faberc/ece-540_wi21_fnl-project/rvfpga/vivado/project_final/project_final.runs/impl_3/.init_design.begin.rst

<?xml version="1.0"?>
<ProcessHandle Version="1" Minor="0">
    <Process Command=".planAhead." Owner="Chuck" Host="DESKTOP-HHTTKMG" Pid="9632">
    </Process>
</ProcessHandle>
