faberc/ece-540_wi21_fnl-project/rvfpga/vivado/project_final/project_final.runs/clk_gen_75M_synth_1/.vivado.begin.rst

<?xml version="1.0"?>
<ProcessHandle Version="1" Minor="0">
    <Process Command="vivado.bat" Owner="Chuck" Host="DESKTOP-HHTTKMG" Pid="44392" HostCore="8" HostMemory="016745943040">
    </Process>
</ProcessHandle>
