faberc/ece-540_wi21_fnl-project/rvfpga/vivado/project_2/project_2.runs/impl_1/.vivado.begin.rst

<?xml version="1.0"?>
<ProcessHandle Version="1" Minor="0">
    <Process Command="vivado.bat" Owner="Chuck" Host="DESKTOP-HHTTKMG" Pid="11348" HostCore="8" HostMemory="016745943040">
    </Process>
</ProcessHandle>
