faberc/ece-540_wi21_fnl-project/rvfpga/vivado/project_2a/project_2a.runs/synth_1/.vivado.begin.rst

<?xml version="1.0"?>
<ProcessHandle Version="1" Minor="0">
    <Process Command="vivado.bat" Owner="Chuck" Host="DESKTOP-HHTTKMG" Pid="26424" HostCore="8" HostMemory="016745943040">
    </Process>
</ProcessHandle>
