faberc/ece-540_wi21_fnl-project/rvfpga/labs/Project1/Project_1_Report.pdf

# Project 1: SimpleBot

Theory of Operations

### Chuck Faber

Portland State University - ECE 540 - Winter 2020

## I. Design Summary

In this project we were tasked with creang a simulaon of a simple 2-wheel robot, with a seven segment display which would display a moon animaon and its compass heading based on the input of 4 buons to control the le and right motors. The compass heading would be determined with dead reckoning, and the project firmware would be implemented using the Nexys A7 Development board, and the soware was to be wrien in RISC-V assembly language.

Several modificaons needed to be made to the firmware to enable hardware, such as the push buons and extended capability of the seven segment display (more characters and addion of decimal points). Primary goals in the soware were responsiveness of the buons and cleanness of the displays with few to no bugs in the display of the headings and moon indicator.

## II. Firmware Modifications

Implementing new GPIO registers

Implementing Buttons in Constraints File
In order to get the push-buons connected, I first had to add their mapping in the firmware constraints file. See Box 1.

Box 1: rvfpga.xdc - Mapping buon pins to new signals in firmware code

Mux Code / New Address Declaration
A new GPIO module needed to be instanated in swervolf_core.v. A new base address for this GPIO module also needed to be included in wb_intercon.v with its own signals, as shown in box 2 below.

## Buttons

set_property -dict { PACKAGE_PIN M18 | IOSTANDARD LVCMOS33 } [get_ports { i_btn_u }];
set_property -dict { PACKAGE_PIN P18 | IOSTANDARD LVCMOS33 } [get_ports { i_btn_d }];
set_property -dict { PACKAGE_PIN P17 | IOSTANDARD LVCMOS33 } [get_ports { i_btn_l }];
set_property -dict { PACKAGE_PIN M17 | IOSTANDARD LVCMOS33 } [get_ports { i_btn_r }];
set_property -dict { PACKAGE_PIN N17 | IOSTANDARD LVCMOS33 } [get_ports { i_btn_c }];

Box 2: wb_intercon.v - Added new base address and column to Wishbone Mux

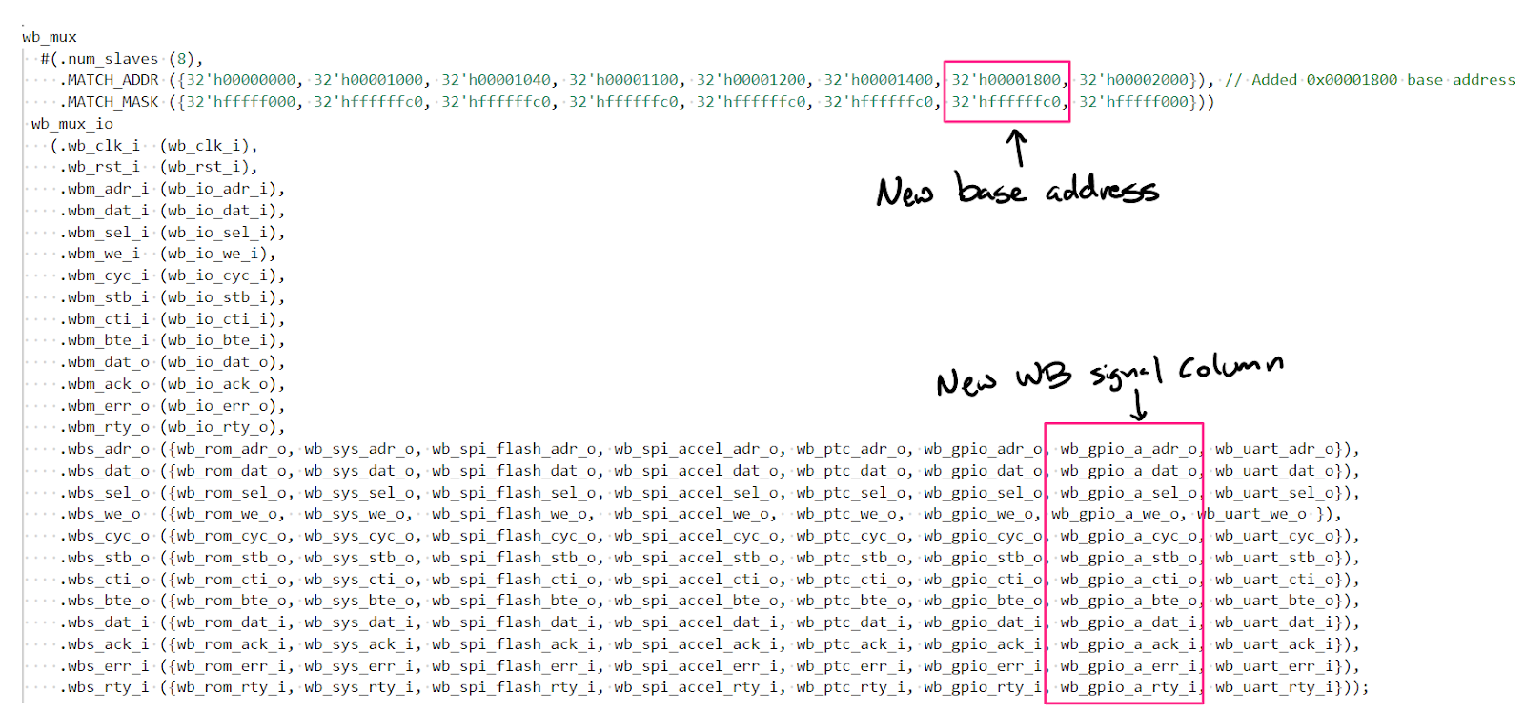
[picture p8: figure]

Passing in the Buttons as an Array
The buons declared in the constraints file needed to be connected to the swervolf_core module through a newly declared 32 bit io_data port which was done as follows. Note that the unused 27 most significant bits allows future addion of new peripherals to this GPIO module as shown in box 3. Also the order in which the buons inputs are passed to the io_data port are important to consider as well, as they will determine how to decode the values read from the new GPIO module’s register.

Box 3: rvfpga.sv - swervolf_core instanaon -- passing in buon press inputs to second gpio port

Seven Segment Display
The project requirements ask us to implement new characters to be used for the seven segment display. The current decoder only took 4 bits in, which allowed us to choose between 16 different characters, so to expand the number of possible characters, we had to expand this input to 8 bits.

The goal was to implement all the characters with their associated values from Table 2 of the project descripon which added 16 addional characters to be able to be displayed.

The current method in which the seven segment decoder was implemented was to use a single 32 bit Digits_Reg to store 8 groups of 4-bit segments, each which was responsible for a single digit in the seven-segment display.

Instead, I wanted each byte to represent a single digit on the SSD, and so I would need a second Digits_Reg register. For example, to write the number 76543210 to the SSD, I would store the following values in Digits_Reg1 and Digits_Reg2:

.io_data | ({i_sw[15:0],gpio_out[15:0]}),
.io_data_a | ({27'bz,i_btn_u,i_btn_d,i_btn_l,i_btn_r,i_btn_c}),

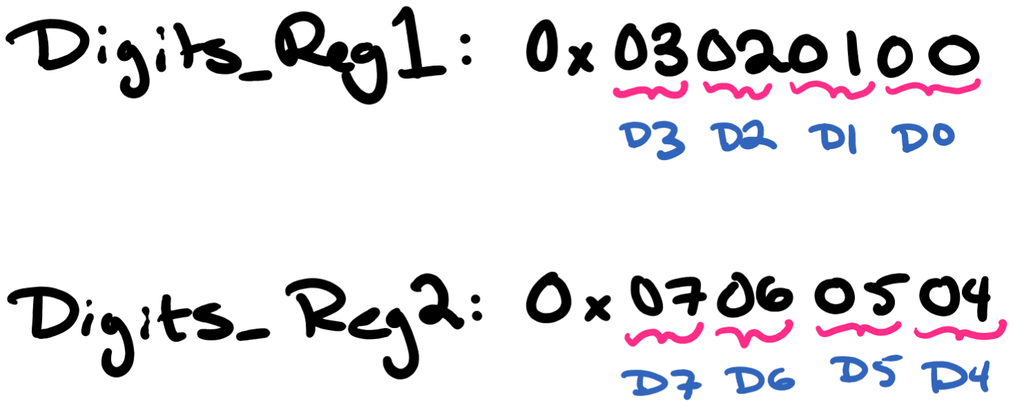
[picture p9: figure]

And each register would correspond to the following digits on the SSD:

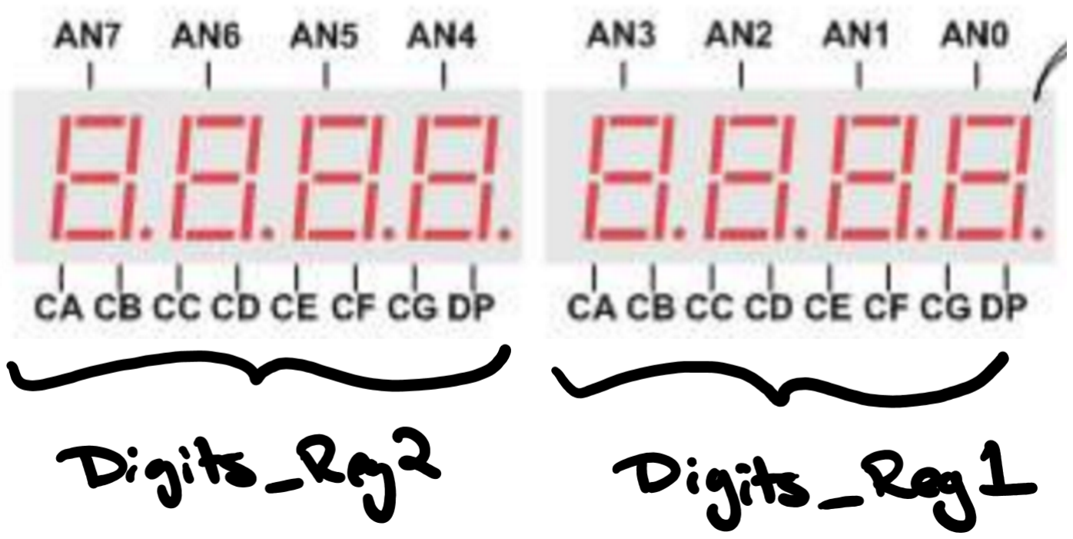
[picture p10: figure]

Implementing New SSD Digits Register
The Enables_Reg and the Digits_Reg base addresses were implemented in a switch case in swervolf_syscon.v and the looked as follows (note some changes implemented to include a decimal enable funconality into the Enables_Reg):

Box 4: swervolf_syscon.v - Digits_Reg2 and adding 8 bits for decimal point enables in Enables_Reg address

Each case in this switch case represented an offset address with each new case being 4 addresses more than the previous, with a byte select of 0-3. To add a new register, I
implemented a new case at ‘9’ which represented the address 0x80001024, and I had this represent Digits_Reg1 (digits 0-3) and let the prior case at ‘15’ represent Digits_Reg2 (digits 4-7).

We didn’t end up needing digits 4-7 for this project, but I felt it was useful to have them accessible in case we might need them later.

14 : begin //0x38-3B 0x80001038 -- LSB is digit enables, 2nd byte is decimal enables. if (i_wb_sel[0]) Enables_Reg[7:0] <= i_wb_dat[7:0];
if (i_wb_sel[1]) Decimals_Reg[7:0] <= i_wb_dat[15:8];
end
15 : begin //0x3C-3F 0x8000103C for second digits reg.
if (i_wb_sel[0]) Digits_Reg2[7:0] <= i_wb_dat[7:0]; if (i_wb_sel[1]) Digits_Reg2[15:8] <= i_wb_dat[15:8]; if (i_wb_sel[2]) Digits_Reg2[23:16] <= i_wb_dat[23:16]; if (i_wb_sel[3]) Digits_Reg2[31:24] <= i_wb_dat[31:24]; end

Box 5: swervolf_syscon.v - Added new case/address (0x80001024) for new Digits_Reg

Implementing decimal point enables
As with the push buons, the first thing needed to implement decimal point funconality was to enable it in the constraints file. In our case it only required uncommenng a line.

Box 6: rvfpga.xdc - Mapping decimal point cathode to DP signal in firmware

Adding the 8 bit enable to the prior digits Enable Register
For decimal point funconality, I needed a place in memory to store which digits had their decimal points enabled, so I added this funconality to the already exisng Enable_Reg base address, since only the 8 least significant bits were being used to enable or disable the digits. I used the next byte as a select for whether or not a decimal would be enabled. See code in Box 4. Adding the SevSegMux
The decimal point requires its own seven segment me mulplexer which outputs to the single bit wide DP signal, similar to how the other cathode segments are implemented. This was implemented as follows below in box 6.

Box 7: swervolf_syscon.v - Instanaon of SevSegMux that reads Decimals_Reg and outputs me muxed DP signal

// Added new register to accommodate more digits.
9 : begin //0x24-27 Addresses 0x80001024 for first digits reg if (i_wb_sel[0]) Digits_Reg1[7:0] <= i_wb_dat[7:0]; if (i_wb_sel[1]) Digits_Reg1[15:8] <= i_wb_dat[15:8]; if (i_wb_sel[2]) Digits_Reg1[23:16] <= i_wb_dat[23:16]; if (i_wb_sel[3]) Digits_Reg1[31:24] <= i_wb_dat[31:24]; end

set_property -dict { PACKAGE_PIN H15 IOSTANDARD LVCMOS33 } [get_ports { DP }]; #IO_L19N_T3_A21_VREF_15 Sch=dp

SevSegMux
#(

.DATA_WIDTH(1),
.N_IN(8)
)
Select_Decimals
(
.IN_DATA(decimal),
.OUT_DATA(DP),
.SEL(countSelection[(COUNT_MAX-1):(COUNT_MAX-3)]) );

## III. Software

Aer the hardware had been modified, the soware needed to be implemented. The soware was wrien in the RISC-V assembly language. A full flowchart describing the how the main loop of the program was implemented can be found below.

In summary, a forever loop runs, each me reading the combinaon of buon presses to direct it to the appropriate case in a switch case statement. Counters are incremented on each run through the loop, and condionals check whether these counters hit an appropriate value to simulate the 5 Hz or 10 Hz updates required for the compass and moon indicators.

This method was used to ensure the program remained fast and responsive to user input, as the buon value is checked upon every single loop and there are no me intensive loops where the program could get stuck doing something and not be able to read user input. Using condional checks to implement the 5Hz and 10Hz updates makes each run through the loop before the next buon check faster.
Flow Chart Diagram of Main Loop
See Appendix A for a full flow chart of the soware design.
Jump Tree and Button Mapping
As menoned earlier, the buon inputs are mapped to the lowest 5 significant bits of the new GPIO input register as follows: {i_btn_u,i_btn_d,i_btn_l,i_btn_r,i_btn_c}. On each loop of the main funcon, we must read in the register, mask all but the lowest 5 bits, and for this assignment, we logically shi the value to the right to eliminate the center buon press so we only have to deal with 4 bits instead of 5.

This gives us a possible value range of 0 to 15, or b0000 to b1111. Using the requirements of the project, I mapped the combinaons of buon presses to each of the 7 possible moon modes: forward, reverse, le at 1x speed, le at 2x speed, right at 1x speed, right at 2x speed, and stopped. I then extrapolated the binary value that would appear in the GPIO register in each of these combinaons and converted them to decimal values.

My assembly switch case compares the value to the defined decimal values in the third table below to choose the appropriate branch to take in the main loop.

Table 1: Mapping of moon modes to buon presses according to project requirements.

Table 2: Binary values that would be present in the register for each mode

Table 3: Conversion of binary values to decimal values for switch case

Moon Modes
Forward | Reverse | Le 1x | Le 2x | Right 1x | Right 2x | Stop
BTNL+BTNR | BTNU+BTND | BTNR | BTNR+BTNU | BTNL | BTNL+BTND | None
| | BTNU | | BTND | | BTNL+BTNU
| | BTNR+BTND+ BTNU | | BTNR+BTND+ BTNL | | BTNR+BTND
| | BTNL+BTNU+ BTNR | | BTNL+BTNU+ BTND | | BTNU+BTND+ BTNL+BTNR

Binary Values
Forward | Reverse | Le 1x | Le 2x | Right 1x | Right 2x | Stop
0011 | 1100 | 0001 | 1001 | 0010 | 0110 | 0000
| | 1000 | | 0100 | | 0101
| | 1011 | | 0111 | | 1010
| | 1101 | | 1110 | | 1111

Decimal Values
Forward | Reverse | Le 1x | Le 2x | Right 1x | Right 2x | Stop
3 | 12 | 1 | 9 | 2 | 6 | 0
| | 8 | | 4 | | 5
| | 11 | | 7 | | 10
| | 13 | | 14 | | 15

Below is a snippet of the assembly code used to code the switch case or jump tree: Box 8: project1_asm.s - Jump tree code from soware in RISC-V assembly code

hex2bcd Function
In addion to the main loop, I implemented a funcon in the assembly code which would convert a literal value (in hex or decimal) to its display in binary coded decimal. Below you can view the pseudocode of the hex2bcd funcon. Actual implementaon was done in RISC-V assembly.

Box 9: Pseudocode for the hex2bcd funcon.

loop:
li t0, GPIO_A_IN | # Address to read button presses
lw t1, 0(t0) | # Read button press values
andi t1, t1, 0x1F | # Mask just the lowest 5 bits
srli t1, t1, 1 | # Shift all bits to right by 1 (masking center push button)

# Jump Tree Here:

li t2, SEV_SEG_DIG1 | # Address to SSD digit display 0-3
li t3, 3 | # If t1 == 3 jump to forward
beq t3, t1, forward
li t3, 12 | # If t1 == 12 jump to reverse
beq t3, t1, reverse
j | stop | # Else go to stop

function hex2bcd (int val): if val >= 100:
for (i = 3; i > 0; i--)
if val >= i*100:
write i to DisplayRegister[Byte 2] val -= i*100
break
else:
write 0 to DisplayRegister[Byte 2] if val >= 10:
for (i = 9; i > 0; i--)
if val >= i*10:
write i to DisplayRegister[Byte 1] val -= i*10
break
else:
write 0 to DisplayRegister[Byte 1] write val to DisplayRegister[Byte 0]

## Appendix A - Software Flow Chart

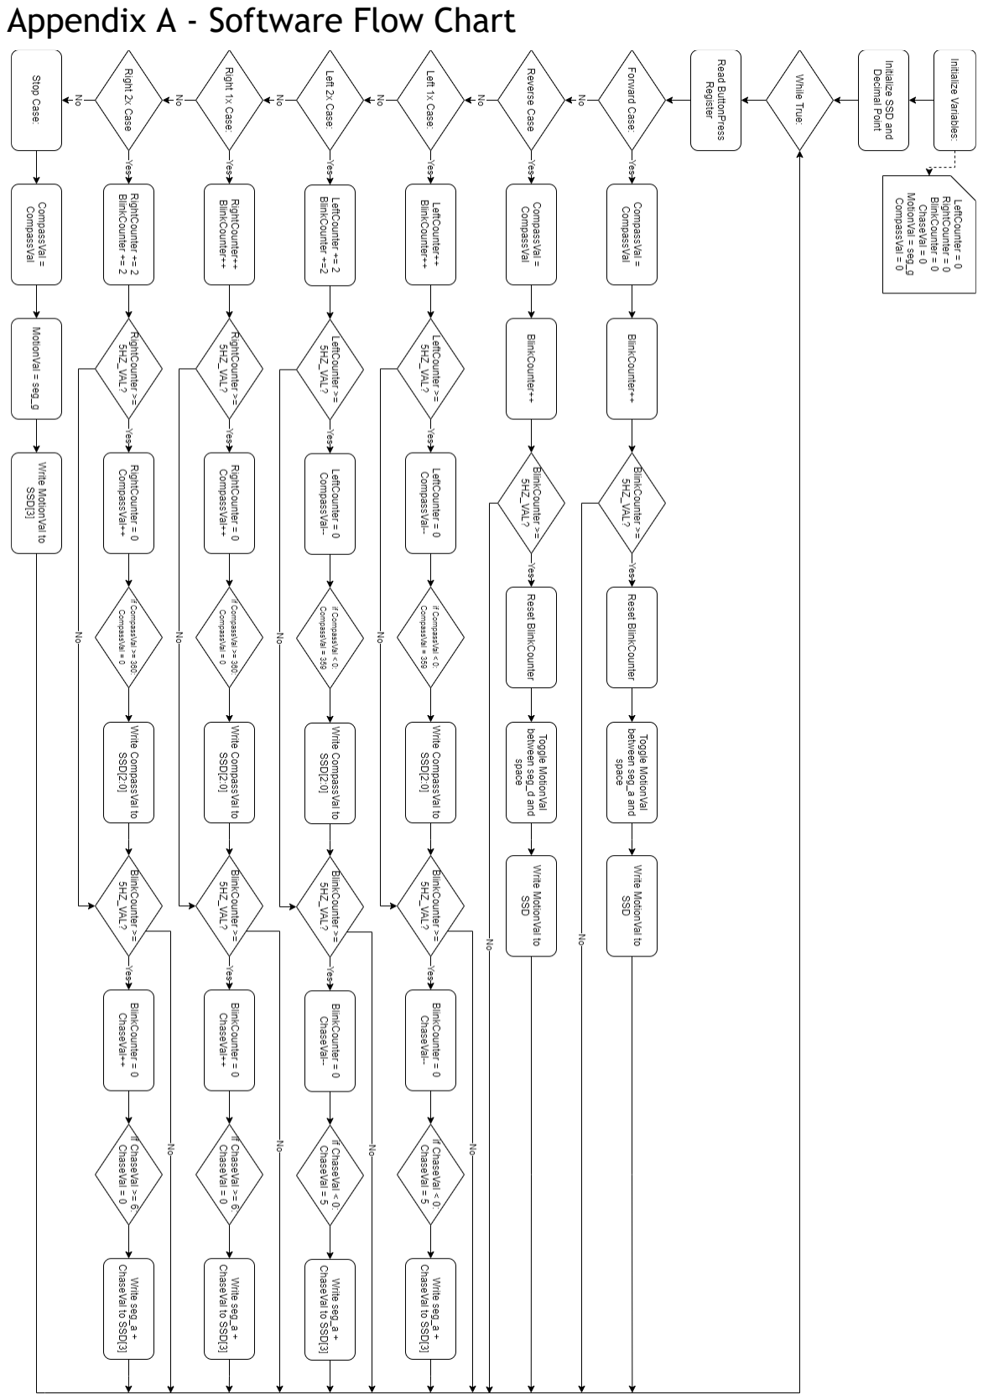
[picture p11: page 8]
