faberc/ece-540_wi21_fnl-project/docs/report/ECE540_HW_future.png

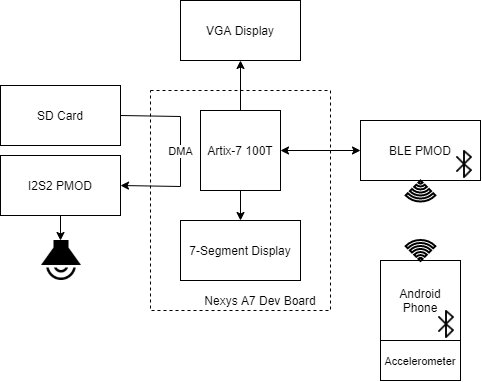
docs/report/ECE540_HW_future.png
