faberc/ece-540_wi21_fnl-project/docs/report/ece540_ropedown.png

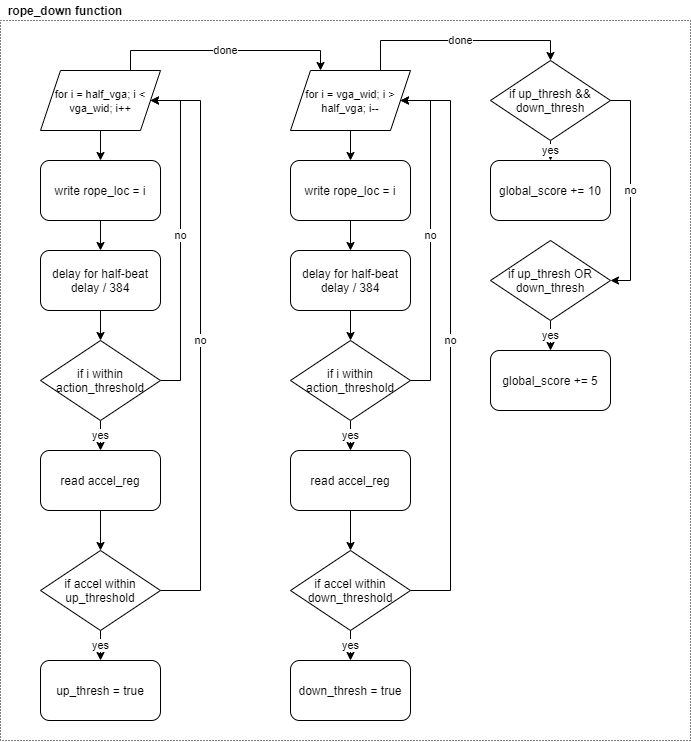
docs/report/ece540_ropedown.png
