faberc/ece-540_wi21_fnl-project/docs/report/ECE540_ropegame_hw.png

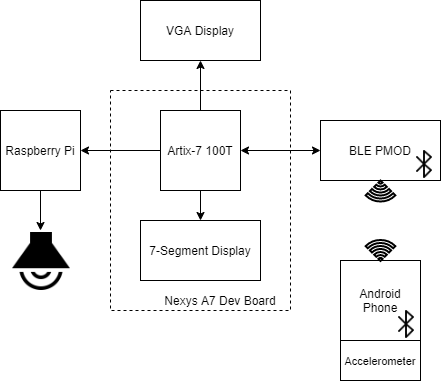
docs/report/ECE540_ropegame_hw.png
