faberc/ece-540_wi21_fnl-project/docs/report/ECE540_ropemain.png

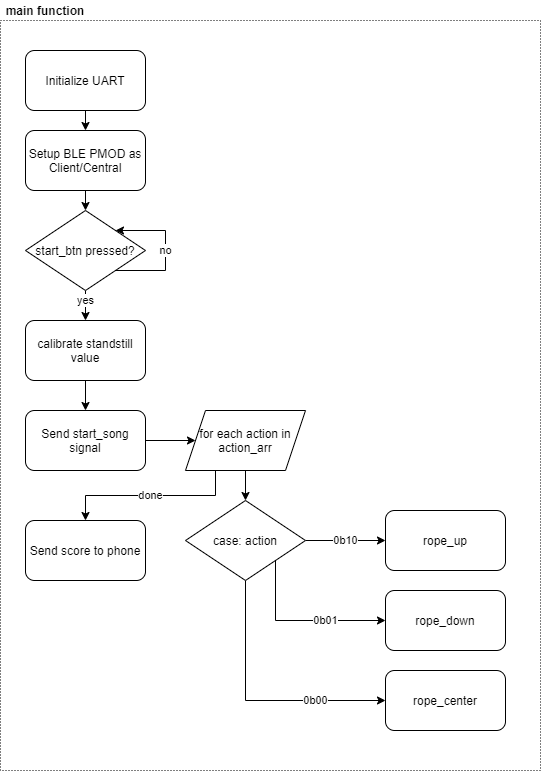
docs/report/ECE540_ropemain.png
