faberc/ece-540_wi21_fnl-project/docs/report/rope_game_diagram.png

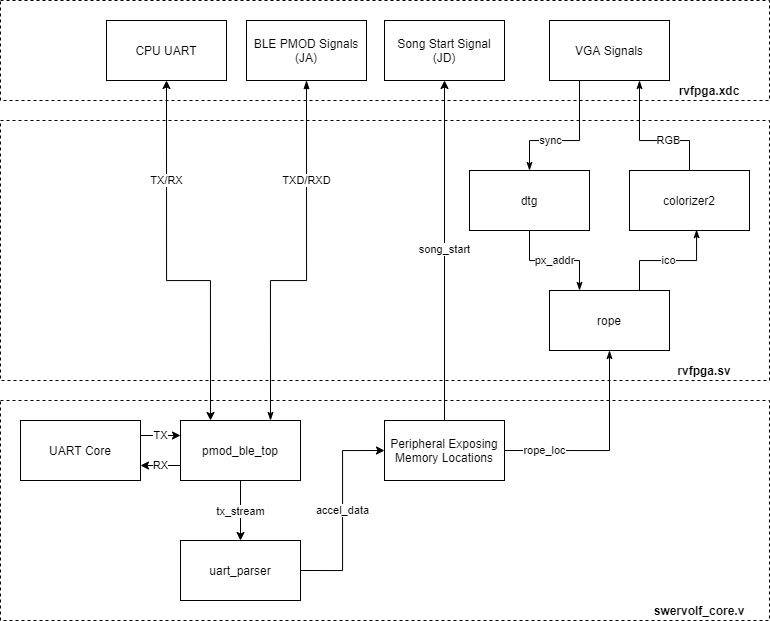
docs/report/rope_game_diagram.png
