faberc/ece-540_wi21_fnl-project/(list of files, cad)

Other CAD files:
botip/firmware/bot31_pgm.psm
