faberc/ece-540_wi21_fnl-project/rvfpga/vivado/project_2/project_2.runs/impl_1/tight_setup_hold_pins.txt

+--------------------------+--------------------------+----------------------------------------------------------------------------------------------------------+
|       Launch Clock       |      Capture Clock       |                                                 Pin                                                      |
+--------------------------+--------------------------+----------------------------------------------------------------------------------------------------------+
|    o_clk_75M_clk_gen_75M |              sys_clk_pin |                                                                                     io_botupdt_sync_reg/D|
|                 clk_core |                 clk_core |                                    swervolf/swerv_eh1/swerv/lsu/clkdomain/lsu_free_cgc/clkhdr/en_ff_reg/D|
+--------------------------+--------------------------+----------------------------------------------------------------------------------------------------------+
