faberc/ece-540_wi21_fnl-project/rvfpga/vivado/project_final/project_final.runs/synth_3/.Xil/rvfpga_propImpl.xdc

set_property SRC_FILE_INFO {cfile:C:/Users/Chuck/ECE540/fnlproj-team-tbc/rvfpga/src/liteDRAM.xdc rfile:../../../../../src/liteDRAM.xdc id:1} [current_design]
set_property SRC_FILE_INFO {cfile:C:/Users/Chuck/ECE540/fnlproj-team-tbc/rvfpga/src/rvfpga.xdc rfile:../../../../../src/rvfpga.xdc id:2} [current_design]
set_property src_info {type:XDC file:1 line:1 export:INPUT save:INPUT read:READ} [current_design]
set_property PACKAGE_PIN U9 [get_ports {ddram_dqs_p[0]}]
set_property src_info {type:XDC file:1 line:2 export:INPUT save:INPUT read:READ} [current_design]
set_property PACKAGE_PIN V9 [get_ports {ddram_dqs_n[0]}]
set_property src_info {type:XDC file:1 line:3 export:INPUT save:INPUT read:READ} [current_design]
set_property PACKAGE_PIN U2 [get_ports {ddram_dqs_p[1]}]
set_property src_info {type:XDC file:1 line:4 export:INPUT save:INPUT read:READ} [current_design]
set_property PACKAGE_PIN V2 [get_ports {ddram_dqs_n[1]}]
set_property src_info {type:XDC file:1 line:6 export:INPUT save:INPUT read:READ} [current_design]
set_property PACKAGE_PIN M4 [get_ports {ddram_a[0]}]
set_property src_info {type:XDC file:1 line:10 export:INPUT save:INPUT read:READ} [current_design]
set_property PACKAGE_PIN P4 [get_ports {ddram_a[1]}]
set_property src_info {type:XDC file:1 line:14 export:INPUT save:INPUT read:READ} [current_design]
set_property PACKAGE_PIN M6 [get_ports {ddram_a[2]}]
set_property src_info {type:XDC file:1 line:18 export:INPUT save:INPUT read:READ} [current_design]
set_property PACKAGE_PIN T1 [get_ports {ddram_a[3]}]
set_property src_info {type:XDC file:1 line:22 export:INPUT save:INPUT read:READ} [current_design]
set_property PACKAGE_PIN L3 [get_ports {ddram_a[4]}]
set_property src_info {type:XDC file:1 line:26 export:INPUT save:INPUT read:READ} [current_design]
set_property PACKAGE_PIN P5 [get_ports {ddram_a[5]}]
set_property src_info {type:XDC file:1 line:30 export:INPUT save:INPUT read:READ} [current_design]
set_property PACKAGE_PIN M2 [get_ports {ddram_a[6]}]
set_property src_info {type:XDC file:1 line:34 export:INPUT save:INPUT read:READ} [current_design]
set_property PACKAGE_PIN N1 [get_ports {ddram_a[7]}]
set_property src_info {type:XDC file:1 line:38 export:INPUT save:INPUT read:READ} [current_design]
set_property PACKAGE_PIN L4 [get_ports {ddram_a[8]}]
set_property src_info {type:XDC file:1 line:42 export:INPUT save:INPUT read:READ} [current_design]
set_property PACKAGE_PIN N5 [get_ports {ddram_a[9]}]
set_property src_info {type:XDC file:1 line:46 export:INPUT save:INPUT read:READ} [current_design]
set_property PACKAGE_PIN R2 [get_ports {ddram_a[10]}]
set_property src_info {type:XDC file:1 line:50 export:INPUT save:INPUT read:READ} [current_design]
set_property PACKAGE_PIN K5 [get_ports {ddram_a[11]}]
set_property src_info {type:XDC file:1 line:54 export:INPUT save:INPUT read:READ} [current_design]
set_property PACKAGE_PIN N6 [get_ports {ddram_a[12]}]
set_property src_info {type:XDC file:1 line:58 export:INPUT save:INPUT read:READ} [current_design]
set_property PACKAGE_PIN P2 [get_ports {ddram_ba[0]}]
set_property src_info {type:XDC file:1 line:62 export:INPUT save:INPUT read:READ} [current_design]
set_property PACKAGE_PIN P3 [get_ports {ddram_ba[1]}]
set_property src_info {type:XDC file:1 line:66 export:INPUT save:INPUT read:READ} [current_design]
set_property PACKAGE_PIN R1 [get_ports {ddram_ba[2]}]
set_property src_info {type:XDC file:1 line:70 export:INPUT save:INPUT read:READ} [current_design]
set_property PACKAGE_PIN N4 [get_ports ddram_ras_n]
set_property src_info {type:XDC file:1 line:74 export:INPUT save:INPUT read:READ} [current_design]
set_property PACKAGE_PIN L1 [get_ports ddram_cas_n]
set_property src_info {type:XDC file:1 line:78 export:INPUT save:INPUT read:READ} [current_design]
set_property PACKAGE_PIN N2 [get_ports ddram_we_n]
set_property src_info {type:XDC file:1 line:82 export:INPUT save:INPUT read:READ} [current_design]
set_property PACKAGE_PIN T6 [get_ports {ddram_dm[0]}]
set_property src_info {type:XDC file:1 line:86 export:INPUT save:INPUT read:READ} [current_design]
set_property PACKAGE_PIN U1 [get_ports {ddram_dm[1]}]
set_property src_info {type:XDC file:1 line:90 export:INPUT save:INPUT read:READ} [current_design]
set_property PACKAGE_PIN R7 [get_ports {ddram_dq[0]}]
set_property src_info {type:XDC file:1 line:95 export:INPUT save:INPUT read:READ} [current_design]
set_property PACKAGE_PIN V6 [get_ports {ddram_dq[1]}]
set_property src_info {type:XDC file:1 line:100 export:INPUT save:INPUT read:READ} [current_design]
set_property PACKAGE_PIN R8 [get_ports {ddram_dq[2]}]
set_property src_info {type:XDC file:1 line:105 export:INPUT save:INPUT read:READ} [current_design]
set_property PACKAGE_PIN U7 [get_ports {ddram_dq[3]}]
set_property src_info {type:XDC file:1 line:110 export:INPUT save:INPUT read:READ} [current_design]
set_property PACKAGE_PIN V7 [get_ports {ddram_dq[4]}]
set_property src_info {type:XDC file:1 line:115 export:INPUT save:INPUT read:READ} [current_design]
set_property PACKAGE_PIN R6 [get_ports {ddram_dq[5]}]
set_property src_info {type:XDC file:1 line:120 export:INPUT save:INPUT read:READ} [current_design]
set_property PACKAGE_PIN U6 [get_ports {ddram_dq[6]}]
set_property src_info {type:XDC file:1 line:125 export:INPUT save:INPUT read:READ} [current_design]
set_property PACKAGE_PIN R5 [get_ports {ddram_dq[7]}]
set_property src_info {type:XDC file:1 line:130 export:INPUT save:INPUT read:READ} [current_design]
set_property PACKAGE_PIN T5 [get_ports {ddram_dq[8]}]
set_property src_info {type:XDC file:1 line:135 export:INPUT save:INPUT read:READ} [current_design]
set_property PACKAGE_PIN U3 [get_ports {ddram_dq[9]}]
set_property src_info {type:XDC file:1 line:140 export:INPUT save:INPUT read:READ} [current_design]
set_property PACKAGE_PIN V5 [get_ports {ddram_dq[10]}]
set_property src_info {type:XDC file:1 line:145 export:INPUT save:INPUT read:READ} [current_design]
set_property PACKAGE_PIN U4 [get_ports {ddram_dq[11]}]
set_property src_info {type:XDC file:1 line:150 export:INPUT save:INPUT read:READ} [current_design]
set_property PACKAGE_PIN V4 [get_ports {ddram_dq[12]}]
set_property src_info {type:XDC file:1 line:155 export:INPUT save:INPUT read:READ} [current_design]
set_property PACKAGE_PIN T4 [get_ports {ddram_dq[13]}]
set_property src_info {type:XDC file:1 line:160 export:INPUT save:INPUT read:READ} [current_design]
set_property PACKAGE_PIN V1 [get_ports {ddram_dq[14]}]
set_property src_info {type:XDC file:1 line:165 export:INPUT save:INPUT read:READ} [current_design]
set_property PACKAGE_PIN T3 [get_ports {ddram_dq[15]}]
set_property src_info {type:XDC file:1 line:185 export:INPUT save:INPUT read:READ} [current_design]
set_property PACKAGE_PIN L6 [get_ports ddram_clk_p]
set_property src_info {type:XDC file:1 line:186 export:INPUT save:INPUT read:READ} [current_design]
set_property PACKAGE_PIN L5 [get_ports ddram_clk_n]
set_property src_info {type:XDC file:1 line:190 export:INPUT save:INPUT read:READ} [current_design]
set_property PACKAGE_PIN M1 [get_ports ddram_cke]
set_property src_info {type:XDC file:1 line:194 export:INPUT save:INPUT read:READ} [current_design]
set_property PACKAGE_PIN M3 [get_ports ddram_odt]
set_property src_info {type:XDC file:1 line:198 export:INPUT save:INPUT read:READ} [current_design]
set_property PACKAGE_PIN K6 [get_ports ddram_cs_n]
set_property src_info {type:XDC file:2 line:12 export:INPUT save:INPUT read:READ} [current_design]
set_property -dict {PACKAGE_PIN E3 IOSTANDARD LVCMOS33} [get_ports clk]
set_property src_info {type:XDC file:2 line:14 export:INPUT save:INPUT read:READ} [current_design]
set_property -dict {PACKAGE_PIN C12 IOSTANDARD LVCMOS33} [get_ports rstn]
set_property src_info {type:XDC file:2 line:16 export:INPUT save:INPUT read:READ} [current_design]
set_property -dict {PACKAGE_PIN C4 IOSTANDARD LVCMOS33} [get_ports i_uart_rx]
set_property src_info {type:XDC file:2 line:17 export:INPUT save:INPUT read:READ} [current_design]
set_property -dict {PACKAGE_PIN D4 IOSTANDARD LVCMOS33} [get_ports o_uart_tx]
set_property src_info {type:XDC file:2 line:20 export:INPUT save:INPUT read:READ} [current_design]
set_property -dict {PACKAGE_PIN K17 IOSTANDARD LVCMOS33} [get_ports o_flash_mosi]
set_property src_info {type:XDC file:2 line:21 export:INPUT save:INPUT read:READ} [current_design]
set_property -dict {PACKAGE_PIN K18 IOSTANDARD LVCMOS33} [get_ports i_flash_miso]
set_property src_info {type:XDC file:2 line:24 export:INPUT save:INPUT read:READ} [current_design]
set_property -dict {PACKAGE_PIN L13 IOSTANDARD LVCMOS33} [get_ports o_flash_cs_n]
set_property src_info {type:XDC file:2 line:26 export:INPUT save:INPUT read:READ} [current_design]
set_property -dict {PACKAGE_PIN J15 IOSTANDARD LVCMOS33} [get_ports {i_sw[0]}]
set_property src_info {type:XDC file:2 line:27 export:INPUT save:INPUT read:READ} [current_design]
set_property -dict {PACKAGE_PIN L16 IOSTANDARD LVCMOS33} [get_ports {i_sw[1]}]
set_property src_info {type:XDC file:2 line:28 export:INPUT save:INPUT read:READ} [current_design]
set_property -dict {PACKAGE_PIN M13 IOSTANDARD LVCMOS33} [get_ports {i_sw[2]}]
set_property src_info {type:XDC file:2 line:29 export:INPUT save:INPUT read:READ} [current_design]
set_property -dict {PACKAGE_PIN R15 IOSTANDARD LVCMOS33} [get_ports {i_sw[3]}]
set_property src_info {type:XDC file:2 line:30 export:INPUT save:INPUT read:READ} [current_design]
set_property -dict {PACKAGE_PIN R17 IOSTANDARD LVCMOS33} [get_ports {i_sw[4]}]
set_property src_info {type:XDC file:2 line:31 export:INPUT save:INPUT read:READ} [current_design]
set_property -dict {PACKAGE_PIN T18 IOSTANDARD LVCMOS33} [get_ports {i_sw[5]}]
set_property src_info {type:XDC file:2 line:32 export:INPUT save:INPUT read:READ} [current_design]
set_property -dict {PACKAGE_PIN U18 IOSTANDARD LVCMOS33} [get_ports {i_sw[6]}]
set_property src_info {type:XDC file:2 line:33 export:INPUT save:INPUT read:READ} [current_design]
set_property -dict {PACKAGE_PIN R13 IOSTANDARD LVCMOS33} [get_ports {i_sw[7]}]
set_property src_info {type:XDC file:2 line:34 export:INPUT save:INPUT read:READ} [current_design]
set_property -dict {PACKAGE_PIN T8 IOSTANDARD LVCMOS18} [get_ports {i_sw[8]}]
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
set_property -dict {PACKAGE_PIN T10 IOSTANDARD LVCMOS33} [get_ports CA]
set_property src_info {type:XDC file:2 line:62 export:INPUT save:INPUT read:READ} [current_design]
set_property -dict {PACKAGE_PIN R10 IOSTANDARD LVCMOS33} [get_ports CB]
set_property src_info {type:XDC file:2 line:63 export:INPUT save:INPUT read:READ} [current_design]
set_property -dict {PACKAGE_PIN K16 IOSTANDARD LVCMOS33} [get_ports CC]
set_property src_info {type:XDC file:2 line:64 export:INPUT save:INPUT read:READ} [current_design]
set_property -dict {PACKAGE_PIN K13 IOSTANDARD LVCMOS33} [get_ports CD]
set_property src_info {type:XDC file:2 line:65 export:INPUT save:INPUT read:READ} [current_design]
set_property -dict {PACKAGE_PIN P15 IOSTANDARD LVCMOS33} [get_ports CE]
set_property src_info {type:XDC file:2 line:66 export:INPUT save:INPUT read:READ} [current_design]
set_property -dict {PACKAGE_PIN T11 IOSTANDARD LVCMOS33} [get_ports CF]
set_property src_info {type:XDC file:2 line:67 export:INPUT save:INPUT read:READ} [current_design]
set_property -dict {PACKAGE_PIN L18 IOSTANDARD LVCMOS33} [get_ports CG]
set_property src_info {type:XDC file:2 line:68 export:INPUT save:INPUT read:READ} [current_design]
set_property -dict {PACKAGE_PIN H15 IOSTANDARD LVCMOS33} [get_ports DP]
set_property src_info {type:XDC file:2 line:70 export:INPUT save:INPUT read:READ} [current_design]
set_property -dict {PACKAGE_PIN J17 IOSTANDARD LVCMOS33} [get_ports {AN[0]}]
set_property src_info {type:XDC file:2 line:71 export:INPUT save:INPUT read:READ} [current_design]
set_property -dict {PACKAGE_PIN J18 IOSTANDARD LVCMOS33} [get_ports {AN[1]}]
set_property src_info {type:XDC file:2 line:72 export:INPUT save:INPUT read:READ} [current_design]
set_property -dict {PACKAGE_PIN T9 IOSTANDARD LVCMOS33} [get_ports {AN[2]}]
set_property src_info {type:XDC file:2 line:73 export:INPUT save:INPUT read:READ} [current_design]
set_property -dict {PACKAGE_PIN J14 IOSTANDARD LVCMOS33} [get_ports {AN[3]}]
set_property src_info {type:XDC file:2 line:74 export:INPUT save:INPUT read:READ} [current_design]
set_property -dict {PACKAGE_PIN P14 IOSTANDARD LVCMOS33} [get_ports {AN[4]}]
set_property src_info {type:XDC file:2 line:75 export:INPUT save:INPUT read:READ} [current_design]
set_property -dict {PACKAGE_PIN T14 IOSTANDARD LVCMOS33} [get_ports {AN[5]}]
set_property src_info {type:XDC file:2 line:76 export:INPUT save:INPUT read:READ} [current_design]
set_property -dict {PACKAGE_PIN K2 IOSTANDARD LVCMOS33} [get_ports {AN[6]}]
set_property src_info {type:XDC file:2 line:77 export:INPUT save:INPUT read:READ} [current_design]
set_property -dict {PACKAGE_PIN U13 IOSTANDARD LVCMOS33} [get_ports {AN[7]}]
set_property src_info {type:XDC file:2 line:80 export:INPUT save:INPUT read:READ} [current_design]
set_property -dict {PACKAGE_PIN E15 IOSTANDARD LVCMOS33} [get_ports i_accel_miso]
set_property src_info {type:XDC file:2 line:81 export:INPUT save:INPUT read:READ} [current_design]
set_property -dict {PACKAGE_PIN F14 IOSTANDARD LVCMOS33} [get_ports o_accel_mosi]
set_property src_info {type:XDC file:2 line:82 export:INPUT save:INPUT read:READ} [current_design]
set_property -dict {PACKAGE_PIN F15 IOSTANDARD LVCMOS33} [get_ports accel_sclk]
set_property src_info {type:XDC file:2 line:83 export:INPUT save:INPUT read:READ} [current_design]
set_property -dict {PACKAGE_PIN D15 IOSTANDARD LVCMOS33} [get_ports o_accel_cs_n]
set_property src_info {type:XDC file:2 line:86 export:INPUT save:INPUT read:READ} [current_design]
set_property -dict {PACKAGE_PIN M18 IOSTANDARD LVCMOS33} [get_ports i_btn_u]
set_property src_info {type:XDC file:2 line:87 export:INPUT save:INPUT read:READ} [current_design]
set_property -dict {PACKAGE_PIN P18 IOSTANDARD LVCMOS33} [get_ports i_btn_d]
set_property src_info {type:XDC file:2 line:88 export:INPUT save:INPUT read:READ} [current_design]
set_property -dict {PACKAGE_PIN P17 IOSTANDARD LVCMOS33} [get_ports i_btn_l]
set_property src_info {type:XDC file:2 line:89 export:INPUT save:INPUT read:READ} [current_design]
set_property -dict {PACKAGE_PIN M17 IOSTANDARD LVCMOS33} [get_ports i_btn_r]
set_property src_info {type:XDC file:2 line:90 export:INPUT save:INPUT read:READ} [current_design]
set_property -dict {PACKAGE_PIN N17 IOSTANDARD LVCMOS33} [get_ports i_btn_c]
set_property src_info {type:XDC file:2 line:93 export:INPUT save:INPUT read:READ} [current_design]
set_property -dict {PACKAGE_PIN A3 IOSTANDARD LVCMOS33} [get_ports {RED[0]}]
set_property src_info {type:XDC file:2 line:94 export:INPUT save:INPUT read:READ} [current_design]
set_property -dict {PACKAGE_PIN B4 IOSTANDARD LVCMOS33} [get_ports {RED[1]}]
set_property src_info {type:XDC file:2 line:95 export:INPUT save:INPUT read:READ} [current_design]
set_property -dict {PACKAGE_PIN C5 IOSTANDARD LVCMOS33} [get_ports {RED[2]}]
set_property src_info {type:XDC file:2 line:96 export:INPUT save:INPUT read:READ} [current_design]
set_property -dict {PACKAGE_PIN A4 IOSTANDARD LVCMOS33} [get_ports {RED[3]}]
set_property src_info {type:XDC file:2 line:98 export:INPUT save:INPUT read:READ} [current_design]
set_property -dict {PACKAGE_PIN C6 IOSTANDARD LVCMOS33} [get_ports {GRN[0]}]
set_property src_info {type:XDC file:2 line:99 export:INPUT save:INPUT read:READ} [current_design]
set_property -dict {PACKAGE_PIN A5 IOSTANDARD LVCMOS33} [get_ports {GRN[1]}]
set_property src_info {type:XDC file:2 line:100 export:INPUT save:INPUT read:READ} [current_design]
set_property -dict {PACKAGE_PIN B6 IOSTANDARD LVCMOS33} [get_ports {GRN[2]}]
set_property src_info {type:XDC file:2 line:101 export:INPUT save:INPUT read:READ} [current_design]
set_property -dict {PACKAGE_PIN A6 IOSTANDARD LVCMOS33} [get_ports {GRN[3]}]
set_property src_info {type:XDC file:2 line:103 export:INPUT save:INPUT read:READ} [current_design]
set_property -dict {PACKAGE_PIN B7 IOSTANDARD LVCMOS33} [get_ports {BLU[0]}]
set_property src_info {type:XDC file:2 line:104 export:INPUT save:INPUT read:READ} [current_design]
set_property -dict {PACKAGE_PIN C7 IOSTANDARD LVCMOS33} [get_ports {BLU[1]}]
set_property src_info {type:XDC file:2 line:105 export:INPUT save:INPUT read:READ} [current_design]
set_property -dict {PACKAGE_PIN D7 IOSTANDARD LVCMOS33} [get_ports {BLU[2]}]
set_property src_info {type:XDC file:2 line:106 export:INPUT save:INPUT read:READ} [current_design]
set_property -dict {PACKAGE_PIN D8 IOSTANDARD LVCMOS33} [get_ports {BLU[3]}]
set_property src_info {type:XDC file:2 line:108 export:INPUT save:INPUT read:READ} [current_design]
set_property -dict {PACKAGE_PIN B11 IOSTANDARD LVCMOS33} [get_ports hsync]
set_property src_info {type:XDC file:2 line:109 export:INPUT save:INPUT read:READ} [current_design]
set_property -dict {PACKAGE_PIN B12 IOSTANDARD LVCMOS33} [get_ports vsync]
set_property src_info {type:XDC file:2 line:112 export:INPUT save:INPUT read:READ} [current_design]
set_property -dict { PACKAGE_PIN A11   IOSTANDARD LVCMOS33 } [get_ports { AUD_PWM }]; #IO_L4N_T0_15 Sch=aud_pwm
set_property src_info {type:XDC file:2 line:113 export:INPUT save:INPUT read:READ} [current_design]
set_property -dict { PACKAGE_PIN D12   IOSTANDARD LVCMOS33 } [get_ports { AUD_SD  }]; #IO_L6P_T0_15 Sch=aud_sd
set_property src_info {type:XDC file:2 line:117 export:INPUT save:INPUT read:READ} [current_design]
set_property -dict {PACKAGE_PIN C17 IOSTANDARD LVCMOS33} [get_ports JA1]
set_property src_info {type:XDC file:2 line:118 export:INPUT save:INPUT read:READ} [current_design]
set_property -dict {PACKAGE_PIN D18 IOSTANDARD LVCMOS33} [get_ports JA2]
set_property src_info {type:XDC file:2 line:119 export:INPUT save:INPUT read:READ} [current_design]
set_property -dict {PACKAGE_PIN E18 IOSTANDARD LVCMOS33} [get_ports JA3]
set_property src_info {type:XDC file:2 line:120 export:INPUT save:INPUT read:READ} [current_design]
set_property -dict {PACKAGE_PIN G17 IOSTANDARD LVCMOS33} [get_ports JA4]
set_property src_info {type:XDC file:2 line:121 export:INPUT save:INPUT read:READ} [current_design]
set_property -dict {PACKAGE_PIN D17 IOSTANDARD LVCMOS33} [get_ports JA7]
set_property src_info {type:XDC file:2 line:122 export:INPUT save:INPUT read:READ} [current_design]
set_property -dict {PACKAGE_PIN E17 IOSTANDARD LVCMOS33} [get_ports JA8]
set_property src_info {type:XDC file:2 line:123 export:INPUT save:INPUT read:READ} [current_design]
set_property -dict {PACKAGE_PIN F18 IOSTANDARD LVCMOS33} [get_ports JA9]
set_property src_info {type:XDC file:2 line:124 export:INPUT save:INPUT read:READ} [current_design]
set_property -dict {PACKAGE_PIN G18 IOSTANDARD LVCMOS33} [get_ports JA10]
set_property src_info {type:XDC file:2 line:147 export:INPUT save:INPUT read:READ} [current_design]
set_property -dict { PACKAGE_PIN H4    IOSTANDARD LVCMOS33 } [get_ports { JD1 }]; #IO_L21N_T3_DQS_35 Sch=jd[1]
set_property src_info {type:XDC file:2 line:177 export:INPUT save:INPUT read:READ} [current_design]
set_false_path -from [get_clocks -of_objects [get_pins clk_gen/PLLE2_BASE_inst/CLKOUT0]] -to [get_clocks -of_objects [get_pins clk_gen_75M/inst/mmcm_adv_inst/CLKOUT0]]
set_property src_info {type:XDC file:2 line:178 export:INPUT save:INPUT read:READ} [current_design]
set_false_path -from [get_clocks -of_objects [get_pins clk_gen_75M/inst/mmcm_adv_inst/CLKOUT0]] -to [get_clocks -of_objects [get_pins clk_gen/PLLE2_BASE_inst/CLKOUT0]]
