faberc/ece-540_wi21_fnl-project/rvfpga/vivado/project_final/project_final.srcs/sources_1/ip/PmodBLE_0/synth/PmodBLE_0.v

// (c) Copyright 1995-2021 Xilinx, Inc. All rights reserved.
// 
// This file contains confidential and proprietary information
// of Xilinx, Inc. and is protected under U.S. and
// international copyright and other intellectual property
// laws.
// 
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
// CRITICAL APPLICATIONS
// Xilinx products are not designed or intended to be fail-
// safe, or for use in any application requiring fail-safe
// performance, such as life-support or safety devices or
// systems, Class III medical devices, nuclear facilities,
// applications related to the deployment of airbags, or any
// other applications that could lead to death, personal
// injury, or severe property or environmental damage
// (individually and collectively, "Critical
// Applications"). Customer assumes the sole risk and
// liability of any use of Xilinx products in Critical
// Applications, subject only to applicable laws and
// regulations governing limitations on product liability.
// 
// THIS COPYRIGHT NOTICE AND DISCLAIMER MUST BE RETAINED AS
// PART OF THIS FILE AT ALL TIMES.
// 
// DO NOT MODIFY THIS FILE.


// IP VLNV: digilentinc.com:IP:PmodBLE:1.0
// IP Revision: 15

(* X_CORE_INFO = "PmodBLE,Vivado 2019.2" *)
(* CHECK_LICENSE_TYPE = "PmodBLE_0,PmodBLE,{}" *)
(* IP_DEFINITION_SOURCE = "IPI" *)
(* DowngradeIPIdentifiedWarnings = "yes" *)
module PmodBLE_0 (
  Pmod_out_pin10_i,
  Pmod_out_pin10_o,
  Pmod_out_pin10_t,
  Pmod_out_pin1_i,
  Pmod_out_pin1_o,
  Pmod_out_pin1_t,
  Pmod_out_pin2_i,
  Pmod_out_pin2_o,
  Pmod_out_pin2_t,
  Pmod_out_pin3_i,
  Pmod_out_pin3_o,
  Pmod_out_pin3_t,
  Pmod_out_pin4_i,
  Pmod_out_pin4_o,
  Pmod_out_pin4_t,
  Pmod_out_pin7_i,
  Pmod_out_pin7_o,
  Pmod_out_pin7_t,
  Pmod_out_pin8_i,
  Pmod_out_pin8_o,
  Pmod_out_pin8_t,
  Pmod_out_pin9_i,
  Pmod_out_pin9_o,
  Pmod_out_pin9_t,
  S_AXI_GPIO_araddr,
  S_AXI_GPIO_arready,
  S_AXI_GPIO_arvalid,
  S_AXI_GPIO_awaddr,
  S_AXI_GPIO_awready,
  S_AXI_GPIO_awvalid,
  S_AXI_GPIO_bready,
  S_AXI_GPIO_bresp,
  S_AXI_GPIO_bvalid,
  S_AXI_GPIO_rdata,
  S_AXI_GPIO_rready,
  S_AXI_GPIO_rresp,
  S_AXI_GPIO_rvalid,
  S_AXI_GPIO_wdata,
  S_AXI_GPIO_wready,
  S_AXI_GPIO_wstrb,
  S_AXI_GPIO_wvalid,
  S_AXI_UART_araddr,
  S_AXI_UART_arready,
  S_AXI_UART_arvalid,
  S_AXI_UART_awaddr,
  S_AXI_UART_awready,
  S_AXI_UART_awvalid,
  S_AXI_UART_bready,
  S_AXI_UART_bresp,
  S_AXI_UART_bvalid,
  S_AXI_UART_rdata,
  S_AXI_UART_rready,
  S_AXI_UART_rresp,
  S_AXI_UART_rvalid,
  S_AXI_UART_wdata,
  S_AXI_UART_wready,
  S_AXI_UART_wstrb,
  S_AXI_UART_wvalid,
  BLE_uart_interrupt,
  s_axi_aclk,
  s_axi_aresetn
);

(* X_INTERFACE_INFO = "digilentinc.com:interface:pmod:1.0 Pmod_out PIN10_I" *)
input wire Pmod_out_pin10_i;
(* X_INTERFACE_INFO = "digilentinc.com:interface:pmod:1.0 Pmod_out PIN10_O" *)
output wire Pmod_out_pin10_o;
(* X_INTERFACE_INFO = "digilentinc.com:interface:pmod:1.0 Pmod_out PIN10_T" *)
output wire Pmod_out_pin10_t;
(* X_INTERFACE_INFO = "digilentinc.com:interface:pmod:1.0 Pmod_out PIN1_I" *)
input wire Pmod_out_pin1_i;
(* X_INTERFACE_INFO = "digilentinc.com:interface:pmod:1.0 Pmod_out PIN1_O" *)
output wire Pmod_out_pin1_o;
(* X_INTERFACE_INFO = "digilentinc.com:interface:pmod:1.0 Pmod_out PIN1_T" *)
output wire Pmod_out_pin1_t;
(* X_INTERFACE_INFO = "digilentinc.com:interface:pmod:1.0 Pmod_out PIN2_I" *)
input wire Pmod_out_pin2_i;
(* X_INTERFACE_INFO = "digilentinc.com:interface:pmod:1.0 Pmod_out PIN2_O" *)
output wire Pmod_out_pin2_o;
(* X_INTERFACE_INFO = "digilentinc.com:interface:pmod:1.0 Pmod_out PIN2_T" *)
output wire Pmod_out_pin2_t;
(* X_INTERFACE_INFO = "digilentinc.com:interface:pmod:1.0 Pmod_out PIN3_I" *)
input wire Pmod_out_pin3_i;
(* X_INTERFACE_INFO = "digilentinc.com:interface:pmod:1.0 Pmod_out PIN3_O" *)
output wire Pmod_out_pin3_o;
(* X_INTERFACE_INFO = "digilentinc.com:interface:pmod:1.0 Pmod_out PIN3_T" *)
output wire Pmod_out_pin3_t;
(* X_INTERFACE_INFO = "digilentinc.com:interface:pmod:1.0 Pmod_out PIN4_I" *)
input wire Pmod_out_pin4_i;
(* X_INTERFACE_INFO = "digilentinc.com:interface:pmod:1.0 Pmod_out PIN4_O" *)
output wire Pmod_out_pin4_o;
(* X_INTERFACE_INFO = "digilentinc.com:interface:pmod:1.0 Pmod_out PIN4_T" *)
output wire Pmod_out_pin4_t;
(* X_INTERFACE_INFO = "digilentinc.com:interface:pmod:1.0 Pmod_out PIN7_I" *)
input wire Pmod_out_pin7_i;
(* X_INTERFACE_INFO = "digilentinc.com:interface:pmod:1.0 Pmod_out PIN7_O" *)
output wire Pmod_out_pin7_o;
(* X_INTERFACE_INFO = "digilentinc.com:interface:pmod:1.0 Pmod_out PIN7_T" *)
output wire Pmod_out_pin7_t;
(* X_INTERFACE_INFO = "digilentinc.com:interface:pmod:1.0 Pmod_out PIN8_I" *)
input wire Pmod_out_pin8_i;
(* X_INTERFACE_INFO = "digilentinc.com:interface:pmod:1.0 Pmod_out PIN8_O" *)
output wire Pmod_out_pin8_o;
(* X_INTERFACE_INFO = "digilentinc.com:interface:pmod:1.0 Pmod_out PIN8_T" *)
output wire Pmod_out_pin8_t;
(* X_INTERFACE_INFO = "digilentinc.com:interface:pmod:1.0 Pmod_out PIN9_I" *)
input wire Pmod_out_pin9_i;
(* X_INTERFACE_INFO = "digilentinc.com:interface:pmod:1.0 Pmod_out PIN9_O" *)
output wire Pmod_out_pin9_o;
(* X_INTERFACE_PARAMETER = "XIL_INTERFACENAME Pmod_out, BUSIF.BOARD_INTERFACE Custom, BOARD.ASSOCIATED_PARAM PMOD" *)
(* X_INTERFACE_INFO = "digilentinc.com:interface:pmod:1.0 Pmod_out PIN9_T" *)
output wire Pmod_out_pin9_t;
(* X_INTERFACE_INFO = "xilinx.com:interface:aximm:1.0 S_AXI_GPIO ARADDR" *)
input wire [8 : 0] S_AXI_GPIO_araddr;
(* X_INTERFACE_INFO = "xilinx.com:interface:aximm:1.0 S_AXI_GPIO ARREADY" *)
output wire S_AXI_GPIO_arready;
(* X_INTERFACE_INFO = "xilinx.com:interface:aximm:1.0 S_AXI_GPIO ARVALID" *)
input wire S_AXI_GPIO_arvalid;
(* X_INTERFACE_INFO = "xilinx.com:interface:aximm:1.0 S_AXI_GPIO AWADDR" *)
input wire [8 : 0] S_AXI_GPIO_awaddr;
(* X_INTERFACE_INFO = "xilinx.com:interface:aximm:1.0 S_AXI_GPIO AWREADY" *)
output wire S_AXI_GPIO_awready;
(* X_INTERFACE_INFO = "xilinx.com:interface:aximm:1.0 S_AXI_GPIO AWVALID" *)
input wire S_AXI_GPIO_awvalid;
(* X_INTERFACE_INFO = "xilinx.com:interface:aximm:1.0 S_AXI_GPIO BREADY" *)
input wire S_AXI_GPIO_bready;
(* X_INTERFACE_INFO = "xilinx.com:interface:aximm:1.0 S_AXI_GPIO BRESP" *)
output wire [1 : 0] S_AXI_GPIO_bresp;
(* X_INTERFACE_INFO = "xilinx.com:interface:aximm:1.0 S_AXI_GPIO BVALID" *)
output wire S_AXI_GPIO_bvalid;
(* X_INTERFACE_INFO = "xilinx.com:interface:aximm:1.0 S_AXI_GPIO RDATA" *)
output wire [31 : 0] S_AXI_GPIO_rdata;
(* X_INTERFACE_INFO = "xilinx.com:interface:aximm:1.0 S_AXI_GPIO RREADY" *)
input wire S_AXI_GPIO_rready;
(* X_INTERFACE_INFO = "xilinx.com:interface:aximm:1.0 S_AXI_GPIO RRESP" *)
output wire [1 : 0] S_AXI_GPIO_rresp;
(* X_INTERFACE_INFO = "xilinx.com:interface:aximm:1.0 S_AXI_GPIO RVALID" *)
output wire S_AXI_GPIO_rvalid;
(* X_INTERFACE_INFO = "xilinx.com:interface:aximm:1.0 S_AXI_GPIO WDATA" *)
input wire [31 : 0] S_AXI_GPIO_wdata;
(* X_INTERFACE_INFO = "xilinx.com:interface:aximm:1.0 S_AXI_GPIO WREADY" *)
output wire S_AXI_GPIO_wready;
(* X_INTERFACE_INFO = "xilinx.com:interface:aximm:1.0 S_AXI_GPIO WSTRB" *)
input wire [3 : 0] S_AXI_GPIO_wstrb;
(* X_INTERFACE_PARAMETER = "XIL_INTERFACENAME S_AXI_GPIO, DATA_WIDTH 32, PROTOCOL AXI4LITE, ID_WIDTH 0, ADDR_WIDTH 12, AWUSER_WIDTH 0, ARUSER_WIDTH 0, WUSER_WIDTH 0, RUSER_WIDTH 0, BUSER_WIDTH 0, READ_WRITE_MODE READ_WRITE, HAS_BURST 0, HAS_LOCK 0, HAS_PROT 0, HAS_CACHE 0, HAS_QOS 0, HAS_REGION 0, HAS_WSTRB 1, HAS_BRESP 1, HAS_RRESP 1, SUPPORTS_NARROW_BURST 0, NUM_READ_OUTSTANDING 1, NUM_WRITE_OUTSTANDING 1, MAX_BURST_LENGTH 1, NUM_READ_THREADS 1, NUM_WRITE_THREADS 1, RUSER_BITS_PER_BYTE 0, WUSER_BITS_PER_BYTE 0, FREQ_HZ 1\
00000000, PHASE 0.000, INSERT_VIP 0" *)
(* X_INTERFACE_INFO = "xilinx.com:interface:aximm:1.0 S_AXI_GPIO WVALID" *)
input wire S_AXI_GPIO_wvalid;
(* X_INTERFACE_INFO = "xilinx.com:interface:aximm:1.0 S_AXI_UART ARADDR" *)
input wire [12 : 0] S_AXI_UART_araddr;
(* X_INTERFACE_INFO = "xilinx.com:interface:aximm:1.0 S_AXI_UART ARREADY" *)
output wire S_AXI_UART_arready;
(* X_INTERFACE_INFO = "xilinx.com:interface:aximm:1.0 S_AXI_UART ARVALID" *)
input wire S_AXI_UART_arvalid;
(* X_INTERFACE_INFO = "xilinx.com:interface:aximm:1.0 S_AXI_UART AWADDR" *)
input wire [12 : 0] S_AXI_UART_awaddr;
(* X_INTERFACE_INFO = "xilinx.com:interface:aximm:1.0 S_AXI_UART AWREADY" *)
output wire S_AXI_UART_awready;
(* X_INTERFACE_INFO = "xilinx.com:interface:aximm:1.0 S_AXI_UART AWVALID" *)
input wire S_AXI_UART_awvalid;
(* X_INTERFACE_INFO = "xilinx.com:interface:aximm:1.0 S_AXI_UART BREADY" *)
input wire S_AXI_UART_bready;
(* X_INTERFACE_INFO = "xilinx.com:interface:aximm:1.0 S_AXI_UART BRESP" *)
output wire [1 : 0] S_AXI_UART_bresp;
(* X_INTERFACE_INFO = "xilinx.com:interface:aximm:1.0 S_AXI_UART BVALID" *)
output wire S_AXI_UART_bvalid;
(* X_INTERFACE_INFO = "xilinx.com:interface:aximm:1.0 S_AXI_UART RDATA" *)
output wire [31 : 0] S_AXI_UART_rdata;
(* X_INTERFACE_INFO = "xilinx.com:interface:aximm:1.0 S_AXI_UART RREADY" *)
input wire S_AXI_UART_rready;
(* X_INTERFACE_INFO = "xilinx.com:interface:aximm:1.0 S_AXI_UART RRESP" *)
output wire [1 : 0] S_AXI_UART_rresp;
(* X_INTERFACE_INFO = "xilinx.com:interface:aximm:1.0 S_AXI_UART RVALID" *)
output wire S_AXI_UART_rvalid;
(* X_INTERFACE_INFO = "xilinx.com:interface:aximm:1.0 S_AXI_UART WDATA" *)
input wire [31 : 0] S_AXI_UART_wdata;
(* X_INTERFACE_INFO = "xilinx.com:interface:aximm:1.0 S_AXI_UART WREADY" *)
output wire S_AXI_UART_wready;
(* X_INTERFACE_INFO = "xilinx.com:interface:aximm:1.0 S_AXI_UART WSTRB" *)
input wire [3 : 0] S_AXI_UART_wstrb;
(* X_INTERFACE_PARAMETER = "XIL_INTERFACENAME S_AXI_UART, DATA_WIDTH 32, PROTOCOL AXI4LITE, ID_WIDTH 0, ADDR_WIDTH 13, AWUSER_WIDTH 0, ARUSER_WIDTH 0, WUSER_WIDTH 0, RUSER_WIDTH 0, BUSER_WIDTH 0, READ_WRITE_MODE READ_WRITE, HAS_BURST 0, HAS_LOCK 0, HAS_PROT 0, HAS_CACHE 0, HAS_QOS 0, HAS_REGION 0, HAS_WSTRB 1, HAS_BRESP 1, HAS_RRESP 1, SUPPORTS_NARROW_BURST 0, NUM_READ_OUTSTANDING 1, NUM_WRITE_OUTSTANDING 1, MAX_BURST_LENGTH 1, NUM_READ_THREADS 1, NUM_WRITE_THREADS 1, RUSER_BITS_PER_BYTE 0, WUSER_BITS_PER_BYTE 0, FREQ_HZ 1\
00000000, PHASE 0.000, INSERT_VIP 0" *)
(* X_INTERFACE_INFO = "xilinx.com:interface:aximm:1.0 S_AXI_UART WVALID" *)
input wire S_AXI_UART_wvalid;
(* X_INTERFACE_PARAMETER = "XIL_INTERFACENAME INTR.BLE_UART_INTERRUPT, PortWidth 1, SENSITIVITY LEVEL_HIGH" *)
(* X_INTERFACE_INFO = "xilinx.com:signal:interrupt:1.0 INTR.BLE_UART_INTERRUPT INTERRUPT" *)
output wire BLE_uart_interrupt;
(* X_INTERFACE_PARAMETER = "XIL_INTERFACENAME CLK.S_AXI_ACLK, ASSOCIATED_BUSIF S_AXI_GPIO:S_AXI_UART, ASSOCIATED_RESET s_axi_aresetn, FREQ_HZ 100000000, PHASE 0.000, INSERT_VIP 0" *)
(* X_INTERFACE_INFO = "xilinx.com:signal:clock:1.0 CLK.S_AXI_ACLK CLK" *)
input wire s_axi_aclk;
(* X_INTERFACE_PARAMETER = "XIL_INTERFACENAME RST.S_AXI_ARESETN, POLARITY ACTIVE_LOW, INSERT_VIP 0" *)
(* X_INTERFACE_INFO = "xilinx.com:signal:reset:1.0 RST.S_AXI_ARESETN RST" *)
input wire s_axi_aresetn;

  PmodBLE inst (
    .Pmod_out_pin10_i(Pmod_out_pin10_i),
    .Pmod_out_pin10_o(Pmod_out_pin10_o),
    .Pmod_out_pin10_t(Pmod_out_pin10_t),
    .Pmod_out_pin1_i(Pmod_out_pin1_i),
    .Pmod_out_pin1_o(Pmod_out_pin1_o),
    .Pmod_out_pin1_t(Pmod_out_pin1_t),
    .Pmod_out_pin2_i(Pmod_out_pin2_i),
    .Pmod_out_pin2_o(Pmod_out_pin2_o),
    .Pmod_out_pin2_t(Pmod_out_pin2_t),
    .Pmod_out_pin3_i(Pmod_out_pin3_i),
    .Pmod_out_pin3_o(Pmod_out_pin3_o),
    .Pmod_out_pin3_t(Pmod_out_pin3_t),
    .Pmod_out_pin4_i(Pmod_out_pin4_i),
    .Pmod_out_pin4_o(Pmod_out_pin4_o),
    .Pmod_out_pin4_t(Pmod_out_pin4_t),
    .Pmod_out_pin7_i(Pmod_out_pin7_i),
    .Pmod_out_pin7_o(Pmod_out_pin7_o),
    .Pmod_out_pin7_t(Pmod_out_pin7_t),
    .Pmod_out_pin8_i(Pmod_out_pin8_i),
    .Pmod_out_pin8_o(Pmod_out_pin8_o),
    .Pmod_out_pin8_t(Pmod_out_pin8_t),
    .Pmod_out_pin9_i(Pmod_out_pin9_i),
    .Pmod_out_pin9_o(Pmod_out_pin9_o),
    .Pmod_out_pin9_t(Pmod_out_pin9_t),
    .S_AXI_GPIO_araddr(S_AXI_GPIO_araddr),
    .S_AXI_GPIO_arready(S_AXI_GPIO_arready),
    .S_AXI_GPIO_arvalid(S_AXI_GPIO_arvalid),
    .S_AXI_GPIO_awaddr(S_AXI_GPIO_awaddr),
    .S_AXI_GPIO_awready(S_AXI_GPIO_awready),
    .S_AXI_GPIO_awvalid(S_AXI_GPIO_awvalid),
    .S_AXI_GPIO_bready(S_AXI_GPIO_bready),
    .S_AXI_GPIO_bresp(S_AXI_GPIO_bresp),
    .S_AXI_GPIO_bvalid(S_AXI_GPIO_bvalid),
    .S_AXI_GPIO_rdata(S_AXI_GPIO_rdata),
    .S_AXI_GPIO_rready(S_AXI_GPIO_rready),
    .S_AXI_GPIO_rresp(S_AXI_GPIO_rresp),
    .S_AXI_GPIO_rvalid(S_AXI_GPIO_rvalid),
    .S_AXI_GPIO_wdata(S_AXI_GPIO_wdata),
    .S_AXI_GPIO_wready(S_AXI_GPIO_wready),
    .S_AXI_GPIO_wstrb(S_AXI_GPIO_wstrb),
    .S_AXI_GPIO_wvalid(S_AXI_GPIO_wvalid),
    .S_AXI_UART_araddr(S_AXI_UART_araddr),
    .S_AXI_UART_arready(S_AXI_UART_arready),
    .S_AXI_UART_arvalid(S_AXI_UART_arvalid),
    .S_AXI_UART_awaddr(S_AXI_UART_awaddr),
    .S_AXI_UART_awready(S_AXI_UART_awready),
    .S_AXI_UART_awvalid(S_AXI_UART_awvalid),
    .S_AXI_UART_bready(S_AXI_UART_bready),
    .S_AXI_UART_bresp(S_AXI_UART_bresp),
    .S_AXI_UART_bvalid(S_AXI_UART_bvalid),
    .S_AXI_UART_rdata(S_AXI_UART_rdata),
    .S_AXI_UART_rready(S_AXI_UART_rready),
    .S_AXI_UART_rresp(S_AXI_UART_rresp),
    .S_AXI_UART_rvalid(S_AXI_UART_rvalid),
    .S_AXI_UART_wdata(S_AXI_UART_wdata),
    .S_AXI_UART_wready(S_AXI_UART_wready),
    .S_AXI_UART_wstrb(S_AXI_UART_wstrb),
    .S_AXI_UART_wvalid(S_AXI_UART_wvalid),
    .BLE_uart_interrupt(BLE_uart_interrupt),
    .s_axi_aclk(s_axi_aclk),
    .s_axi_aresetn(s_axi_aresetn)
  );
endmodule
