faberc/ece-540_wi21_fnl-project/src/nexys_a7/jump_rope_sw/src/game_arrays.h

/*
 * File: \game_arrays.h
 * Project: c:\Users\Chuck\ECE540\fnlproj-team-tbc\sandbox\nexys_a7\level2\src
 * Created Date: Thursday, March 4th 2021, 8:49:14 pm
 * Author: Chuck Faber
 * -----
 * Last Modified: Mon Mar 08 2021
 * Modified By: Chuck Faber
 * -----
 * Copyright (c) 2021 Portland State University
 * 
 * "Any time I had a problem, and I threw a Molotov cocktail…Boom, right away, I had a different problem."
 * - Jason Mendoza
 * -----
 * HISTORY:
 * Date      	By	Comments
 * ----------	---	----------------------------------------------------------
 */

// char test_array1[46] = {0b00, 0b00, 0b00, 0b01, 0b00, 0b00, 0b00, 0b01, 0b00, 0b00, 0b00, 0b00, 0b00, 0b01, 0b00, 0b00, 0b00, 0b01,
//                      0b00, 0b00, 0b00, 0b00, 0b00, 0b01, 0b00, 0b00, 0b00, 0b00, 0b00, 0b01, 0b00, 0b01, 0b00, 0b00, 0b00, 0b01,
//                      0b00, 0b01, 0b00, 0b00, 0b00, 0b00, 0b00, 0b01, 0b00, 0b00};

char test[10] = {
    0b10, 0b10, 0b10, 0b10, 0b10, 0b10, 0b10, 0b10, 0b10, 0b10,
};

char up_arr[100] = {
    0b10, 0b10, 0b10, 0b10, 0b10, 0b10, 0b10, 0b10, 0b10, 0b10,
    0b10, 0b10, 0b10, 0b10, 0b10, 0b10, 0b10, 0b10, 0b10, 0b10,
    0b10, 0b10, 0b10, 0b10, 0b10, 0b10, 0b10, 0b10, 0b10, 0b10,
    0b10, 0b10, 0b10, 0b10, 0b10, 0b10, 0b10, 0b10, 0b10, 0b10,
    0b10, 0b10, 0b10, 0b10, 0b10, 0b10, 0b10, 0b10, 0b10, 0b10,
    0b10, 0b10, 0b10, 0b10, 0b10, 0b10, 0b10, 0b10, 0b10, 0b10,
    0b10, 0b10, 0b10, 0b10, 0b10, 0b10, 0b10, 0b10, 0b10, 0b10,
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
    0b01,0b00,0b01,0b00,    0b01,0b00,0b01,0b00,
    0b01,0b00,0b01,0b00,    0b01,0b00,0b01,0b00,
    0b01,0b00,0b01,0b00,    0b01,0b00,0b01,0b00,
    0b01,0b00,0b01,0b00,    0b01,0b00,0b01,0b00,

    /*Cool down*/
    0b00,0b00,0b00,0b00,    0b00,0b00,0b00,0b00,
    0b00,0b00,0b00,0b00

};
