faberc/ece-540_wi21_fnl-project/src/nexys_a7/rvfpga/src/SweRVolfSoC/Interconnect/WishboneInterconnect/wb_intercon.v

module wb_intercon
   (input         wb_clk_i,
    input         wb_rst_i,
    input  [31:0] wb_io_adr_i,
    input  [31:0] wb_io_dat_i,
    input   [3:0] wb_io_sel_i,
    input         wb_io_we_i,
    input         wb_io_cyc_i,
    input         wb_io_stb_i,
    input   [2:0] wb_io_cti_i,
    input   [1:0] wb_io_bte_i,
    output [31:0] wb_io_dat_o,
    output        wb_io_ack_o,
    output        wb_io_err_o,
    output        wb_io_rty_o,
    output [31:0] wb_rom_adr_o,
    output [31:0] wb_rom_dat_o,
    output  [3:0] wb_rom_sel_o,
    output        wb_rom_we_o,
    output        wb_rom_cyc_o,
    output        wb_rom_stb_o,
    output  [2:0] wb_rom_cti_o,
    output  [1:0] wb_rom_bte_o,
    input  [31:0] wb_rom_dat_i,
    input         wb_rom_ack_i,
    input         wb_rom_err_i,
    input         wb_rom_rty_i,

// SPI - Flash
    output [31:0] wb_spi_flash_adr_o,
    output [31:0] wb_spi_flash_dat_o,
    output  [3:0] wb_spi_flash_sel_o,
    output        wb_spi_flash_we_o,
    output        wb_spi_flash_cyc_o,
    output        wb_spi_flash_stb_o,
    output  [2:0] wb_spi_flash_cti_o,
    output  [1:0] wb_spi_flash_bte_o,
    input  [31:0] wb_spi_flash_dat_i,
    input         wb_spi_flash_ack_i,
    input         wb_spi_flash_err_i,
    input         wb_spi_flash_rty_i,

// SysCon
    output [31:0] wb_sys_adr_o,
    output [31:0] wb_sys_dat_o,
    output  [3:0] wb_sys_sel_o,
    output        wb_sys_we_o,
    output        wb_sys_cyc_o,
    output        wb_sys_stb_o,
    output  [2:0] wb_sys_cti_o,
    output  [1:0] wb_sys_bte_o,
    input  [31:0] wb_sys_dat_i,
    input         wb_sys_ack_i,
    input         wb_sys_err_i,
    input         wb_sys_rty_i,

// UART
    output [31:0] wb_uart_adr_o,
    output [31:0] wb_uart_dat_o,
    output  [3:0] wb_uart_sel_o,
    output        wb_uart_we_o,
    output        wb_uart_cyc_o,
    output        wb_uart_stb_o,
    output  [2:0] wb_uart_cti_o,
    output  [1:0] wb_uart_bte_o,
    input  [31:0] wb_uart_dat_i,
    input         wb_uart_ack_i,
    input         wb_uart_err_i,
    input         wb_uart_rty_i,

// GPIO
    output [31:0] wb_gpio_adr_o,
    output [31:0] wb_gpio_dat_o,
    output  [3:0] wb_gpio_sel_o,
    output        wb_gpio_we_o,
    output        wb_gpio_cyc_o,
    output        wb_gpio_stb_o,
    output  [2:0] wb_gpio_cti_o,
    output  [1:0] wb_gpio_bte_o,
    input  [31:0] wb_gpio_dat_i,
    input         wb_gpio_ack_i,
    input         wb_gpio_err_i,
    input         wb_gpio_rty_i,

// GPIO Module A
    output [31:0] wb_gpio_a_adr_o,
    output [31:0] wb_gpio_a_dat_o,
    output  [3:0] wb_gpio_a_sel_o,
    output        wb_gpio_a_we_o,
    output        wb_gpio_a_cyc_o,
    output        wb_gpio_a_stb_o,
    output  [2:0] wb_gpio_a_cti_o,
    output  [1:0] wb_gpio_a_bte_o,
    input  [31:0] wb_gpio_a_dat_i,
    input         wb_gpio_a_ack_i,
    input         wb_gpio_a_err_i,
    input         wb_gpio_a_rty_i,

// PWM audio
    output  [31:0]  wb_pwm_adr_o,
    output  [31:0]  wb_pwm_dat_o,
    output  [3:0]   wb_pwm_sel_o,
    output          wb_pwm_we_o, 
    output          wb_pwm_cyc_o,
    output          wb_pwm_stb_o,
    output  [2:0]   wb_pwm_cti_o,
    output  [1:0]   wb_pwm_bte_o,
    input   [31:0]  wb_pwm_dat_i,
    input           wb_pwm_ack_i,
    input           wb_pwm_err_i,
    input           wb_pwm_rty_i,

// Peripheral 2 :: Rope Game
    output  [31:0]  wb_per2_adr_o,
    output  [31:0]  wb_per2_dat_o,
    output  [3:0]   wb_per2_sel_o,
    output          wb_per2_we_o, 
    output          wb_per2_cyc_o,
    output          wb_per2_stb_o,
    output  [2:0]   wb_per2_cti_o,
    output  [1:0]   wb_per2_bte_o,
    input   [31:0]  wb_per2_dat_i,
    input           wb_per2_ack_i,
    input           wb_per2_err_i,
    input           wb_per2_rty_i,

// PTC
    output [31:0] wb_ptc_adr_o,
    output [31:0] wb_ptc_dat_o,
    output  [3:0] wb_ptc_sel_o,
    output        wb_ptc_we_o,
    output        wb_ptc_cyc_o,
    output        wb_ptc_stb_o,
    output  [2:0] wb_ptc_cti_o,
    output  [1:0] wb_ptc_bte_o,
    input  [31:0] wb_ptc_dat_i,
    input         wb_ptc_ack_i,
    input         wb_ptc_err_i,
    input         wb_ptc_rty_i,

// SPI
    output [31:0] wb_spi_accel_adr_o,
    output [31:0] wb_spi_accel_dat_o,
    output  [3:0] wb_spi_accel_sel_o,
    output        wb_spi_accel_we_o,
    output        wb_spi_accel_cyc_o,
    output        wb_spi_accel_stb_o,
    output  [2:0] wb_spi_accel_cti_o,
    output  [1:0] wb_spi_accel_bte_o,
    input  [31:0] wb_spi_accel_dat_i,
    input         wb_spi_accel_ack_i,
    input         wb_spi_accel_err_i,
    input         wb_spi_accel_rty_i
    );


wb_mux
  #(.num_slaves (10),
    .MATCH_ADDR ({32'h00000000, 32'h00001000, 32'h00001040, 32'h00001100, 32'h00001200, 32'h00001400, 32'h00001500, 32'h00001600, 32'h00001700, 32'h00002000}),
    .MATCH_MASK ({32'hfffff000, 32'hffffffc0, 32'hffffffc0, 32'hffffffc0, 32'hffffffc0, 32'hffffffc0, 32'hffffffc0, 32'hffffffc0, 32'hffffffc0, 32'hfffff000}))
 wb_mux_io
   (.wb_clk_i  (wb_clk_i),
    .wb_rst_i  (wb_rst_i),
    .wbm_adr_i (wb_io_adr_i),
    .wbm_dat_i (wb_io_dat_i),
    .wbm_sel_i (wb_io_sel_i),
    .wbm_we_i  (wb_io_we_i),
    .wbm_cyc_i (wb_io_cyc_i),
    .wbm_stb_i (wb_io_stb_i),
    .wbm_cti_i (wb_io_cti_i),
    .wbm_bte_i (wb_io_bte_i),
    .wbm_dat_o (wb_io_dat_o),
    .wbm_ack_o (wb_io_ack_o),
    .wbm_err_o (wb_io_err_o),
    .wbm_rty_o (wb_io_rty_o),
    .wbs_adr_o ({wb_rom_adr_o, wb_sys_adr_o, wb_spi_flash_adr_o, wb_spi_accel_adr_o, wb_ptc_adr_o, wb_gpio_adr_o, wb_gpio_a_adr_o, wb_pwm_adr_o, wb_per2_adr_o, wb_uart_adr_o}),
    .wbs_dat_o ({wb_rom_dat_o, wb_sys_dat_o, wb_spi_flash_dat_o, wb_spi_accel_dat_o, wb_ptc_dat_o, wb_gpio_dat_o, wb_gpio_a_dat_o, wb_pwm_dat_o, wb_per2_dat_o, wb_uart_dat_o}),
    .wbs_sel_o ({wb_rom_sel_o, wb_sys_sel_o, wb_spi_flash_sel_o, wb_spi_accel_sel_o, wb_ptc_sel_o, wb_gpio_sel_o, wb_gpio_a_sel_o, wb_pwm_sel_o, wb_per2_sel_o, wb_uart_sel_o}),
    .wbs_we_o  ({wb_rom_we_o,  wb_sys_we_o,  wb_spi_flash_we_o,  wb_spi_accel_we_o,  wb_ptc_we_o,  wb_gpio_we_o,  wb_gpio_a_we_o,  wb_pwm_we_o,  wb_per2_we_o,  wb_uart_we_o }),
    .wbs_cyc_o ({wb_rom_cyc_o, wb_sys_cyc_o, wb_spi_flash_cyc_o, wb_spi_accel_cyc_o, wb_ptc_cyc_o, wb_gpio_cyc_o, wb_gpio_a_cyc_o, wb_pwm_cyc_o, wb_per2_cyc_o, wb_uart_cyc_o}),
    .wbs_stb_o ({wb_rom_stb_o, wb_sys_stb_o, wb_spi_flash_stb_o, wb_spi_accel_stb_o, wb_ptc_stb_o, wb_gpio_stb_o, wb_gpio_a_stb_o, wb_pwm_stb_o, wb_per2_stb_o, wb_uart_stb_o}),
    .wbs_cti_o ({wb_rom_cti_o, wb_sys_cti_o, wb_spi_flash_cti_o, wb_spi_accel_cti_o, wb_ptc_cti_o, wb_gpio_cti_o, wb_gpio_a_cti_o, wb_pwm_cti_o, wb_per2_cti_o, wb_uart_cti_o}),
    .wbs_bte_o ({wb_rom_bte_o, wb_sys_bte_o, wb_spi_flash_bte_o, wb_spi_accel_bte_o, wb_ptc_bte_o, wb_gpio_bte_o, wb_gpio_a_bte_o, wb_pwm_bte_o, wb_per2_bte_o, wb_uart_bte_o}),
    .wbs_dat_i ({wb_rom_dat_i, wb_sys_dat_i, wb_spi_flash_dat_i, wb_spi_accel_dat_i, wb_ptc_dat_i, wb_gpio_dat_i, wb_gpio_a_dat_i, wb_pwm_dat_i, wb_per2_dat_i, wb_uart_dat_i}),
    .wbs_ack_i ({wb_rom_ack_i, wb_sys_ack_i, wb_spi_flash_ack_i, wb_spi_accel_ack_i, wb_ptc_ack_i, wb_gpio_ack_i, wb_gpio_a_ack_i, wb_pwm_ack_i, wb_per2_ack_i, wb_uart_ack_i}),
    .wbs_err_i ({wb_rom_err_i, wb_sys_err_i, wb_spi_flash_err_i, wb_spi_accel_err_i, wb_ptc_err_i, wb_gpio_err_i, wb_gpio_a_err_i, wb_pwm_err_i, wb_per2_err_i, wb_uart_err_i}),
    .wbs_rty_i ({wb_rom_rty_i, wb_sys_rty_i, wb_spi_flash_rty_i, wb_spi_accel_rty_i, wb_ptc_rty_i, wb_gpio_rty_i, wb_gpio_a_rty_i, wb_pwm_rty_i, wb_per2_rty_i, wb_uart_rty_i}));

endmodule
