faberc/ece-540_wi21_fnl-project/rvfpga/vivado/project_final/project_final.cache/ip/2019.2/450329cffcbe6ce6/u_ila_0_stub.vhdl

-- Copyright 1986-2019 Xilinx, Inc. All Rights Reserved.
-- --------------------------------------------------------------------------------
-- Tool Version: Vivado v.2019.2 (win64) Build 2708876 Wed Nov  6 21:40:23 MST 2019
-- Date        : Wed Mar  3 23:48:30 2021
-- Host        : DESKTOP-HHTTKMG running 64-bit major release  (build 9200)
-- Command     : write_vhdl -force -mode synth_stub -rename_top decalper_eb_ot_sdeen_pot_pi_dehcac_xnilix -prefix
--               decalper_eb_ot_sdeen_pot_pi_dehcac_xnilix_ u_ila_0_stub.vhdl
-- Design      : u_ila_0
-- Purpose     : Stub declaration of top-level module interface
-- Device      : xc7a100tcsg324-1
-- --------------------------------------------------------------------------------
library IEEE;
use IEEE.STD_LOGIC_1164.ALL;

entity decalper_eb_ot_sdeen_pot_pi_dehcac_xnilix is
  Port ( 
    clk : in STD_LOGIC;
    probe0 : in STD_LOGIC_VECTOR ( 63 downto 0 );
    probe1 : in STD_LOGIC_VECTOR ( 31 downto 0 );
    probe2 : in STD_LOGIC_VECTOR ( 7 downto 0 );
    probe3 : in STD_LOGIC_VECTOR ( 3 downto 0 );
    probe4 : in STD_LOGIC_VECTOR ( 0 to 0 );
    probe5 : in STD_LOGIC_VECTOR ( 0 to 0 );
    probe6 : in STD_LOGIC_VECTOR ( 0 to 0 );
    probe7 : in STD_LOGIC_VECTOR ( 0 to 0 );
    probe8 : in STD_LOGIC_VECTOR ( 0 to 0 )
  );

end decalper_eb_ot_sdeen_pot_pi_dehcac_xnilix;

architecture stub of decalper_eb_ot_sdeen_pot_pi_dehcac_xnilix is
attribute syn_black_box : boolean;
attribute black_box_pad_pin : string;
attribute syn_black_box of stub : architecture is true;
attribute black_box_pad_pin of stub : architecture is "clk,probe0[63:0],probe1[31:0],probe2[7:0],probe3[3:0],probe4[0:0],probe5[0:0],probe6[0:0],probe7[0:0],probe8[0:0]";
attribute X_CORE_INFO : string;
attribute X_CORE_INFO of stub : architecture is "ila,Vivado 2019.2";
begin
end;
