faberc/ece-540_wi21_fnl-project/rvfpga/vivado/project_final/project_final.srcs/sources_1/bd/design_1/synth/design_1.v

//Copyright 1986-2019 Xilinx, Inc. All Rights Reserved.
//--------------------------------------------------------------------------------
//Tool Version: Vivado v.2019.2 (win64) Build 2708876 Wed Nov  6 21:40:23 MST 2019
//Date        : Mon Feb 22 13:26:00 2021
//Host        : DESKTOP-HHTTKMG running 64-bit major release  (build 9200)
//Command     : generate_target design_1.bd
//Design      : design_1
//Purpose     : IP block netlist
//--------------------------------------------------------------------------------
`timescale 1 ps / 1 ps

(* CORE_GENERATION_INFO = "design_1,IP_Integrator,{x_ipVendor=xilinx.com,x_ipLibrary=BlockDiagram,x_ipName=design_1,x_ipVersion=1.00.a,x_ipLanguage=VERILOG,numBlks=0,numReposBlks=0,numNonXlnxBlks=0,numHierBlks=0,maxHierDepth=0,numSysgenBlks=0,numHlsBlks=0,numHdlrefBlks=0,numPkgbdBlks=0,bdsource=USER,synth_mode=OOC_per_IP}" *) (* HW_HANDOFF = "design_1.hwdef" *) 
module design_1
   ();


endmodule
