faberc/ece-540_wi21_fnl-project/rvfpga/src/SweRVolfSoC/OtherSources/uart_rx/uart_tx.sv

//////////////////////////////////////////////////////////////
// uart_tx.sv - UART Transmitter (starter code)
//
// Author:	Chuck Faber (kpfaber@gmail.com)
// Date:	6/1/2020
//
// Description:
// ------------
// Serializes a data packet, adds the start and stop bits and transmits the
// data packed on bit at a time on the tx signal.
//
// Original code by Pong Chu from his book FPGA Prototyping w/ SystemVerilog, Wiley 2018
////////////////////////////////////////////////////////////////
module uart_tx
#(
	parameter	DBIT = 8,     // # data bits
				SB_TICK = 16  // # 16 ticks for 1 stop bit
 )
(
	input  logic clk, reset,		// system clock and reset (reset asserted high)
	input  logic tx_start, s_tick,	// tx_start tells the transmitter to transmit
									// a serial data packet
	input  logic [7:0] din,			// parallel data in
    output logic tx_done_tick,		// packet transmission done pulse
	output logic tx,					// serial transmit line

	// debug signals
	output logic newbit_tick		// one cycle pulse when a data bit is sampled
);

// fsm state type
typedef enum logic[1:0] {idle, start, data, stop} state_type;

// signal declaration
state_type state_reg, state_next;	// state registers
logic [3:0] s_reg, s_next;			// counts s_ticks for oversampling
logic [2:0] n_reg, n_next;			// counts data bits
logic [7:0] b_reg, b_next;			// serializes the parallel data
logic tx_reg, tx_next;				// generates tx serial data out


// FSMD state & data registers
always_ff @(posedge clk, posedge reset) begin: seq_block
	if (reset) begin
		state_reg	<=	idle;
		s_reg		<=	0;
		n_reg		<=	0;
		b_reg		<=	0;
		tx_reg		<=	1;
	 end
	else begin
		state_reg	<=	state_next;
		s_reg		<=	s_next;
		n_reg		<=	n_next;
		b_reg		<=	b_next;
		tx_reg		<=	tx_next;
	 end
end: seq_block


// FSMD next-state logic & functional units
always_comb begin: next_state_logic
	// set initial values so you don't have to include every signal in every case item
	state_next = state_reg;
	s_next = s_reg;
	n_next = n_reg;
	b_next = b_reg;
	tx_next = tx_reg;
	tx_done_tick = 1'b0;
	newbit_tick = 1'b0;

	// generate next state
	case (state_reg)
		idle: begin: wait_for_start_signal
			tx_next = 1'b1;							// <-- Add to flow chart
			if (tx_start) begin
				// start packet transmission
				state_next = start;
				s_next = 0;
				b_next = din;						// <-- Add to flow chart
            end
		end: wait_for_start_signal

		start: begin: transmit_start_bit
			tx_next = 1'b0;		// set tx low indicating start bit
            if (s_tick)
				if (s_reg == 15) begin
					state_next = data;
					s_next = 0;
					n_next = 0;
					newbit_tick = 1'b1;
                end
                else
					s_next = s_reg + 1;
         end: transmit_start_bit

    data: begin: transmit_data_bits
			tx_next = b_reg[0];		// set tx to the current data bit
			if (s_tick)
				if(s_reg == 15) begin
					s_next = 0;
					b_next = b_reg >> 1;
					if (n_reg == (DBIT-1))
						state_next = stop;
					else
						n_next = n_reg + 1;
						newbit_tick = 1'b1;
				end
				else
					s_next = s_reg + 1;

		end: transmit_data_bits

		stop: begin: transmit_stop_bit
			tx_next = 1'b1;							// <-- Add to flow chart
			if (s_tick)
					if (s_reg == (SB_TICK-1))
						begin
						// middle of stop bit
							state_next = idle;
							tx_done_tick =1'b1;
							newbit_tick = 1'b1;
						end
				else
					s_next = s_reg + 1;
		end: transmit_stop_bit
	endcase
end: next_state_logic

// output tx data
assign tx = tx_reg;

endmodule: uart_tx
