faberc/ece-540_wi21_fnl-project/sandbox/esp32/ESP32_V1/src/main.cpp

/*
    Video: https://www.youtube.com/watch?v=oCMOYS71NIU
    Based on Neil Kolban example for IDF: https://github.com/nkolban/esp32-snippets/blob/master/cpp_utils/tests/BLE%20Tests/SampleNotify.cpp
    Ported to Arduino ESP32 by Evandro Copercini

   Create a BLE server that, once we receive a connection, will send periodic notifications.
   The service advertises itself as: 6E400001-B5A3-F393-E0A9-E50E24DCCA9E
   Has a characteristic of: 6E400002-B5A3-F393-E0A9-E50E24DCCA9E - used for receiving data with "WRITE" 
   Has a characteristic of: 6E400003-B5A3-F393-E0A9-E50E24DCCA9E - used to send data with  "NOTIFY"

   The design of creating the BLE server is:
   1. Create a BLE Server
   2. Create a BLE Service
   3. Create a BLE Characteristic on the Service
   4. Create a BLE Descriptor on the characteristic
   5. Start the service.
   6. Start advertising.

   In this example rxValue is the data received (only accessible inside that function).
   And txValue is the data to be sent, in this example just a byte incremented every second. 
*/
#include <Arduino.h>
#include <BLEDevice.h>
#include <BLEServer.h>
#include <BLEUtils.h>
#include <BLE2902.h>
#include <Adafruit_MPU6050.h>
#include <Adafruit_Sensor.h>
#include <Wire.h>

Adafruit_MPU6050 mpu;
BLEServer *pServer = NULL;
BLECharacteristic *pTxCharacteristic;
bool deviceConnected = false;
bool oldDeviceConnected = false;
// uint8_t txValue = 0;
// int8_t txValue = 0;
float txValue = 0.00;

// See the following for generating UUIDs:
// https://www.uuidgenerator.net/

#define SERVICE_UUID "6E400001-B5A3-F393-E0A9-E50E24DCCA9E" // UART service UUID
#define CHARACTERISTIC_UUID_RX "6E400002-B5A3-F393-E0A9-E50E24DCCA9E"
#define CHARACTERISTIC_UUID_TX "6E400003-B5A3-F393-E0A9-E50E24DCCA9E"

// RN4871 Transparent UART Service
// #define SERVICE_UUID "49535343-FE7D-4AE5-8FA9-9FAFD205E455" // UART service UUID
// #define CHARACTERISTIC_UUID_RX "49535343-1E4D-4BD9-BA61-23C647249616"
// #define CHARACTERISTIC_UUID_TX "49535343-8841-43F4-A8D4-ECBE34729BB3"

class MyServerCallbacks : public BLEServerCallbacks
{
    void onConnect(BLEServer *pServer)
    {
        Serial.println("Connected");
        deviceConnected = true;
    };

    void onDisconnect(BLEServer *pServer)
    {
        Serial.println("Disconnected");
        deviceConnected = false;
    }
};

class MyCallbacks : public BLECharacteristicCallbacks
{
    void onWrite(BLECharacteristic *pCharacteristic)
    {
        std::string rxValue = pCharacteristic->getValue();

        if (rxValue.length() > 0)
        {
            Serial.println("*********");
            Serial.print("Received Value: ");
            for (int i = 0; i < rxValue.length(); i++)
                Serial.print(rxValue[i]);

            Serial.println();
            Serial.println("*********");
        }
    }
};

void setup()
{
    Serial.begin(115200);
    ///////////////
    // BLE SETUP //
    ///////////////

    // Create the BLE Device
    BLEDevice::init("CHUCK");

    // Create the BLE Server
    pServer = BLEDevice::createServer();
    pServer->setCallbacks(new MyServerCallbacks());

    // Create the BLE Service
    BLEService *pService = pServer->createService(SERVICE_UUID);

    // Create a BLE Characteristic
    pTxCharacteristic = pService->createCharacteristic(
        CHARACTERISTIC_UUID_TX,
        BLECharacteristic::PROPERTY_NOTIFY);

    pTxCharacteristic->addDescriptor(new BLE2902());

    BLECharacteristic *pRxCharacteristic = pService->createCharacteristic(
        CHARACTERISTIC_UUID_RX,
        BLECharacteristic::PROPERTY_WRITE);

    pRxCharacteristic->setCallbacks(new MyCallbacks());

    // Start the service
    pService->start();
    pServer->getAdvertising()->addServiceUUID(pService->getUUID());

    //   pTxCharacteristic->setValue("HELLO");

    // Start advertising
    pServer->getAdvertising()->start();
    Serial.println("Waiting a client connection to notify...");

    ///////////////////
    // MPU6050 SETUP //
    ///////////////////

    // Try to initialize!
    if (!mpu.begin())
    {
        Serial.println("Failed to find MPU6050 chip");
        while (1)
        {
            delay(10);
        }
    }
    Serial.println("MPU6050 Found!");

    mpu.setAccelerometerRange(MPU6050_RANGE_8_G);
    Serial.print("Accelerometer range set to: ");
    switch (mpu.getAccelerometerRange())
    {
    case MPU6050_RANGE_2_G:
        Serial.println("+-2G");
        break;
    case MPU6050_RANGE_4_G:
        Serial.println("+-4G");
        break;
    case MPU6050_RANGE_8_G:
        Serial.println("+-8G");
        break;
    case MPU6050_RANGE_16_G:
        Serial.println("+-16G");
        break;
    }
    mpu.setGyroRange(MPU6050_RANGE_500_DEG);
    Serial.print("Gyro range set to: ");
    switch (mpu.getGyroRange())
    {
    case MPU6050_RANGE_250_DEG:
        Serial.println("+- 250 deg/s");
        break;
    case MPU6050_RANGE_500_DEG:
        Serial.println("+- 500 deg/s");
        break;
    case MPU6050_RANGE_1000_DEG:
        Serial.println("+- 1000 deg/s");
        break;
    case MPU6050_RANGE_2000_DEG:
        Serial.println("+- 2000 deg/s");
        break;
    }

    mpu.setFilterBandwidth(MPU6050_BAND_5_HZ);
    Serial.print("Filter bandwidth set to: ");
    switch (mpu.getFilterBandwidth())
    {
    case MPU6050_BAND_260_HZ:
        Serial.println("260 Hz");
        break;
    case MPU6050_BAND_184_HZ:
        Serial.println("184 Hz");
        break;
    case MPU6050_BAND_94_HZ:
        Serial.println("94 Hz");
        break;
    case MPU6050_BAND_44_HZ:
        Serial.println("44 Hz");
        break;
    case MPU6050_BAND_21_HZ:
        Serial.println("21 Hz");
        break;
    case MPU6050_BAND_10_HZ:
        Serial.println("10 Hz");
        break;
    case MPU6050_BAND_5_HZ:
        Serial.println("5 Hz");
        break;
    }

    Serial.println("");
    delay(100);
}

void loop()
{

    if (deviceConnected)
    {
        pTxCharacteristic->setValue((uint8_t *)&txValue, 4);
        pTxCharacteristic->notify();
        // if (txValue < 5)
        // {
        //     txValue += 0.5;
        // }
        // else
        // {
        //     txValue = 0;
        // }

        // Get sensor data
        sensors_event_t a, g, temp;
        mpu.getEvent(&a, &g, &temp);
        txValue = a.acceleration.x + a.acceleration.y + a.acceleration.z;
        Serial.println(txValue);

        // Delay
        delay(5000); // bluetooth stack will go into congestion, if too many packets are sent
    }

    // disconnecting
    if (!deviceConnected && oldDeviceConnected)
    {
        delay(500);                  // give the bluetooth stack the chance to get things ready
        pServer->startAdvertising(); // restart advertising
        Serial.println("start advertising");
        oldDeviceConnected = deviceConnected;
    }
    // connecting
    if (deviceConnected && !oldDeviceConnected)
    {
        // do stuff here on connecting
        oldDeviceConnected = deviceConnected;
    }
}
