faberc/ece-540_wi21_fnl-project/rvfpga/vivado/project_final/project_final.cache/ip/2019.2/7c3e01333938ccc6/PmodBLE_0_sim_netlist.v

// Copyright 1986-2019 Xilinx, Inc. All Rights Reserved.
// --------------------------------------------------------------------------------
// Tool Version: Vivado v.2019.2 (win64) Build 2708876 Wed Nov  6 21:40:23 MST 2019
// Date        : Mon Feb 22 16:53:51 2021
// Host        : DESKTOP-HHTTKMG running 64-bit major release  (build 9200)
// Command     : write_verilog -force -mode funcsim -rename_top decalper_eb_ot_sdeen_pot_pi_dehcac_xnilix -prefix
//               decalper_eb_ot_sdeen_pot_pi_dehcac_xnilix_ PmodBLE_0_sim_netlist.v
// Design      : PmodBLE_0
// Purpose     : This verilog netlist is a functional simulation representation of the design and should not be modified
//               or synthesized. This netlist cannot be used for SDF annotated simulation.
// Device      : xc7a100tcsg324-1
// --------------------------------------------------------------------------------
`timescale 1 ps / 1 ps

module decalper_eb_ot_sdeen_pot_pi_dehcac_xnilix_GPIO_Core
   (reg1,
    reg3,
    GPIO_xferAck_i,
    gpio_xferAck_Reg,
    reg2,
    reg4,
    \GEN_BKEND_CE_REGISTERS[3].ce_out_i_reg[3] ,
    gpio2_io_o,
    \Dual.gpio2_OE_reg[1]_0 ,
    \Dual.gpio2_OE_reg[0]_0 ,
    gpio_io_o,
    gpio_io_t,
    ip2bus_wrack_i,
    ip2bus_rdack_i,
    \Dual.ALLOUT0_ND_G2.READ_REG2_GEN[0].reg4_reg[30]_0 ,
    s_axi_aclk,
    bus2ip_reset,
    \GEN_BKEND_CE_REGISTERS[3].ce_out_i_reg ,
    Bus_RNW_reg,
    \GEN_BKEND_CE_REGISTERS[2].ce_out_i_reg ,
    \GEN_BKEND_CE_REGISTERS[1].ce_out_i_reg ,
    \GEN_BKEND_CE_REGISTERS[0].ce_out_i_reg ,
    Q,
    gpio_reg_en,
    p_1_in2_in,
    p_0_in3_in,
    bus2ip_rnw,
    bus2ip_cs,
    gpio_io_i,
    gpio2_io_i,
    E,
    D,
    \Dual.gpio_OE_reg[0]_0 ,
    s_axi_wdata,
    \Dual.gpio2_Data_Out_reg[0]_0 ,
    \Dual.gpio2_OE_reg[0]_1 );
  output [3:0]reg1;
  output [1:0]reg3;
  output GPIO_xferAck_i;
  output gpio_xferAck_Reg;
  output [3:0]reg2;
  output [1:0]reg4;
  output \GEN_BKEND_CE_REGISTERS[3].ce_out_i_reg[3] ;
  output [1:0]gpio2_io_o;
  output \Dual.gpio2_OE_reg[1]_0 ;
  output \Dual.gpio2_OE_reg[0]_0 ;
  output [3:0]gpio_io_o;
  output [3:0]gpio_io_t;
  output ip2bus_wrack_i;
  output ip2bus_rdack_i;
  input \Dual.ALLOUT0_ND_G2.READ_REG2_GEN[0].reg4_reg[30]_0 ;
  input s_axi_aclk;
  input bus2ip_reset;
  input \GEN_BKEND_CE_REGISTERS[3].ce_out_i_reg ;
  input Bus_RNW_reg;
  input \GEN_BKEND_CE_REGISTERS[2].ce_out_i_reg ;
  input \GEN_BKEND_CE_REGISTERS[1].ce_out_i_reg ;
  input \GEN_BKEND_CE_REGISTERS[0].ce_out_i_reg ;
  input [1:0]Q;
  input gpio_reg_en;
  input p_1_in2_in;
  input p_0_in3_in;
  input bus2ip_rnw;
  input bus2ip_cs;
  input [3:0]gpio_io_i;
  input [1:0]gpio2_io_i;
  input [0:0]E;
  input [3:0]D;
  input [0:0]\Dual.gpio_OE_reg[0]_0 ;
  input [3:0]s_axi_wdata;
  input \Dual.gpio2_Data_Out_reg[0]_0 ;
  input \Dual.gpio2_OE_reg[0]_1 ;

  wire Bus_RNW_reg;
  wire [3:0]D;
  wire \Dual.ALLOUT0_ND_G0.READ_REG_GEN[0].reg1[28]_i_1_n_0 ;
  wire \Dual.ALLOUT0_ND_G0.READ_REG_GEN[0].reg2[28]_i_1_n_0 ;
  wire \Dual.ALLOUT0_ND_G0.READ_REG_GEN[1].reg1[29]_i_1_n_0 ;
  wire \Dual.ALLOUT0_ND_G0.READ_REG_GEN[1].reg2[29]_i_1_n_0 ;
  wire \Dual.ALLOUT0_ND_G0.READ_REG_GEN[2].reg1[30]_i_1_n_0 ;
  wire \Dual.ALLOUT0_ND_G0.READ_REG_GEN[2].reg2[30]_i_1_n_0 ;
  wire \Dual.ALLOUT0_ND_G0.READ_REG_GEN[3].reg1[31]_i_2_n_0 ;
  wire \Dual.ALLOUT0_ND_G0.READ_REG_GEN[3].reg2[31]_i_1_n_0 ;
  wire \Dual.ALLOUT0_ND_G2.READ_REG2_GEN[0].reg3[30]_i_1_n_0 ;
  wire \Dual.ALLOUT0_ND_G2.READ_REG2_GEN[0].reg4[30]_i_1_n_0 ;
  wire \Dual.ALLOUT0_ND_G2.READ_REG2_GEN[0].reg4_reg[30]_0 ;
  wire \Dual.ALLOUT0_ND_G2.READ_REG2_GEN[1].reg3[31]_i_1_n_0 ;
  wire \Dual.ALLOUT0_ND_G2.READ_REG2_GEN[1].reg4[31]_i_1_n_0 ;
  wire \Dual.gpio2_Data_Out[0]_i_1_n_0 ;
  wire \Dual.gpio2_Data_Out[1]_i_1_n_0 ;
  wire \Dual.gpio2_Data_Out_reg[0]_0 ;
  wire \Dual.gpio2_OE[0]_i_1_n_0 ;
  wire \Dual.gpio2_OE[1]_i_1_n_0 ;
  wire \Dual.gpio2_OE_reg[0]_0 ;
  wire \Dual.gpio2_OE_reg[0]_1 ;
  wire \Dual.gpio2_OE_reg[1]_0 ;
  wire [0:0]\Dual.gpio_OE_reg[0]_0 ;
  wire [0:0]E;
  wire \GEN_BKEND_CE_REGISTERS[0].ce_out_i_reg ;
  wire \GEN_BKEND_CE_REGISTERS[1].ce_out_i_reg ;
  wire \GEN_BKEND_CE_REGISTERS[2].ce_out_i_reg ;
  wire \GEN_BKEND_CE_REGISTERS[3].ce_out_i_reg ;
  wire \GEN_BKEND_CE_REGISTERS[3].ce_out_i_reg[3] ;
  wire GPIO_xferAck_i;
  wire [1:0]Q;
  wire bus2ip_cs;
  wire bus2ip_reset;
  wire bus2ip_rnw;
  wire [0:1]gpio2_Data_In;
  wire [1:0]gpio2_io_i;
  wire [0:1]gpio2_io_i_d2;
  wire [1:0]gpio2_io_o;
  wire [0:3]gpio_Data_In;
  wire [3:0]gpio_io_i;
  wire [0:3]gpio_io_i_d2;
  wire [3:0]gpio_io_o;
  wire [3:0]gpio_io_t;
  wire gpio_reg_en;
  wire gpio_xferAck_Reg;
  wire iGPIO_xferAck;
  wire ip2bus_rdack_i;
  wire ip2bus_wrack_i;
  wire p_0_in3_in;
  wire p_1_in2_in;
  wire [3:0]reg1;
  wire [3:0]reg2;
  wire [1:0]reg3;
  wire [1:0]reg4;
  wire s_axi_aclk;
  wire [3:0]s_axi_wdata;

  LUT5 #(
    .INIT(32'hFE02C2C2)) 
    \Dual.ALLOUT0_ND_G0.READ_REG_GEN[0].reg1[28]_i_1 
       (.I0(gpio_io_o[3]),
        .I1(gpio_io_t[3]),
        .I2(p_1_in2_in),
        .I3(gpio_Data_In[0]),
        .I4(p_0_in3_in),
        .O(\Dual.ALLOUT0_ND_G0.READ_REG_GEN[0].reg1[28]_i_1_n_0 ));
  FDRE \Dual.ALLOUT0_ND_G0.READ_REG_GEN[0].reg1_reg[28] 
       (.C(s_axi_aclk),
        .CE(1'b1),
        .D(\Dual.ALLOUT0_ND_G0.READ_REG_GEN[0].reg1[28]_i_1_n_0 ),
        .Q(reg1[3]),
        .R(\Dual.ALLOUT0_ND_G2.READ_REG2_GEN[0].reg4_reg[30]_0 ));
  LUT5 #(
    .INIT(32'hFE02C2C2)) 
    \Dual.ALLOUT0_ND_G0.READ_REG_GEN[0].reg2[28]_i_1 
       (.I0(reg2[3]),
        .I1(gpio_io_t[3]),
        .I2(p_1_in2_in),
        .I3(gpio_Data_In[0]),
        .I4(p_0_in3_in),
        .O(\Dual.ALLOUT0_ND_G0.READ_REG_GEN[0].reg2[28]_i_1_n_0 ));
  FDRE \Dual.ALLOUT0_ND_G0.READ_REG_GEN[0].reg2_reg[28] 
       (.C(s_axi_aclk),
        .CE(1'b1),
        .D(\Dual.ALLOUT0_ND_G0.READ_REG_GEN[0].reg2[28]_i_1_n_0 ),
        .Q(reg2[3]),
        .R(\Dual.ALLOUT0_ND_G2.READ_REG2_GEN[0].reg4_reg[30]_0 ));
  LUT5 #(
    .INIT(32'hFE02C2C2)) 
    \Dual.ALLOUT0_ND_G0.READ_REG_GEN[1].reg1[29]_i_1 
       (.I0(gpio_io_o[2]),
        .I1(gpio_io_t[2]),
        .I2(p_1_in2_in),
        .I3(gpio_Data_In[1]),
        .I4(p_0_in3_in),
        .O(\Dual.ALLOUT0_ND_G0.READ_REG_GEN[1].reg1[29]_i_1_n_0 ));
  FDRE \Dual.ALLOUT0_ND_G0.READ_REG_GEN[1].reg1_reg[29] 
       (.C(s_axi_aclk),
        .CE(1'b1),
        .D(\Dual.ALLOUT0_ND_G0.READ_REG_GEN[1].reg1[29]_i_1_n_0 ),
        .Q(reg1[2]),
        .R(\Dual.ALLOUT0_ND_G2.READ_REG2_GEN[0].reg4_reg[30]_0 ));
  LUT5 #(
    .INIT(32'hFE02C2C2)) 
    \Dual.ALLOUT0_ND_G0.READ_REG_GEN[1].reg2[29]_i_1 
       (.I0(reg2[2]),
        .I1(gpio_io_t[2]),
        .I2(p_1_in2_in),
        .I3(gpio_Data_In[1]),
        .I4(p_0_in3_in),
        .O(\Dual.ALLOUT0_ND_G0.READ_REG_GEN[1].reg2[29]_i_1_n_0 ));
  FDRE \Dual.ALLOUT0_ND_G0.READ_REG_GEN[1].reg2_reg[29] 
       (.C(s_axi_aclk),
        .CE(1'b1),
        .D(\Dual.ALLOUT0_ND_G0.READ_REG_GEN[1].reg2[29]_i_1_n_0 ),
        .Q(reg2[2]),
        .R(\Dual.ALLOUT0_ND_G2.READ_REG2_GEN[0].reg4_reg[30]_0 ));
  LUT5 #(
    .INIT(32'hFE02C2C2)) 
    \Dual.ALLOUT0_ND_G0.READ_REG_GEN[2].reg1[30]_i_1 
       (.I0(gpio_io_o[1]),
        .I1(gpio_io_t[1]),
        .I2(p_1_in2_in),
        .I3(gpio_Data_In[2]),
        .I4(p_0_in3_in),
        .O(\Dual.ALLOUT0_ND_G0.READ_REG_GEN[2].reg1[30]_i_1_n_0 ));
  FDRE \Dual.ALLOUT0_ND_G0.READ_REG_GEN[2].reg1_reg[30] 
       (.C(s_axi_aclk),
        .CE(1'b1),
        .D(\Dual.ALLOUT0_ND_G0.READ_REG_GEN[2].reg1[30]_i_1_n_0 ),
        .Q(reg1[1]),
        .R(\Dual.ALLOUT0_ND_G2.READ_REG2_GEN[0].reg4_reg[30]_0 ));
  LUT5 #(
    .INIT(32'hFE02C2C2)) 
    \Dual.ALLOUT0_ND_G0.READ_REG_GEN[2].reg2[30]_i_1 
       (.I0(reg2[1]),
        .I1(gpio_io_t[1]),
        .I2(p_1_in2_in),
        .I3(gpio_Data_In[2]),
        .I4(p_0_in3_in),
        .O(\Dual.ALLOUT0_ND_G0.READ_REG_GEN[2].reg2[30]_i_1_n_0 ));
  FDRE \Dual.ALLOUT0_ND_G0.READ_REG_GEN[2].reg2_reg[30] 
       (.C(s_axi_aclk),
        .CE(1'b1),
        .D(\Dual.ALLOUT0_ND_G0.READ_REG_GEN[2].reg2[30]_i_1_n_0 ),
        .Q(reg2[1]),
        .R(\Dual.ALLOUT0_ND_G2.READ_REG2_GEN[0].reg4_reg[30]_0 ));
  LUT5 #(
    .INIT(32'hFE02C2C2)) 
    \Dual.ALLOUT0_ND_G0.READ_REG_GEN[3].reg1[31]_i_2 
       (.I0(gpio_io_o[0]),
        .I1(gpio_io_t[0]),
        .I2(p_1_in2_in),
        .I3(gpio_Data_In[3]),
        .I4(p_0_in3_in),
        .O(\Dual.ALLOUT0_ND_G0.READ_REG_GEN[3].reg1[31]_i_2_n_0 ));
  FDRE \Dual.ALLOUT0_ND_G0.READ_REG_GEN[3].reg1_reg[31] 
       (.C(s_axi_aclk),
        .CE(1'b1),
        .D(\Dual.ALLOUT0_ND_G0.READ_REG_GEN[3].reg1[31]_i_2_n_0 ),
        .Q(reg1[0]),
        .R(\Dual.ALLOUT0_ND_G2.READ_REG2_GEN[0].reg4_reg[30]_0 ));
  LUT5 #(
    .INIT(32'hFE02C2C2)) 
    \Dual.ALLOUT0_ND_G0.READ_REG_GEN[3].reg2[31]_i_1 
       (.I0(reg2[0]),
        .I1(gpio_io_t[0]),
        .I2(p_1_in2_in),
        .I3(gpio_Data_In[3]),
        .I4(p_0_in3_in),
        .O(\Dual.ALLOUT0_ND_G0.READ_REG_GEN[3].reg2[31]_i_1_n_0 ));
  FDRE \Dual.ALLOUT0_ND_G0.READ_REG_GEN[3].reg2_reg[31] 
       (.C(s_axi_aclk),
        .CE(1'b1),
        .D(\Dual.ALLOUT0_ND_G0.READ_REG_GEN[3].reg2[31]_i_1_n_0 ),
        .Q(reg2[0]),
        .R(\Dual.ALLOUT0_ND_G2.READ_REG2_GEN[0].reg4_reg[30]_0 ));
  LUT6 #(
    .INIT(64'hCE222222C2222222)) 
    \Dual.ALLOUT0_ND_G2.READ_REG2_GEN[0].reg3[30]_i_1 
       (.I0(gpio2_io_o[1]),
        .I1(\Dual.gpio2_OE_reg[0]_0 ),
        .I2(Q[0]),
        .I3(Q[1]),
        .I4(gpio_reg_en),
        .I5(gpio2_Data_In[0]),
        .O(\Dual.ALLOUT0_ND_G2.READ_REG2_GEN[0].reg3[30]_i_1_n_0 ));
  FDRE \Dual.ALLOUT0_ND_G2.READ_REG2_GEN[0].reg3_reg[30] 
       (.C(s_axi_aclk),
        .CE(1'b1),
        .D(\Dual.ALLOUT0_ND_G2.READ_REG2_GEN[0].reg3[30]_i_1_n_0 ),
        .Q(reg3[1]),
        .R(\Dual.ALLOUT0_ND_G2.READ_REG2_GEN[0].reg4_reg[30]_0 ));
  LUT6 #(
    .INIT(64'hCE222222C2222222)) 
    \Dual.ALLOUT0_ND_G2.READ_REG2_GEN[0].reg4[30]_i_1 
       (.I0(reg4[1]),
        .I1(\Dual.gpio2_OE_reg[0]_0 ),
        .I2(Q[0]),
        .I3(Q[1]),
        .I4(gpio_reg_en),
        .I5(gpio2_Data_In[0]),
        .O(\Dual.ALLOUT0_ND_G2.READ_REG2_GEN[0].reg4[30]_i_1_n_0 ));
  FDRE \Dual.ALLOUT0_ND_G2.READ_REG2_GEN[0].reg4_reg[30] 
       (.C(s_axi_aclk),
        .CE(1'b1),
        .D(\Dual.ALLOUT0_ND_G2.READ_REG2_GEN[0].reg4[30]_i_1_n_0 ),
        .Q(reg4[1]),
        .R(\Dual.ALLOUT0_ND_G2.READ_REG2_GEN[0].reg4_reg[30]_0 ));
  LUT6 #(
    .INIT(64'hCE222222C2222222)) 
    \Dual.ALLOUT0_ND_G2.READ_REG2_GEN[1].reg3[31]_i_1 
       (.I0(gpio2_io_o[0]),
        .I1(\Dual.gpio2_OE_reg[1]_0 ),
        .I2(Q[0]),
        .I3(Q[1]),
        .I4(gpio_reg_en),
        .I5(gpio2_Data_In[1]),
        .O(\Dual.ALLOUT0_ND_G2.READ_REG2_GEN[1].reg3[31]_i_1_n_0 ));
  FDRE \Dual.ALLOUT0_ND_G2.READ_REG2_GEN[1].reg3_reg[31] 
       (.C(s_axi_aclk),
        .CE(1'b1),
        .D(\Dual.ALLOUT0_ND_G2.READ_REG2_GEN[1].reg3[31]_i_1_n_0 ),
        .Q(reg3[0]),
        .R(\Dual.ALLOUT0_ND_G2.READ_REG2_GEN[0].reg4_reg[30]_0 ));
  LUT6 #(
    .INIT(64'hCE222222C2222222)) 
    \Dual.ALLOUT0_ND_G2.READ_REG2_GEN[1].reg4[31]_i_1 
       (.I0(reg4[0]),
        .I1(\Dual.gpio2_OE_reg[1]_0 ),
        .I2(Q[0]),
        .I3(Q[1]),
        .I4(gpio_reg_en),
        .I5(gpio2_Data_In[1]),
        .O(\Dual.ALLOUT0_ND_G2.READ_REG2_GEN[1].reg4[31]_i_1_n_0 ));
  FDRE \Dual.ALLOUT0_ND_G2.READ_REG2_GEN[1].reg4_reg[31] 
       (.C(s_axi_aclk),
        .CE(1'b1),
        .D(\Dual.ALLOUT0_ND_G2.READ_REG2_GEN[1].reg4[31]_i_1_n_0 ),
        .Q(reg4[0]),
        .R(\Dual.ALLOUT0_ND_G2.READ_REG2_GEN[0].reg4_reg[30]_0 ));
  decalper_eb_ot_sdeen_pot_pi_dehcac_xnilix_cdc_sync \Dual.INPUT_DOUBLE_REGS4 
       (.gpio_io_i(gpio_io_i),
        .s_axi_aclk(s_axi_aclk),
        .scndry_vect_out({gpio_io_i_d2[0],gpio_io_i_d2[1],gpio_io_i_d2[2],gpio_io_i_d2[3]}));
  decalper_eb_ot_sdeen_pot_pi_dehcac_xnilix_cdc_sync__parameterized0 \Dual.INPUT_DOUBLE_REGS5 
       (.gpio2_io_i(gpio2_io_i),
        .s_axi_aclk(s_axi_aclk),
        .scndry_vect_out({gpio2_io_i_d2[0],gpio2_io_i_d2[1]}));
  FDRE \Dual.gpio2_Data_In_reg[0] 
       (.C(s_axi_aclk),
        .CE(1'b1),
        .D(gpio2_io_i_d2[0]),
        .Q(gpio2_Data_In[0]),
        .R(1'b0));
  FDRE \Dual.gpio2_Data_In_reg[1] 
       (.C(s_axi_aclk),
        .CE(1'b1),
        .D(gpio2_io_i_d2[1]),
        .Q(gpio2_Data_In[1]),
        .R(1'b0));
  LUT6 #(
    .INIT(64'hFB08FFFFFB080000)) 
    \Dual.gpio2_Data_Out[0]_i_1 
       (.I0(s_axi_wdata[3]),
        .I1(bus2ip_cs),
        .I2(Q[1]),
        .I3(s_axi_wdata[1]),
        .I4(\Dual.gpio2_Data_Out_reg[0]_0 ),
        .I5(gpio2_io_o[1]),
        .O(\Dual.gpio2_Data_Out[0]_i_1_n_0 ));
  LUT6 #(
    .INIT(64'hFB08FFFFFB080000)) 
    \Dual.gpio2_Data_Out[1]_i_1 
       (.I0(s_axi_wdata[2]),
        .I1(bus2ip_cs),
        .I2(Q[1]),
        .I3(s_axi_wdata[0]),
        .I4(\Dual.gpio2_Data_Out_reg[0]_0 ),
        .I5(gpio2_io_o[0]),
        .O(\Dual.gpio2_Data_Out[1]_i_1_n_0 ));
  FDRE #(
    .INIT(1'b0)) 
    \Dual.gpio2_Data_Out_reg[0] 
       (.C(s_axi_aclk),
        .CE(1'b1),
        .D(\Dual.gpio2_Data_Out[0]_i_1_n_0 ),
        .Q(gpio2_io_o[1]),
        .R(bus2ip_reset));
  FDRE #(
    .INIT(1'b0)) 
    \Dual.gpio2_Data_Out_reg[1] 
       (.C(s_axi_aclk),
        .CE(1'b1),
        .D(\Dual.gpio2_Data_Out[1]_i_1_n_0 ),
        .Q(gpio2_io_o[0]),
        .R(bus2ip_reset));
  (* SOFT_HLUTNM = "soft_lutpair12" *) 
  LUT4 #(
    .INIT(16'hEF20)) 
    \Dual.gpio2_OE[0]_i_1 
       (.I0(D[3]),
        .I1(bus2ip_rnw),
        .I2(\Dual.gpio2_OE_reg[0]_1 ),
        .I3(\Dual.gpio2_OE_reg[0]_0 ),
        .O(\Dual.gpio2_OE[0]_i_1_n_0 ));
  (* SOFT_HLUTNM = "soft_lutpair13" *) 
  LUT4 #(
    .INIT(16'hEF20)) 
    \Dual.gpio2_OE[1]_i_1 
       (.I0(D[2]),
        .I1(bus2ip_rnw),
        .I2(\Dual.gpio2_OE_reg[0]_1 ),
        .I3(\Dual.gpio2_OE_reg[1]_0 ),
        .O(\Dual.gpio2_OE[1]_i_1_n_0 ));
  FDSE #(
    .INIT(1'b1)) 
    \Dual.gpio2_OE_reg[0] 
       (.C(s_axi_aclk),
        .CE(1'b1),
        .D(\Dual.gpio2_OE[0]_i_1_n_0 ),
        .Q(\Dual.gpio2_OE_reg[0]_0 ),
        .S(bus2ip_reset));
  FDSE #(
    .INIT(1'b1)) 
    \Dual.gpio2_OE_reg[1] 
       (.C(s_axi_aclk),
        .CE(1'b1),
        .D(\Dual.gpio2_OE[1]_i_1_n_0 ),
        .Q(\Dual.gpio2_OE_reg[1]_0 ),
        .S(bus2ip_reset));
  FDRE \Dual.gpio_Data_In_reg[0] 
       (.C(s_axi_aclk),
        .CE(1'b1),
        .D(gpio_io_i_d2[0]),
        .Q(gpio_Data_In[0]),
        .R(1'b0));
  FDRE \Dual.gpio_Data_In_reg[1] 
       (.C(s_axi_aclk),
        .CE(1'b1),
        .D(gpio_io_i_d2[1]),
        .Q(gpio_Data_In[1]),
        .R(1'b0));
  FDRE \Dual.gpio_Data_In_reg[2] 
       (.C(s_axi_aclk),
        .CE(1'b1),
        .D(gpio_io_i_d2[2]),
        .Q(gpio_Data_In[2]),
        .R(1'b0));
  FDRE \Dual.gpio_Data_In_reg[3] 
       (.C(s_axi_aclk),
        .CE(1'b1),
        .D(gpio_io_i_d2[3]),
        .Q(gpio_Data_In[3]),
        .R(1'b0));
  FDRE #(
    .INIT(1'b0)) 
    \Dual.gpio_Data_Out_reg[0] 
       (.C(s_axi_aclk),
        .CE(E),
        .D(D[3]),
        .Q(gpio_io_o[3]),
        .R(bus2ip_reset));
  FDRE #(
    .INIT(1'b0)) 
    \Dual.gpio_Data_Out_reg[1] 
       (.C(s_axi_aclk),
        .CE(E),
        .D(D[2]),
        .Q(gpio_io_o[2]),
        .R(bus2ip_reset));
  FDRE #(
    .INIT(1'b0)) 
    \Dual.gpio_Data_Out_reg[2] 
       (.C(s_axi_aclk),
        .CE(E),
        .D(D[1]),
        .Q(gpio_io_o[1]),
        .R(bus2ip_reset));
  FDRE #(
    .INIT(1'b0)) 
    \Dual.gpio_Data_Out_reg[3] 
       (.C(s_axi_aclk),
        .CE(E),
        .D(D[0]),
        .Q(gpio_io_o[0]),
        .R(bus2ip_reset));
  FDSE #(
    .INIT(1'b1)) 
    \Dual.gpio_OE_reg[0] 
       (.C(s_axi_aclk),
        .CE(\Dual.gpio_OE_reg[0]_0 ),
        .D(D[3]),
        .Q(gpio_io_t[3]),
        .S(bus2ip_reset));
  FDSE #(
    .INIT(1'b1)) 
    \Dual.gpio_OE_reg[1] 
       (.C(s_axi_aclk),
        .CE(\Dual.gpio_OE_reg[0]_0 ),
        .D(D[2]),
        .Q(gpio_io_t[2]),
        .S(bus2ip_reset));
  FDSE #(
    .INIT(1'b1)) 
    \Dual.gpio_OE_reg[2] 
       (.C(s_axi_aclk),
        .CE(\Dual.gpio_OE_reg[0]_0 ),
        .D(D[1]),
        .Q(gpio_io_t[1]),
        .S(bus2ip_reset));
  FDSE #(
    .INIT(1'b1)) 
    \Dual.gpio_OE_reg[3] 
       (.C(s_axi_aclk),
        .CE(\Dual.gpio_OE_reg[0]_0 ),
        .D(D[0]),
        .Q(gpio_io_t[0]),
        .S(bus2ip_reset));
  LUT5 #(
    .INIT(32'h00040448)) 
    GPIO_DBus
       (.I0(\GEN_BKEND_CE_REGISTERS[3].ce_out_i_reg ),
        .I1(Bus_RNW_reg),
        .I2(\GEN_BKEND_CE_REGISTERS[2].ce_out_i_reg ),
        .I3(\GEN_BKEND_CE_REGISTERS[1].ce_out_i_reg ),
        .I4(\GEN_BKEND_CE_REGISTERS[0].ce_out_i_reg ),
        .O(\GEN_BKEND_CE_REGISTERS[3].ce_out_i_reg[3] ));
  FDRE gpio_xferAck_Reg_reg
       (.C(s_axi_aclk),
        .CE(1'b1),
        .D(GPIO_xferAck_i),
        .Q(gpio_xferAck_Reg),
        .R(bus2ip_reset));
  LUT3 #(
    .INIT(8'h04)) 
    iGPIO_xferAck_i_1
       (.I0(gpio_xferAck_Reg),
        .I1(bus2ip_cs),
        .I2(GPIO_xferAck_i),
        .O(iGPIO_xferAck));
  FDRE iGPIO_xferAck_reg
       (.C(s_axi_aclk),
        .CE(1'b1),
        .D(iGPIO_xferAck),
        .Q(GPIO_xferAck_i),
        .R(bus2ip_reset));
  (* SOFT_HLUTNM = "soft_lutpair13" *) 
  LUT2 #(
    .INIT(4'h8)) 
    ip2bus_rdack_i_D1_i_1
       (.I0(GPIO_xferAck_i),
        .I1(bus2ip_rnw),
        .O(ip2bus_rdack_i));
  (* SOFT_HLUTNM = "soft_lutpair12" *) 
  LUT2 #(
    .INIT(4'h2)) 
    ip2bus_wrack_i_D1_i_1
       (.I0(GPIO_xferAck_i),
        .I1(bus2ip_rnw),
        .O(ip2bus_wrack_i));
endmodule

(* HW_HANDOFF = "PmodBLE.hwdef" *) 
module decalper_eb_ot_sdeen_pot_pi_dehcac_xnilix_PmodBLE
   (BLE_uart_interrupt,
    Pmod_out_pin10_i,
    Pmod_out_pin10_o,
    Pmod_out_pin10_t,
    Pmod_out_pin1_i,
    Pmod_out_pin1_o,
    Pmod_out_pin1_t,
    Pmod_out_pin2_i,
    Pmod_out_pin2_o,
    Pmod_out_pin2_t,
    Pmod_out_pin3_i,
    Pmod_out_pin3_o,
    Pmod_out_pin3_t,
    Pmod_out_pin4_i,
    Pmod_out_pin4_o,
    Pmod_out_pin4_t,
    Pmod_out_pin7_i,
    Pmod_out_pin7_o,
    Pmod_out_pin7_t,
    Pmod_out_pin8_i,
    Pmod_out_pin8_o,
    Pmod_out_pin8_t,
    Pmod_out_pin9_i,
    Pmod_out_pin9_o,
    Pmod_out_pin9_t,
    S_AXI_GPIO_araddr,
    S_AXI_GPIO_arready,
    S_AXI_GPIO_arvalid,
    S_AXI_GPIO_awaddr,
    S_AXI_GPIO_awready,
    S_AXI_GPIO_awvalid,
    S_AXI_GPIO_bready,
    S_AXI_GPIO_bresp,
    S_AXI_GPIO_bvalid,
    S_AXI_GPIO_rdata,
    S_AXI_GPIO_rready,
    S_AXI_GPIO_rresp,
    S_AXI_GPIO_rvalid,
    S_AXI_GPIO_wdata,
    S_AXI_GPIO_wready,
    S_AXI_GPIO_wstrb,
    S_AXI_GPIO_wvalid,
    S_AXI_UART_araddr,
    S_AXI_UART_arready,
    S_AXI_UART_arvalid,
    S_AXI_UART_awaddr,
    S_AXI_UART_awready,
    S_AXI_UART_awvalid,
    S_AXI_UART_bready,
    S_AXI_UART_bresp,
    S_AXI_UART_bvalid,
    S_AXI_UART_rdata,
    S_AXI_UART_rready,
    S_AXI_UART_rresp,
    S_AXI_UART_rvalid,
    S_AXI_UART_wdata,
    S_AXI_UART_wready,
    S_AXI_UART_wstrb,
    S_AXI_UART_wvalid,
    s_axi_aclk,
    s_axi_aresetn);
  (* X_INTERFACE_INFO = "xilinx.com:signal:interrupt:1.0 INTR.BLE_UART_INTERRUPT INTERRUPT" *) (* X_INTERFACE_PARAMETER = "XIL_INTERFACENAME INTR.BLE_UART_INTERRUPT, PortWidth 1, SENSITIVITY LEVEL_HIGH" *) output BLE_uart_interrupt;
  (* X_INTERFACE_INFO = "digilentinc.com:interface:pmod:1.0 Pmod_out " *) input Pmod_out_pin10_i;
  (* X_INTERFACE_INFO = "digilentinc.com:interface:pmod:1.0 Pmod_out " *) output Pmod_out_pin10_o;
  (* X_INTERFACE_INFO = "digilentinc.com:interface:pmod:1.0 Pmod_out " *) output Pmod_out_pin10_t;
  (* X_INTERFACE_INFO = "digilentinc.com:interface:pmod:1.0 Pmod_out " *) input Pmod_out_pin1_i;
  (* X_INTERFACE_INFO = "digilentinc.com:interface:pmod:1.0 Pmod_out " *) output Pmod_out_pin1_o;
  (* X_INTERFACE_INFO = "digilentinc.com:interface:pmod:1.0 Pmod_out " *) output Pmod_out_pin1_t;
  (* X_INTERFACE_INFO = "digilentinc.com:interface:pmod:1.0 Pmod_out " *) input Pmod_out_pin2_i;
  (* X_INTERFACE_INFO = "digilentinc.com:interface:pmod:1.0 Pmod_out " *) output Pmod_out_pin2_o;
  (* X_INTERFACE_INFO = "digilentinc.com:interface:pmod:1.0 Pmod_out " *) output Pmod_out_pin2_t;
  (* X_INTERFACE_INFO = "digilentinc.com:interface:pmod:1.0 Pmod_out " *) input Pmod_out_pin3_i;
  (* X_INTERFACE_INFO = "digilentinc.com:interface:pmod:1.0 Pmod_out " *) output Pmod_out_pin3_o;
  (* X_INTERFACE_INFO = "digilentinc.com:interface:pmod:1.0 Pmod_out " *) output Pmod_out_pin3_t;
  (* X_INTERFACE_INFO = "digilentinc.com:interface:pmod:1.0 Pmod_out " *) input Pmod_out_pin4_i;
  (* X_INTERFACE_INFO = "digilentinc.com:interface:pmod:1.0 Pmod_out " *) output Pmod_out_pin4_o;
  (* X_INTERFACE_INFO = "digilentinc.com:interface:pmod:1.0 Pmod_out " *) output Pmod_out_pin4_t;
  (* X_INTERFACE_INFO = "digilentinc.com:interface:pmod:1.0 Pmod_out " *) input Pmod_out_pin7_i;
  (* X_INTERFACE_INFO = "digilentinc.com:interface:pmod:1.0 Pmod_out " *) output Pmod_out_pin7_o;
  (* X_INTERFACE_INFO = "digilentinc.com:interface:pmod:1.0 Pmod_out " *) output Pmod_out_pin7_t;
  (* X_INTERFACE_INFO = "digilentinc.com:interface:pmod:1.0 Pmod_out " *) input Pmod_out_pin8_i;
  (* X_INTERFACE_INFO = "digilentinc.com:interface:pmod:1.0 Pmod_out " *) output Pmod_out_pin8_o;
  (* X_INTERFACE_INFO = "digilentinc.com:interface:pmod:1.0 Pmod_out " *) output Pmod_out_pin8_t;
  (* X_INTERFACE_INFO = "digilentinc.com:interface:pmod:1.0 Pmod_out " *) input Pmod_out_pin9_i;
  (* X_INTERFACE_INFO = "digilentinc.com:interface:pmod:1.0 Pmod_out " *) output Pmod_out_pin9_o;
  (* X_INTERFACE_INFO = "digilentinc.com:interface:pmod:1.0 Pmod_out " *) output Pmod_out_pin9_t;
  (* X_INTERFACE_INFO = "xilinx.com:interface:aximm:1.0 S_AXI_GPIO ARADDR" *) (* X_INTERFACE_PARAMETER = "XIL_INTERFACENAME S_AXI_GPIO, ADDR_WIDTH 12, ARUSER_WIDTH 0, AWUSER_WIDTH 0, BUSER_WIDTH 0, CLK_DOMAIN PmodBLE_s_axi_aclk_0, DATA_WIDTH 32, FREQ_HZ 100000000, HAS_BRESP 1, HAS_BURST 0, HAS_CACHE 0, HAS_LOCK 0, HAS_PROT 0, HAS_QOS 0, HAS_REGION 0, HAS_RRESP 1, HAS_WSTRB 1, ID_WIDTH 0, MAX_BURST_LENGTH 1, NUM_READ_OUTSTANDING 1, NUM_READ_THREADS 1, NUM_WRITE_OUTSTANDING 1, NUM_WRITE_THREADS 1, PHASE 0.000, PROTOCOL AXI4LITE, READ_WRITE_MODE READ_WRITE, RUSER_BITS_PER_BYTE 0, RUSER_WIDTH 0, SUPPORTS_NARROW_BURST 0, WUSER_BITS_PER_BYTE 0, WUSER_WIDTH 0" *) input [8:0]S_AXI_GPIO_araddr;
  (* X_INTERFACE_INFO = "xilinx.com:interface:aximm:1.0 S_AXI_GPIO ARREADY" *) output S_AXI_GPIO_arready;
  (* X_INTERFACE_INFO = "xilinx.com:interface:aximm:1.0 S_AXI_GPIO ARVALID" *) input S_AXI_GPIO_arvalid;
  (* X_INTERFACE_INFO = "xilinx.com:interface:aximm:1.0 S_AXI_GPIO AWADDR" *) input [8:0]S_AXI_GPIO_awaddr;
  (* X_INTERFACE_INFO = "xilinx.com:interface:aximm:1.0 S_AXI_GPIO AWREADY" *) output S_AXI_GPIO_awready;
  (* X_INTERFACE_INFO = "xilinx.com:interface:aximm:1.0 S_AXI_GPIO AWVALID" *) input S_AXI_GPIO_awvalid;
  (* X_INTERFACE_INFO = "xilinx.com:interface:aximm:1.0 S_AXI_GPIO BREADY" *) input S_AXI_GPIO_bready;
  (* X_INTERFACE_INFO = "xilinx.com:interface:aximm:1.0 S_AXI_GPIO BRESP" *) output [1:0]S_AXI_GPIO_bresp;
  (* X_INTERFACE_INFO = "xilinx.com:interface:aximm:1.0 S_AXI_GPIO BVALID" *) output S_AXI_GPIO_bvalid;
  (* X_INTERFACE_INFO = "xilinx.com:interface:aximm:1.0 S_AXI_GPIO RDATA" *) output [31:0]S_AXI_GPIO_rdata;
  (* X_INTERFACE_INFO = "xilinx.com:interface:aximm:1.0 S_AXI_GPIO RREADY" *) input S_AXI_GPIO_rready;
  (* X_INTERFACE_INFO = "xilinx.com:interface:aximm:1.0 S_AXI_GPIO RRESP" *) output [1:0]S_AXI_GPIO_rresp;
  (* X_INTERFACE_INFO = "xilinx.com:interface:aximm:1.0 S_AXI_GPIO RVALID" *) output S_AXI_GPIO_rvalid;
  (* X_INTERFACE_INFO = "xilinx.com:interface:aximm:1.0 S_AXI_GPIO WDATA" *) input [31:0]S_AXI_GPIO_wdata;
  (* X_INTERFACE_INFO = "xilinx.com:interface:aximm:1.0 S_AXI_GPIO WREADY" *) output S_AXI_GPIO_wready;
  (* X_INTERFACE_INFO = "xilinx.com:interface:aximm:1.0 S_AXI_GPIO WSTRB" *) input [3:0]S_AXI_GPIO_wstrb;
  (* X_INTERFACE_INFO = "xilinx.com:interface:aximm:1.0 S_AXI_GPIO WVALID" *) input S_AXI_GPIO_wvalid;
  (* X_INTERFACE_INFO = "xilinx.com:interface:aximm:1.0 S_AXI_UART ARADDR" *) (* X_INTERFACE_PARAMETER = "XIL_INTERFACENAME S_AXI_UART, ADDR_WIDTH 13, ARUSER_WIDTH 0, AWUSER_WIDTH 0, BUSER_WIDTH 0, CLK_DOMAIN PmodBLE_s_axi_aclk_0, DATA_WIDTH 32, FREQ_HZ 100000000, HAS_BRESP 1, HAS_BURST 0, HAS_CACHE 0, HAS_LOCK 0, HAS_PROT 0, HAS_QOS 0, HAS_REGION 0, HAS_RRESP 1, HAS_WSTRB 1, ID_WIDTH 0, MAX_BURST_LENGTH 1, NUM_READ_OUTSTANDING 1, NUM_READ_THREADS 1, NUM_WRITE_OUTSTANDING 1, NUM_WRITE_THREADS 1, PHASE 0.000, PROTOCOL AXI4LITE, READ_WRITE_MODE READ_WRITE, RUSER_BITS_PER_BYTE 0, RUSER_WIDTH 0, SUPPORTS_NARROW_BURST 0, WUSER_BITS_PER_BYTE 0, WUSER_WIDTH 0" *) input [12:0]S_AXI_UART_araddr;
  (* X_INTERFACE_INFO = "xilinx.com:interface:aximm:1.0 S_AXI_UART ARREADY" *) output S_AXI_UART_arready;
  (* X_INTERFACE_INFO = "xilinx.com:interface:aximm:1.0 S_AXI_UART ARVALID" *) input S_AXI_UART_arvalid;
  (* X_INTERFACE_INFO = "xilinx.com:interface:aximm:1.0 S_AXI_UART AWADDR" *) input [12:0]S_AXI_UART_awaddr;
  (* X_INTERFACE_INFO = "xilinx.com:interface:aximm:1.0 S_AXI_UART AWREADY" *) output S_AXI_UART_awready;
  (* X_INTERFACE_INFO = "xilinx.com:interface:aximm:1.0 S_AXI_UART AWVALID" *) input S_AXI_UART_awvalid;
  (* X_INTERFACE_INFO = "xilinx.com:interface:aximm:1.0 S_AXI_UART BREADY" *) input S_AXI_UART_bready;
  (* X_INTERFACE_INFO = "xilinx.com:interface:aximm:1.0 S_AXI_UART BRESP" *) output [1:0]S_AXI_UART_bresp;
  (* X_INTERFACE_INFO = "xilinx.com:interface:aximm:1.0 S_AXI_UART BVALID" *) output S_AXI_UART_bvalid;
  (* X_INTERFACE_INFO = "xilinx.com:interface:aximm:1.0 S_AXI_UART RDATA" *) output [31:0]S_AXI_UART_rdata;
  (* X_INTERFACE_INFO = "xilinx.com:interface:aximm:1.0 S_AXI_UART RREADY" *) input S_AXI_UART_rready;
  (* X_INTERFACE_INFO = "xilinx.com:interface:aximm:1.0 S_AXI_UART RRESP" *) output [1:0]S_AXI_UART_rresp;
  (* X_INTERFACE_INFO = "xilinx.com:interface:aximm:1.0 S_AXI_UART RVALID" *) output S_AXI_UART_rvalid;
  (* X_INTERFACE_INFO = "xilinx.com:interface:aximm:1.0 S_AXI_UART WDATA" *) input [31:0]S_AXI_UART_wdata;
  (* X_INTERFACE_INFO = "xilinx.com:interface:aximm:1.0 S_AXI_UART WREADY" *) output S_AXI_UART_wready;
  (* X_INTERFACE_INFO = "xilinx.com:interface:aximm:1.0 S_AXI_UART WSTRB" *) input [3:0]S_AXI_UART_wstrb;
  (* X_INTERFACE_INFO = "xilinx.com:interface:aximm:1.0 S_AXI_UART WVALID" *) input S_AXI_UART_wvalid;
  (* X_INTERFACE_INFO = "xilinx.com:signal:clock:1.0 CLK.S_AXI_ACLK CLK" *) (* X_INTERFACE_PARAMETER = "XIL_INTERFACENAME CLK.S_AXI_ACLK, ASSOCIATED_BUSIF S_AXI_GPIO:S_AXI_UART, ASSOCIATED_RESET s_axi_aresetn, CLK_DOMAIN PmodBLE_s_axi_aclk_0, FREQ_HZ 100000000, PHASE 0.000" *) input s_axi_aclk;
  (* X_INTERFACE_INFO = "xilinx.com:signal:reset:1.0 RST.S_AXI_ARESETN RST" *) (* X_INTERFACE_PARAMETER = "XIL_INTERFACENAME RST.S_AXI_ARESETN, POLARITY ACTIVE_LOW" *) input s_axi_aresetn;

  wire BLE_uart_interrupt;
  wire Pmod_out_pin10_i;
  wire Pmod_out_pin10_o;
  wire Pmod_out_pin10_t;
  wire Pmod_out_pin1_i;
  wire Pmod_out_pin1_o;
  wire Pmod_out_pin1_t;
  wire Pmod_out_pin2_i;
  wire Pmod_out_pin2_o;
  wire Pmod_out_pin2_t;
  wire Pmod_out_pin3_i;
  wire Pmod_out_pin3_o;
  wire Pmod_out_pin3_t;
  wire Pmod_out_pin4_i;
  wire Pmod_out_pin4_o;
  wire Pmod_out_pin4_t;
  wire Pmod_out_pin7_i;
  wire Pmod_out_pin7_o;
  wire Pmod_out_pin7_t;
  wire Pmod_out_pin8_i;
  wire Pmod_out_pin8_o;
  wire Pmod_out_pin8_t;
  wire Pmod_out_pin9_i;
  wire Pmod_out_pin9_o;
  wire Pmod_out_pin9_t;
  wire [8:0]S_AXI_GPIO_araddr;
  wire S_AXI_GPIO_arready;
  wire S_AXI_GPIO_arvalid;
  wire [8:0]S_AXI_GPIO_awaddr;
  wire S_AXI_GPIO_awready;
  wire S_AXI_GPIO_awvalid;
  wire S_AXI_GPIO_bready;
  wire [1:0]S_AXI_GPIO_bresp;
  wire S_AXI_GPIO_bvalid;
  wire [31:0]S_AXI_GPIO_rdata;
  wire S_AXI_GPIO_rready;
  wire [1:0]S_AXI_GPIO_rresp;
  wire S_AXI_GPIO_rvalid;
  wire [31:0]S_AXI_GPIO_wdata;
  wire S_AXI_GPIO_wready;
  wire [3:0]S_AXI_GPIO_wstrb;
  wire S_AXI_GPIO_wvalid;
  wire [12:0]S_AXI_UART_araddr;
  wire S_AXI_UART_arready;
  wire S_AXI_UART_arvalid;
  wire [12:0]S_AXI_UART_awaddr;
  wire S_AXI_UART_awready;
  wire S_AXI_UART_awvalid;
  wire S_AXI_UART_bready;
  wire [1:0]S_AXI_UART_bresp;
  wire S_AXI_UART_bvalid;
  wire [31:0]S_AXI_UART_rdata;
  wire S_AXI_UART_rready;
  wire [1:0]S_AXI_UART_rresp;
  wire S_AXI_UART_rvalid;
  wire [31:0]S_AXI_UART_wdata;
  wire S_AXI_UART_wready;
  wire [3:0]S_AXI_UART_wstrb;
  wire S_AXI_UART_wvalid;
  wire [1:0]axi_gpio_0_GPIO2_TRI_I;
  wire [1:0]axi_gpio_0_GPIO2_TRI_O;
  wire [1:0]axi_gpio_0_GPIO2_TRI_T;
  wire [3:0]axi_gpio_0_GPIO_TRI_I;
  wire [3:0]axi_gpio_0_GPIO_TRI_O;
  wire [3:0]axi_gpio_0_GPIO_TRI_T;
  wire axi_uart16550_0_UART_RxD;
  wire axi_uart16550_0_UART_TxD;
  wire s_axi_aclk;
  wire s_axi_aresetn;
  wire NLW_axi_uart16550_0_baudoutn_UNCONNECTED;
  wire NLW_axi_uart16550_0_ddis_UNCONNECTED;
  wire NLW_axi_uart16550_0_dtrn_UNCONNECTED;
  wire NLW_axi_uart16550_0_out1n_UNCONNECTED;
  wire NLW_axi_uart16550_0_out2n_UNCONNECTED;
  wire NLW_axi_uart16550_0_rtsn_UNCONNECTED;
  wire NLW_axi_uart16550_0_rxrdyn_UNCONNECTED;
  wire NLW_axi_uart16550_0_txrdyn_UNCONNECTED;

  (* CHECK_LICENSE_TYPE = "PmodBLE_axi_gpio_0_0,axi_gpio,{}" *) 
  (* downgradeipidentifiedwarnings = "yes" *) 
  (* x_core_info = "axi_gpio,Vivado 2019.2" *) 
  decalper_eb_ot_sdeen_pot_pi_dehcac_xnilix_PmodBLE_axi_gpio_0_0 axi_gpio_0
       (.gpio2_io_i(axi_gpio_0_GPIO2_TRI_I),
        .gpio2_io_o(axi_gpio_0_GPIO2_TRI_O),
        .gpio2_io_t(axi_gpio_0_GPIO2_TRI_T),
        .gpio_io_i(axi_gpio_0_GPIO_TRI_I),
        .gpio_io_o(axi_gpio_0_GPIO_TRI_O),
        .gpio_io_t(axi_gpio_0_GPIO_TRI_T),
        .s_axi_aclk(s_axi_aclk),
        .s_axi_araddr(S_AXI_GPIO_araddr),
        .s_axi_aresetn(s_axi_aresetn),
        .s_axi_arready(S_AXI_GPIO_arready),
        .s_axi_arvalid(S_AXI_GPIO_arvalid),
        .s_axi_awaddr(S_AXI_GPIO_awaddr),
        .s_axi_awready(S_AXI_GPIO_awready),
        .s_axi_awvalid(S_AXI_GPIO_awvalid),
        .s_axi_bready(S_AXI_GPIO_bready),
        .s_axi_bresp(S_AXI_GPIO_bresp),
        .s_axi_bvalid(S_AXI_GPIO_bvalid),
        .s_axi_rdata(S_AXI_GPIO_rdata),
        .s_axi_rready(S_AXI_GPIO_rready),
        .s_axi_rresp(S_AXI_GPIO_rresp),
        .s_axi_rvalid(S_AXI_GPIO_rvalid),
        .s_axi_wdata(S_AXI_GPIO_wdata),
        .s_axi_wready(S_AXI_GPIO_wready),
        .s_axi_wstrb(S_AXI_GPIO_wstrb),
        .s_axi_wvalid(S_AXI_GPIO_wvalid));
  (* CHECK_LICENSE_TYPE = "PmodBLE_axi_uart16550_0_0,axi_uart16550,{}" *) 
  (* downgradeipidentifiedwarnings = "yes" *) 
  (* x_core_info = "axi_uart16550,Vivado 2019.2" *) 
  decalper_eb_ot_sdeen_pot_pi_dehcac_xnilix_PmodBLE_axi_uart16550_0_0 axi_uart16550_0
       (.baudoutn(NLW_axi_uart16550_0_baudoutn_UNCONNECTED),
        .ctsn(1'b1),
        .dcdn(1'b1),
        .ddis(NLW_axi_uart16550_0_ddis_UNCONNECTED),
        .dsrn(1'b1),
        .dtrn(NLW_axi_uart16550_0_dtrn_UNCONNECTED),
        .freeze(1'b0),
        .ip2intc_irpt(BLE_uart_interrupt),
        .out1n(NLW_axi_uart16550_0_out1n_UNCONNECTED),
        .out2n(NLW_axi_uart16550_0_out2n_UNCONNECTED),
        .rin(1'b1),
        .rtsn(NLW_axi_uart16550_0_rtsn_UNCONNECTED),
        .rxrdyn(NLW_axi_uart16550_0_rxrdyn_UNCONNECTED),
        .s_axi_aclk(s_axi_aclk),
        .s_axi_araddr(S_AXI_UART_araddr),
        .s_axi_aresetn(s_axi_aresetn),
        .s_axi_arready(S_AXI_UART_arready),
        .s_axi_arvalid(S_AXI_UART_arvalid),
        .s_axi_awaddr(S_AXI_UART_awaddr),
        .s_axi_awready(S_AXI_UART_awready),
        .s_axi_awvalid(S_AXI_UART_awvalid),
        .s_axi_bready(S_AXI_UART_bready),
        .s_axi_bresp(S_AXI_UART_bresp),
        .s_axi_bvalid(S_AXI_UART_bvalid),
        .s_axi_rdata(S_AXI_UART_rdata),
        .s_axi_rready(S_AXI_UART_rready),
        .s_axi_rresp(S_AXI_UART_rresp),
        .s_axi_rvalid(S_AXI_UART_rvalid),
        .s_axi_wdata(S_AXI_UART_wdata),
        .s_axi_wready(S_AXI_UART_wready),
        .s_axi_wstrb(S_AXI_UART_wstrb),
        .s_axi_wvalid(S_AXI_UART_wvalid),
        .sin(axi_uart16550_0_UART_RxD),
        .sout(axi_uart16550_0_UART_TxD),
        .txrdyn(NLW_axi_uart16550_0_txrdyn_UNCONNECTED));
  (* CHECK_LICENSE_TYPE = "PmodBLE_pmod_bridge_0_0,pmod_concat,{}" *) 
  (* downgradeipidentifiedwarnings = "yes" *) 
  (* x_core_info = "pmod_concat,Vivado 2019.2" *) 
  decalper_eb_ot_sdeen_pot_pi_dehcac_xnilix_PmodBLE_pmod_bridge_0_0 pmod_bridge_0
       (.in1_O(axi_uart16550_0_UART_TxD),
        .in2_I(axi_uart16550_0_UART_RxD),
        .in_bottom_bus_I(axi_gpio_0_GPIO_TRI_I),
        .in_bottom_bus_O(axi_gpio_0_GPIO_TRI_O),
        .in_bottom_bus_T(axi_gpio_0_GPIO_TRI_T),
        .in_top_uart_gpio_bus_I(axi_gpio_0_GPIO2_TRI_I),
        .in_top_uart_gpio_bus_O(axi_gpio_0_GPIO2_TRI_O),
        .in_top_uart_gpio_bus_T(axi_gpio_0_GPIO2_TRI_T),
        .out0_I(Pmod_out_pin1_i),
        .out0_O(Pmod_out_pin1_o),
        .out0_T(Pmod_out_pin1_t),
        .out1_I(Pmod_out_pin2_i),
        .out1_O(Pmod_out_pin2_o),
        .out1_T(Pmod_out_pin2_t),
        .out2_I(Pmod_out_pin3_i),
        .out2_O(Pmod_out_pin3_o),
        .out2_T(Pmod_out_pin3_t),
        .out3_I(Pmod_out_pin4_i),
        .out3_O(Pmod_out_pin4_o),
        .out3_T(Pmod_out_pin4_t),
        .out4_I(Pmod_out_pin7_i),
        .out4_O(Pmod_out_pin7_o),
        .out4_T(Pmod_out_pin7_t),
        .out5_I(Pmod_out_pin8_i),
        .out5_O(Pmod_out_pin8_o),
        .out5_T(Pmod_out_pin8_t),
        .out6_I(Pmod_out_pin9_i),
        .out6_O(Pmod_out_pin9_o),
        .out6_T(Pmod_out_pin9_t),
        .out7_I(Pmod_out_pin10_i),
        .out7_O(Pmod_out_pin10_o),
        .out7_T(Pmod_out_pin10_t));
endmodule

(* CHECK_LICENSE_TYPE = "PmodBLE_0,PmodBLE,{}" *) (* DowngradeIPIdentifiedWarnings = "yes" *) (* IP_DEFINITION_SOURCE = "IPI" *) 
(* X_CORE_INFO = "PmodBLE,Vivado 2019.2" *) 
(* NotValidForBitStream *)
module decalper_eb_ot_sdeen_pot_pi_dehcac_xnilix
   (Pmod_out_pin10_i,
    Pmod_out_pin10_o,
    Pmod_out_pin10_t,
    Pmod_out_pin1_i,
    Pmod_out_pin1_o,
    Pmod_out_pin1_t,
    Pmod_out_pin2_i,
    Pmod_out_pin2_o,
    Pmod_out_pin2_t,
    Pmod_out_pin3_i,
    Pmod_out_pin3_o,
    Pmod_out_pin3_t,
    Pmod_out_pin4_i,
    Pmod_out_pin4_o,
    Pmod_out_pin4_t,
    Pmod_out_pin7_i,
    Pmod_out_pin7_o,
    Pmod_out_pin7_t,
    Pmod_out_pin8_i,
    Pmod_out_pin8_o,
    Pmod_out_pin8_t,
    Pmod_out_pin9_i,
    Pmod_out_pin9_o,
    Pmod_out_pin9_t,
    S_AXI_GPIO_araddr,
    S_AXI_GPIO_arready,
    S_AXI_GPIO_arvalid,
    S_AXI_GPIO_awaddr,
    S_AXI_GPIO_awready,
    S_AXI_GPIO_awvalid,
    S_AXI_GPIO_bready,
    S_AXI_GPIO_bresp,
    S_AXI_GPIO_bvalid,
    S_AXI_GPIO_rdata,
    S_AXI_GPIO_rready,
    S_AXI_GPIO_rresp,
    S_AXI_GPIO_rvalid,
    S_AXI_GPIO_wdata,
    S_AXI_GPIO_wready,
    S_AXI_GPIO_wstrb,
    S_AXI_GPIO_wvalid,
    S_AXI_UART_araddr,
    S_AXI_UART_arready,
    S_AXI_UART_arvalid,
    S_AXI_UART_awaddr,
    S_AXI_UART_awready,
    S_AXI_UART_awvalid,
    S_AXI_UART_bready,
    S_AXI_UART_bresp,
    S_AXI_UART_bvalid,
    S_AXI_UART_rdata,
    S_AXI_UART_rready,
    S_AXI_UART_rresp,
    S_AXI_UART_rvalid,
    S_AXI_UART_wdata,
    S_AXI_UART_wready,
    S_AXI_UART_wstrb,
    S_AXI_UART_wvalid,
    BLE_uart_interrupt,
    s_axi_aclk,
    s_axi_aresetn);
  (* X_INTERFACE_INFO = "digilentinc.com:interface:pmod:1.0 Pmod_out PIN10_I" *) input Pmod_out_pin10_i;
  (* X_INTERFACE_INFO = "digilentinc.com:interface:pmod:1.0 Pmod_out PIN10_O" *) output Pmod_out_pin10_o;
  (* X_INTERFACE_INFO = "digilentinc.com:interface:pmod:1.0 Pmod_out PIN10_T" *) output Pmod_out_pin10_t;
  (* X_INTERFACE_INFO = "digilentinc.com:interface:pmod:1.0 Pmod_out PIN1_I" *) input Pmod_out_pin1_i;
  (* X_INTERFACE_INFO = "digilentinc.com:interface:pmod:1.0 Pmod_out PIN1_O" *) output Pmod_out_pin1_o;
  (* X_INTERFACE_INFO = "digilentinc.com:interface:pmod:1.0 Pmod_out PIN1_T" *) output Pmod_out_pin1_t;
  (* X_INTERFACE_INFO = "digilentinc.com:interface:pmod:1.0 Pmod_out PIN2_I" *) input Pmod_out_pin2_i;
  (* X_INTERFACE_INFO = "digilentinc.com:interface:pmod:1.0 Pmod_out PIN2_O" *) output Pmod_out_pin2_o;
  (* X_INTERFACE_INFO = "digilentinc.com:interface:pmod:1.0 Pmod_out PIN2_T" *) output Pmod_out_pin2_t;
  (* X_INTERFACE_INFO = "digilentinc.com:interface:pmod:1.0 Pmod_out PIN3_I" *) input Pmod_out_pin3_i;
  (* X_INTERFACE_INFO = "digilentinc.com:interface:pmod:1.0 Pmod_out PIN3_O" *) output Pmod_out_pin3_o;
  (* X_INTERFACE_INFO = "digilentinc.com:interface:pmod:1.0 Pmod_out PIN3_T" *) output Pmod_out_pin3_t;
  (* X_INTERFACE_INFO = "digilentinc.com:interface:pmod:1.0 Pmod_out PIN4_I" *) input Pmod_out_pin4_i;
  (* X_INTERFACE_INFO = "digilentinc.com:interface:pmod:1.0 Pmod_out PIN4_O" *) output Pmod_out_pin4_o;
  (* X_INTERFACE_INFO = "digilentinc.com:interface:pmod:1.0 Pmod_out PIN4_T" *) output Pmod_out_pin4_t;
  (* X_INTERFACE_INFO = "digilentinc.com:interface:pmod:1.0 Pmod_out PIN7_I" *) input Pmod_out_pin7_i;
  (* X_INTERFACE_INFO = "digilentinc.com:interface:pmod:1.0 Pmod_out PIN7_O" *) output Pmod_out_pin7_o;
  (* X_INTERFACE_INFO = "digilentinc.com:interface:pmod:1.0 Pmod_out PIN7_T" *) output Pmod_out_pin7_t;
  (* X_INTERFACE_INFO = "digilentinc.com:interface:pmod:1.0 Pmod_out PIN8_I" *) input Pmod_out_pin8_i;
  (* X_INTERFACE_INFO = "digilentinc.com:interface:pmod:1.0 Pmod_out PIN8_O" *) output Pmod_out_pin8_o;
  (* X_INTERFACE_INFO = "digilentinc.com:interface:pmod:1.0 Pmod_out PIN8_T" *) output Pmod_out_pin8_t;
  (* X_INTERFACE_INFO = "digilentinc.com:interface:pmod:1.0 Pmod_out PIN9_I" *) input Pmod_out_pin9_i;
  (* X_INTERFACE_INFO = "digilentinc.com:interface:pmod:1.0 Pmod_out PIN9_O" *) output Pmod_out_pin9_o;
  (* X_INTERFACE_INFO = "digilentinc.com:interface:pmod:1.0 Pmod_out PIN9_T" *) (* X_INTERFACE_PARAMETER = "XIL_INTERFACENAME Pmod_out, BUSIF.BOARD_INTERFACE Custom, BOARD.ASSOCIATED_PARAM PMOD" *) output Pmod_out_pin9_t;
  (* X_INTERFACE_INFO = "xilinx.com:interface:aximm:1.0 S_AXI_GPIO ARADDR" *) input [8:0]S_AXI_GPIO_araddr;
  (* X_INTERFACE_INFO = "xilinx.com:interface:aximm:1.0 S_AXI_GPIO ARREADY" *) output S_AXI_GPIO_arready;
  (* X_INTERFACE_INFO = "xilinx.com:interface:aximm:1.0 S_AXI_GPIO ARVALID" *) input S_AXI_GPIO_arvalid;
  (* X_INTERFACE_INFO = "xilinx.com:interface:aximm:1.0 S_AXI_GPIO AWADDR" *) input [8:0]S_AXI_GPIO_awaddr;
  (* X_INTERFACE_INFO = "xilinx.com:interface:aximm:1.0 S_AXI_GPIO AWREADY" *) output S_AXI_GPIO_awready;
  (* X_INTERFACE_INFO = "xilinx.com:interface:aximm:1.0 S_AXI_GPIO AWVALID" *) input S_AXI_GPIO_awvalid;
  (* X_INTERFACE_INFO = "xilinx.com:interface:aximm:1.0 S_AXI_GPIO BREADY" *) input S_AXI_GPIO_bready;
  (* X_INTERFACE_INFO = "xilinx.com:interface:aximm:1.0 S_AXI_GPIO BRESP" *) output [1:0]S_AXI_GPIO_bresp;
  (* X_INTERFACE_INFO = "xilinx.com:interface:aximm:1.0 S_AXI_GPIO BVALID" *) output S_AXI_GPIO_bvalid;
  (* X_INTERFACE_INFO = "xilinx.com:interface:aximm:1.0 S_AXI_GPIO RDATA" *) output [31:0]S_AXI_GPIO_rdata;
  (* X_INTERFACE_INFO = "xilinx.com:interface:aximm:1.0 S_AXI_GPIO RREADY" *) input S_AXI_GPIO_rready;
  (* X_INTERFACE_INFO = "xilinx.com:interface:aximm:1.0 S_AXI_GPIO RRESP" *) output [1:0]S_AXI_GPIO_rresp;
  (* X_INTERFACE_INFO = "xilinx.com:interface:aximm:1.0 S_AXI_GPIO RVALID" *) output S_AXI_GPIO_rvalid;
  (* X_INTERFACE_INFO = "xilinx.com:interface:aximm:1.0 S_AXI_GPIO WDATA" *) input [31:0]S_AXI_GPIO_wdata;
  (* X_INTERFACE_INFO = "xilinx.com:interface:aximm:1.0 S_AXI_GPIO WREADY" *) output S_AXI_GPIO_wready;
  (* X_INTERFACE_INFO = "xilinx.com:interface:aximm:1.0 S_AXI_GPIO WSTRB" *) input [3:0]S_AXI_GPIO_wstrb;
  (* X_INTERFACE_INFO = "xilinx.com:interface:aximm:1.0 S_AXI_GPIO WVALID" *) (* X_INTERFACE_PARAMETER = "XIL_INTERFACENAME S_AXI_GPIO, DATA_WIDTH 32, PROTOCOL AXI4LITE, ID_WIDTH 0, ADDR_WIDTH 12, AWUSER_WIDTH 0, ARUSER_WIDTH 0, WUSER_WIDTH 0, RUSER_WIDTH 0, BUSER_WIDTH 0, READ_WRITE_MODE READ_WRITE, HAS_BURST 0, HAS_LOCK 0, HAS_PROT 0, HAS_CACHE 0, HAS_QOS 0, HAS_REGION 0, HAS_WSTRB 1, HAS_BRESP 1, HAS_RRESP 1, SUPPORTS_NARROW_BURST 0, NUM_READ_OUTSTANDING 1, NUM_WRITE_OUTSTANDING 1, MAX_BURST_LENGTH 1, NUM_READ_THREADS 1, NUM_WRITE_THREADS 1, RUSER_BITS_PER_BYTE 0, WUSER_BITS_PER_BYTE 0, FREQ_HZ 100000000, PHASE 0.000, INSERT_VIP 0" *) input S_AXI_GPIO_wvalid;
  (* X_INTERFACE_INFO = "xilinx.com:interface:aximm:1.0 S_AXI_UART ARADDR" *) input [12:0]S_AXI_UART_araddr;
  (* X_INTERFACE_INFO = "xilinx.com:interface:aximm:1.0 S_AXI_UART ARREADY" *) output S_AXI_UART_arready;
  (* X_INTERFACE_INFO = "xilinx.com:interface:aximm:1.0 S_AXI_UART ARVALID" *) input S_AXI_UART_arvalid;
  (* X_INTERFACE_INFO = "xilinx.com:interface:aximm:1.0 S_AXI_UART AWADDR" *) input [12:0]S_AXI_UART_awaddr;
  (* X_INTERFACE_INFO = "xilinx.com:interface:aximm:1.0 S_AXI_UART AWREADY" *) output S_AXI_UART_awready;
  (* X_INTERFACE_INFO = "xilinx.com:interface:aximm:1.0 S_AXI_UART AWVALID" *) input S_AXI_UART_awvalid;
  (* X_INTERFACE_INFO = "xilinx.com:interface:aximm:1.0 S_AXI_UART BREADY" *) input S_AXI_UART_bready;
  (* X_INTERFACE_INFO = "xilinx.com:interface:aximm:1.0 S_AXI_UART BRESP" *) output [1:0]S_AXI_UART_bresp;
  (* X_INTERFACE_INFO = "xilinx.com:interface:aximm:1.0 S_AXI_UART BVALID" *) output S_AXI_UART_bvalid;
  (* X_INTERFACE_INFO = "xilinx.com:interface:aximm:1.0 S_AXI_UART RDATA" *) output [31:0]S_AXI_UART_rdata;
  (* X_INTERFACE_INFO = "xilinx.com:interface:aximm:1.0 S_AXI_UART RREADY" *) input S_AXI_UART_rready;
  (* X_INTERFACE_INFO = "xilinx.com:interface:aximm:1.0 S_AXI_UART RRESP" *) output [1:0]S_AXI_UART_rresp;
  (* X_INTERFACE_INFO = "xilinx.com:interface:aximm:1.0 S_AXI_UART RVALID" *) output S_AXI_UART_rvalid;
  (* X_INTERFACE_INFO = "xilinx.com:interface:aximm:1.0 S_AXI_UART WDATA" *) input [31:0]S_AXI_UART_wdata;
  (* X_INTERFACE_INFO = "xilinx.com:interface:aximm:1.0 S_AXI_UART WREADY" *) output S_AXI_UART_wready;
  (* X_INTERFACE_INFO = "xilinx.com:interface:aximm:1.0 S_AXI_UART WSTRB" *) input [3:0]S_AXI_UART_wstrb;
  (* X_INTERFACE_INFO = "xilinx.com:interface:aximm:1.0 S_AXI_UART WVALID" *) (* X_INTERFACE_PARAMETER = "XIL_INTERFACENAME S_AXI_UART, DATA_WIDTH 32, PROTOCOL AXI4LITE, ID_WIDTH 0, ADDR_WIDTH 13, AWUSER_WIDTH 0, ARUSER_WIDTH 0, WUSER_WIDTH 0, RUSER_WIDTH 0, BUSER_WIDTH 0, READ_WRITE_MODE READ_WRITE, HAS_BURST 0, HAS_LOCK 0, HAS_PROT 0, HAS_CACHE 0, HAS_QOS 0, HAS_REGION 0, HAS_WSTRB 1, HAS_BRESP 1, HAS_RRESP 1, SUPPORTS_NARROW_BURST 0, NUM_READ_OUTSTANDING 1, NUM_WRITE_OUTSTANDING 1, MAX_BURST_LENGTH 1, NUM_READ_THREADS 1, NUM_WRITE_THREADS 1, RUSER_BITS_PER_BYTE 0, WUSER_BITS_PER_BYTE 0, FREQ_HZ 100000000, PHASE 0.000, INSERT_VIP 0" *) input S_AXI_UART_wvalid;
  (* X_INTERFACE_INFO = "xilinx.com:signal:interrupt:1.0 INTR.BLE_UART_INTERRUPT INTERRUPT" *) (* X_INTERFACE_PARAMETER = "XIL_INTERFACENAME INTR.BLE_UART_INTERRUPT, PortWidth 1, SENSITIVITY LEVEL_HIGH" *) output BLE_uart_interrupt;
  (* X_INTERFACE_INFO = "xilinx.com:signal:clock:1.0 CLK.S_AXI_ACLK CLK" *) (* X_INTERFACE_PARAMETER = "XIL_INTERFACENAME CLK.S_AXI_ACLK, ASSOCIATED_BUSIF S_AXI_GPIO:S_AXI_UART, ASSOCIATED_RESET s_axi_aresetn, FREQ_HZ 100000000, PHASE 0.000, INSERT_VIP 0" *) input s_axi_aclk;
  (* X_INTERFACE_INFO = "xilinx.com:signal:reset:1.0 RST.S_AXI_ARESETN RST" *) (* X_INTERFACE_PARAMETER = "XIL_INTERFACENAME RST.S_AXI_ARESETN, POLARITY ACTIVE_LOW, INSERT_VIP 0" *) input s_axi_aresetn;

  wire BLE_uart_interrupt;
  wire Pmod_out_pin10_i;
  wire Pmod_out_pin10_o;
  wire Pmod_out_pin10_t;
  wire Pmod_out_pin1_i;
  wire Pmod_out_pin1_o;
  wire Pmod_out_pin1_t;
  wire Pmod_out_pin2_i;
  wire Pmod_out_pin2_o;
  wire Pmod_out_pin2_t;
  wire Pmod_out_pin3_i;
  wire Pmod_out_pin3_o;
  wire Pmod_out_pin3_t;
  wire Pmod_out_pin4_i;
  wire Pmod_out_pin4_o;
  wire Pmod_out_pin4_t;
  wire Pmod_out_pin7_i;
  wire Pmod_out_pin7_o;
  wire Pmod_out_pin7_t;
  wire Pmod_out_pin8_i;
  wire Pmod_out_pin8_o;
  wire Pmod_out_pin8_t;
  wire Pmod_out_pin9_i;
  wire Pmod_out_pin9_o;
  wire Pmod_out_pin9_t;
  wire [8:0]S_AXI_GPIO_araddr;
  wire S_AXI_GPIO_arready;
  wire S_AXI_GPIO_arvalid;
  wire [8:0]S_AXI_GPIO_awaddr;
  wire S_AXI_GPIO_awready;
  wire S_AXI_GPIO_awvalid;
  wire S_AXI_GPIO_bready;
  wire [1:0]S_AXI_GPIO_bresp;
  wire S_AXI_GPIO_bvalid;
  wire [31:0]S_AXI_GPIO_rdata;
  wire S_AXI_GPIO_rready;
  wire [1:0]S_AXI_GPIO_rresp;
  wire S_AXI_GPIO_rvalid;
  wire [31:0]S_AXI_GPIO_wdata;
  wire S_AXI_GPIO_wready;
  wire [3:0]S_AXI_GPIO_wstrb;
  wire S_AXI_GPIO_wvalid;
  wire [12:0]S_AXI_UART_araddr;
  wire S_AXI_UART_arready;
  wire S_AXI_UART_arvalid;
  wire [12:0]S_AXI_UART_awaddr;
  wire S_AXI_UART_awready;
  wire S_AXI_UART_awvalid;
  wire S_AXI_UART_bready;
  wire [1:0]S_AXI_UART_bresp;
  wire S_AXI_UART_bvalid;
  wire [31:0]S_AXI_UART_rdata;
  wire S_AXI_UART_rready;
  wire [1:0]S_AXI_UART_rresp;
  wire S_AXI_UART_rvalid;
  wire [31:0]S_AXI_UART_wdata;
  wire S_AXI_UART_wready;
  wire [3:0]S_AXI_UART_wstrb;
  wire S_AXI_UART_wvalid;
  wire s_axi_aclk;
  wire s_axi_aresetn;

  (* HW_HANDOFF = "PmodBLE.hwdef" *) 
  decalper_eb_ot_sdeen_pot_pi_dehcac_xnilix_PmodBLE inst
       (.BLE_uart_interrupt(BLE_uart_interrupt),
        .Pmod_out_pin10_i(Pmod_out_pin10_i),
        .Pmod_out_pin10_o(Pmod_out_pin10_o),
        .Pmod_out_pin10_t(Pmod_out_pin10_t),
        .Pmod_out_pin1_i(Pmod_out_pin1_i),
        .Pmod_out_pin1_o(Pmod_out_pin1_o),
        .Pmod_out_pin1_t(Pmod_out_pin1_t),
        .Pmod_out_pin2_i(Pmod_out_pin2_i),
        .Pmod_out_pin2_o(Pmod_out_pin2_o),
        .Pmod_out_pin2_t(Pmod_out_pin2_t),
        .Pmod_out_pin3_i(Pmod_out_pin3_i),
        .Pmod_out_pin3_o(Pmod_out_pin3_o),
        .Pmod_out_pin3_t(Pmod_out_pin3_t),
        .Pmod_out_pin4_i(Pmod_out_pin4_i),
        .Pmod_out_pin4_o(Pmod_out_pin4_o),
        .Pmod_out_pin4_t(Pmod_out_pin4_t),
        .Pmod_out_pin7_i(Pmod_out_pin7_i),
        .Pmod_out_pin7_o(Pmod_out_pin7_o),
        .Pmod_out_pin7_t(Pmod_out_pin7_t),
        .Pmod_out_pin8_i(Pmod_out_pin8_i),
        .Pmod_out_pin8_o(Pmod_out_pin8_o),
        .Pmod_out_pin8_t(Pmod_out_pin8_t),
        .Pmod_out_pin9_i(Pmod_out_pin9_i),
        .Pmod_out_pin9_o(Pmod_out_pin9_o),
        .Pmod_out_pin9_t(Pmod_out_pin9_t),
        .S_AXI_GPIO_araddr(S_AXI_GPIO_araddr),
        .S_AXI_GPIO_arready(S_AXI_GPIO_arready),
        .S_AXI_GPIO_arvalid(S_AXI_GPIO_arvalid),
        .S_AXI_GPIO_awaddr(S_AXI_GPIO_awaddr),
        .S_AXI_GPIO_awready(S_AXI_GPIO_awready),
        .S_AXI_GPIO_awvalid(S_AXI_GPIO_awvalid),
        .S_AXI_GPIO_bready(S_AXI_GPIO_bready),
        .S_AXI_GPIO_bresp(S_AXI_GPIO_bresp),
        .S_AXI_GPIO_bvalid(S_AXI_GPIO_bvalid),
        .S_AXI_GPIO_rdata(S_AXI_GPIO_rdata),
        .S_AXI_GPIO_rready(S_AXI_GPIO_rready),
        .S_AXI_GPIO_rresp(S_AXI_GPIO_rresp),
        .S_AXI_GPIO_rvalid(S_AXI_GPIO_rvalid),
        .S_AXI_GPIO_wdata(S_AXI_GPIO_wdata),
        .S_AXI_GPIO_wready(S_AXI_GPIO_wready),
        .S_AXI_GPIO_wstrb(S_AXI_GPIO_wstrb),
        .S_AXI_GPIO_wvalid(S_AXI_GPIO_wvalid),
        .S_AXI_UART_araddr(S_AXI_UART_araddr),
        .S_AXI_UART_arready(S_AXI_UART_arready),
        .S_AXI_UART_arvalid(S_AXI_UART_arvalid),
        .S_AXI_UART_awaddr(S_AXI_UART_awaddr),
        .S_AXI_UART_awready(S_AXI_UART_awready),
        .S_AXI_UART_awvalid(S_AXI_UART_awvalid),
        .S_AXI_UART_bready(S_AXI_UART_bready),
        .S_AXI_UART_bresp(S_AXI_UART_bresp),
        .S_AXI_UART_bvalid(S_AXI_UART_bvalid),
        .S_AXI_UART_rdata(S_AXI_UART_rdata),
        .S_AXI_UART_rready(S_AXI_UART_rready),
        .S_AXI_UART_rresp(S_AXI_UART_rresp),
        .S_AXI_UART_rvalid(S_AXI_UART_rvalid),
        .S_AXI_UART_wdata(S_AXI_UART_wdata),
        .S_AXI_UART_wready(S_AXI_UART_wready),
        .S_AXI_UART_wstrb(S_AXI_UART_wstrb),
        .S_AXI_UART_wvalid(S_AXI_UART_wvalid),
        .s_axi_aclk(s_axi_aclk),
        .s_axi_aresetn(s_axi_aresetn));
endmodule

(* CHECK_LICENSE_TYPE = "PmodBLE_axi_gpio_0_0,axi_gpio,{}" *) (* DowngradeIPIdentifiedWarnings = "yes" *) (* X_CORE_INFO = "axi_gpio,Vivado 2019.2" *) 
module decalper_eb_ot_sdeen_pot_pi_dehcac_xnilix_PmodBLE_axi_gpio_0_0
   (s_axi_aclk,
    s_axi_aresetn,
    s_axi_awaddr,
    s_axi_awvalid,
    s_axi_awready,
    s_axi_wdata,
    s_axi_wstrb,
    s_axi_wvalid,
    s_axi_wready,
    s_axi_bresp,
    s_axi_bvalid,
    s_axi_bready,
    s_axi_araddr,
    s_axi_arvalid,
    s_axi_arready,
    s_axi_rdata,
    s_axi_rresp,
    s_axi_rvalid,
    s_axi_rready,
    gpio_io_i,
    gpio_io_o,
    gpio_io_t,
    gpio2_io_i,
    gpio2_io_o,
    gpio2_io_t);
  (* X_INTERFACE_INFO = "xilinx.com:signal:clock:1.0 S_AXI_ACLK CLK" *) (* X_INTERFACE_PARAMETER = "XIL_INTERFACENAME S_AXI_ACLK, ASSOCIATED_BUSIF S_AXI, ASSOCIATED_RESET s_axi_aresetn, FREQ_HZ 100000000, PHASE 0.000, INSERT_VIP 0" *) input s_axi_aclk;
  (* X_INTERFACE_INFO = "xilinx.com:signal:reset:1.0 S_AXI_ARESETN RST" *) (* X_INTERFACE_PARAMETER = "XIL_INTERFACENAME S_AXI_ARESETN, POLARITY ACTIVE_LOW, INSERT_VIP 0" *) input s_axi_aresetn;
  (* X_INTERFACE_INFO = "xilinx.com:interface:aximm:1.0 S_AXI AWADDR" *) (* X_INTERFACE_PARAMETER = "XIL_INTERFACENAME S_AXI, DATA_WIDTH 32, PROTOCOL AXI4LITE, FREQ_HZ 100000000, ID_WIDTH 0, ADDR_WIDTH 9, AWUSER_WIDTH 0, ARUSER_WIDTH 0, WUSER_WIDTH 0, RUSER_WIDTH 0, BUSER_WIDTH 0, READ_WRITE_MODE READ_WRITE, HAS_BURST 0, HAS_LOCK 0, HAS_PROT 0, HAS_CACHE 0, HAS_QOS 0, HAS_REGION 0, HAS_WSTRB 1, HAS_BRESP 1, HAS_RRESP 1, SUPPORTS_NARROW_BURST 0, NUM_READ_OUTSTANDING 1, NUM_WRITE_OUTSTANDING 1, MAX_BURST_LENGTH 1, PHASE 0.000, NUM_READ_THREADS 1, NUM_WRITE_THREADS 1, RUSER_BITS_PER_BYTE 0, WUSER_BITS_PER_BYTE 0, INSERT_VIP 0" *) input [8:0]s_axi_awaddr;
  (* X_INTERFACE_INFO = "xilinx.com:interface:aximm:1.0 S_AXI AWVALID" *) input s_axi_awvalid;
  (* X_INTERFACE_INFO = "xilinx.com:interface:aximm:1.0 S_AXI AWREADY" *) output s_axi_awready;
  (* X_INTERFACE_INFO = "xilinx.com:interface:aximm:1.0 S_AXI WDATA" *) input [31:0]s_axi_wdata;
  (* X_INTERFACE_INFO = "xilinx.com:interface:aximm:1.0 S_AXI WSTRB" *) input [3:0]s_axi_wstrb;
  (* X_INTERFACE_INFO = "xilinx.com:interface:aximm:1.0 S_AXI WVALID" *) input s_axi_wvalid;
  (* X_INTERFACE_INFO = "xilinx.com:interface:aximm:1.0 S_AXI WREADY" *) output s_axi_wready;
  (* X_INTERFACE_INFO = "xilinx.com:interface:aximm:1.0 S_AXI BRESP" *) output [1:0]s_axi_bresp;
  (* X_INTERFACE_INFO = "xilinx.com:interface:aximm:1.0 S_AXI BVALID" *) output s_axi_bvalid;
  (* X_INTERFACE_INFO = "xilinx.com:interface:aximm:1.0 S_AXI BREADY" *) input s_axi_bready;
  (* X_INTERFACE_INFO = "xilinx.com:interface:aximm:1.0 S_AXI ARADDR" *) input [8:0]s_axi_araddr;
  (* X_INTERFACE_INFO = "xilinx.com:interface:aximm:1.0 S_AXI ARVALID" *) input s_axi_arvalid;
  (* X_INTERFACE_INFO = "xilinx.com:interface:aximm:1.0 S_AXI ARREADY" *) output s_axi_arready;
  (* X_INTERFACE_INFO = "xilinx.com:interface:aximm:1.0 S_AXI RDATA" *) output [31:0]s_axi_rdata;
  (* X_INTERFACE_INFO = "xilinx.com:interface:aximm:1.0 S_AXI RRESP" *) output [1:0]s_axi_rresp;
  (* X_INTERFACE_INFO = "xilinx.com:interface:aximm:1.0 S_AXI RVALID" *) output s_axi_rvalid;
  (* X_INTERFACE_INFO = "xilinx.com:interface:aximm:1.0 S_AXI RREADY" *) input s_axi_rready;
  (* X_INTERFACE_INFO = "xilinx.com:interface:gpio:1.0 GPIO TRI_I" *) (* X_INTERFACE_PARAMETER = "XIL_INTERFACENAME GPIO, BOARD.ASSOCIATED_PARAM GPIO_BOARD_INTERFACE" *) input [3:0]gpio_io_i;
  (* X_INTERFACE_INFO = "xilinx.com:interface:gpio:1.0 GPIO TRI_O" *) output [3:0]gpio_io_o;
  (* X_INTERFACE_INFO = "xilinx.com:interface:gpio:1.0 GPIO TRI_T" *) output [3:0]gpio_io_t;
  (* X_INTERFACE_INFO = "xilinx.com:interface:gpio:1.0 GPIO2 TRI_I" *) (* X_INTERFACE_PARAMETER = "XIL_INTERFACENAME GPIO2, BOARD.ASSOCIATED_PARAM GPIO2_BOARD_INTERFACE" *) input [1:0]gpio2_io_i;
  (* X_INTERFACE_INFO = "xilinx.com:interface:gpio:1.0 GPIO2 TRI_O" *) output [1:0]gpio2_io_o;
  (* X_INTERFACE_INFO = "xilinx.com:interface:gpio:1.0 GPIO2 TRI_T" *) output [1:0]gpio2_io_t;

  wire [1:0]gpio2_io_i;
  wire [1:0]gpio2_io_o;
  wire [1:0]gpio2_io_t;
  wire [3:0]gpio_io_i;
  wire [3:0]gpio_io_o;
  wire [3:0]gpio_io_t;
  wire s_axi_aclk;
  wire [8:0]s_axi_araddr;
  wire s_axi_aresetn;
  wire s_axi_arready;
  wire s_axi_arvalid;
  wire [8:0]s_axi_awaddr;
  wire s_axi_awready;
  wire s_axi_awvalid;
  wire s_axi_bready;
  wire [1:0]s_axi_bresp;
  wire s_axi_bvalid;
  wire [31:0]s_axi_rdata;
  wire s_axi_rready;
  wire [1:0]s_axi_rresp;
  wire s_axi_rvalid;
  wire [31:0]s_axi_wdata;
  wire s_axi_wready;
  wire [3:0]s_axi_wstrb;
  wire s_axi_wvalid;
  wire NLW_U0_ip2intc_irpt_UNCONNECTED;

  (* C_ALL_INPUTS = "0" *) 
  (* C_ALL_INPUTS_2 = "0" *) 
  (* C_ALL_OUTPUTS = "0" *) 
  (* C_ALL_OUTPUTS_2 = "0" *) 
  (* C_DOUT_DEFAULT = "0" *) 
  (* C_DOUT_DEFAULT_2 = "0" *) 
  (* C_FAMILY = "artix7" *) 
  (* C_GPIO2_WIDTH = "2" *) 
  (* C_GPIO_WIDTH = "4" *) 
  (* C_INTERRUPT_PRESENT = "0" *) 
  (* C_IS_DUAL = "1" *) 
  (* C_S_AXI_ADDR_WIDTH = "9" *) 
  (* C_S_AXI_DATA_WIDTH = "32" *) 
  (* C_TRI_DEFAULT = "-1" *) 
  (* C_TRI_DEFAULT_2 = "-1" *) 
  (* downgradeipidentifiedwarnings = "yes" *) 
  (* ip_group = "LOGICORE" *) 
  decalper_eb_ot_sdeen_pot_pi_dehcac_xnilix_axi_gpio U0
       (.gpio2_io_i(gpio2_io_i),
        .gpio2_io_o(gpio2_io_o),
        .gpio2_io_t(gpio2_io_t),
        .gpio_io_i(gpio_io_i),
        .gpio_io_o(gpio_io_o),
        .gpio_io_t(gpio_io_t),
        .ip2intc_irpt(NLW_U0_ip2intc_irpt_UNCONNECTED),
        .s_axi_aclk(s_axi_aclk),
        .s_axi_araddr(s_axi_araddr),
        .s_axi_aresetn(s_axi_aresetn),
        .s_axi_arready(s_axi_arready),
        .s_axi_arvalid(s_axi_arvalid),
        .s_axi_awaddr(s_axi_awaddr),
        .s_axi_awready(s_axi_awready),
        .s_axi_awvalid(s_axi_awvalid),
        .s_axi_bready(s_axi_bready),
        .s_axi_bresp(s_axi_bresp),
        .s_axi_bvalid(s_axi_bvalid),
        .s_axi_rdata(s_axi_rdata),
        .s_axi_rready(s_axi_rready),
        .s_axi_rresp(s_axi_rresp),
        .s_axi_rvalid(s_axi_rvalid),
        .s_axi_wdata(s_axi_wdata),
        .s_axi_wready(s_axi_wready),
        .s_axi_wstrb(s_axi_wstrb),
        .s_axi_wvalid(s_axi_wvalid));
endmodule

(* CHECK_LICENSE_TYPE = "PmodBLE_axi_uart16550_0_0,axi_uart16550,{}" *) (* DowngradeIPIdentifiedWarnings = "yes" *) (* X_CORE_INFO = "axi_uart16550,Vivado 2019.2" *) 
module decalper_eb_ot_sdeen_pot_pi_dehcac_xnilix_PmodBLE_axi_uart16550_0_0
   (s_axi_aclk,
    s_axi_aresetn,
    ip2intc_irpt,
    freeze,
    s_axi_awaddr,
    s_axi_awvalid,
    s_axi_awready,
    s_axi_wdata,
    s_axi_wstrb,
    s_axi_wvalid,
    s_axi_wready,
    s_axi_bresp,
    s_axi_bvalid,
    s_axi_bready,
    s_axi_araddr,
    s_axi_arvalid,
    s_axi_arready,
    s_axi_rdata,
    s_axi_rresp,
    s_axi_rvalid,
    s_axi_rready,
    baudoutn,
    ctsn,
    dcdn,
    ddis,
    dsrn,
    dtrn,
    out1n,
    out2n,
    rin,
    rtsn,
    rxrdyn,
    sin,
    sout,
    txrdyn);
  (* X_INTERFACE_INFO = "xilinx.com:signal:clock:1.0 ACLK CLK" *) (* X_INTERFACE_PARAMETER = "XIL_INTERFACENAME ACLK, ASSOCIATED_BUSIF S_AXI, ASSOCIATED_RESET s_axi_aresetn, FREQ_HZ 100000000, PHASE 0.000, INSERT_VIP 0" *) input s_axi_aclk;
  (* X_INTERFACE_INFO = "xilinx.com:signal:reset:1.0 ARESETN RST" *) (* X_INTERFACE_PARAMETER = "XIL_INTERFACENAME ARESETN, POLARITY ACTIVE_LOW, INSERT_VIP 0" *) input s_axi_aresetn;
  (* X_INTERFACE_INFO = "xilinx.com:signal:interrupt:1.0 INTERRUPT INTERRUPT" *) (* X_INTERFACE_PARAMETER = "XIL_INTERFACENAME INTERRUPT, SENSITIVITY LEVEL_HIGH, PortWidth 1" *) output ip2intc_irpt;
  input freeze;
  (* X_INTERFACE_INFO = "xilinx.com:interface:aximm:1.0 S_AXI AWADDR" *) (* X_INTERFACE_PARAMETER = "XIL_INTERFACENAME S_AXI, DATA_WIDTH 32, PROTOCOL AXI4LITE, FREQ_HZ 100000000, ID_WIDTH 0, ADDR_WIDTH 13, AWUSER_WIDTH 0, ARUSER_WIDTH 0, WUSER_WIDTH 0, RUSER_WIDTH 0, BUSER_WIDTH 0, READ_WRITE_MODE READ_WRITE, HAS_BURST 0, HAS_LOCK 0, HAS_PROT 0, HAS_CACHE 0, HAS_QOS 0, HAS_REGION 0, HAS_WSTRB 1, HAS_BRESP 1, HAS_RRESP 1, SUPPORTS_NARROW_BURST 0, NUM_READ_OUTSTANDING 1, NUM_WRITE_OUTSTANDING 1, MAX_BURST_LENGTH 1, PHASE 0.000, NUM_READ_THREADS 1, NUM_WRITE_THREADS 1, RUSER_BITS_PER_BYTE 0, WUSER_BITS_PER_BYTE 0, INSERT_VIP 0" *) input [12:0]s_axi_awaddr;
  (* X_INTERFACE_INFO = "xilinx.com:interface:aximm:1.0 S_AXI AWVALID" *) input s_axi_awvalid;
  (* X_INTERFACE_INFO = "xilinx.com:interface:aximm:1.0 S_AXI AWREADY" *) output s_axi_awready;
  (* X_INTERFACE_INFO = "xilinx.com:interface:aximm:1.0 S_AXI WDATA" *) input [31:0]s_axi_wdata;
  (* X_INTERFACE_INFO = "xilinx.com:interface:aximm:1.0 S_AXI WSTRB" *) input [3:0]s_axi_wstrb;
  (* X_INTERFACE_INFO = "xilinx.com:interface:aximm:1.0 S_AXI WVALID" *) input s_axi_wvalid;
  (* X_INTERFACE_INFO = "xilinx.com:interface:aximm:1.0 S_AXI WREADY" *) output s_axi_wready;
  (* X_INTERFACE_INFO = "xilinx.com:interface:aximm:1.0 S_AXI BRESP" *) output [1:0]s_axi_bresp;
  (* X_INTERFACE_INFO = "xilinx.com:interface:aximm:1.0 S_AXI BVALID" *) output s_axi_bvalid;
  (* X_INTERFACE_INFO = "xilinx.com:interface:aximm:1.0 S_AXI BREADY" *) input s_axi_bready;
  (* X_INTERFACE_INFO = "xilinx.com:interface:aximm:1.0 S_AXI ARADDR" *) input [12:0]s_axi_araddr;
  (* X_INTERFACE_INFO = "xilinx.com:interface:aximm:1.0 S_AXI ARVALID" *) input s_axi_arvalid;
  (* X_INTERFACE_INFO = "xilinx.com:interface:aximm:1.0 S_AXI ARREADY" *) output s_axi_arready;
  (* X_INTERFACE_INFO = "xilinx.com:interface:aximm:1.0 S_AXI RDATA" *) output [31:0]s_axi_rdata;
  (* X_INTERFACE_INFO = "xilinx.com:interface:aximm:1.0 S_AXI RRESP" *) output [1:0]s_axi_rresp;
  (* X_INTERFACE_INFO = "xilinx.com:interface:aximm:1.0 S_AXI RVALID" *) output s_axi_rvalid;
  (* X_INTERFACE_INFO = "xilinx.com:interface:aximm:1.0 S_AXI RREADY" *) input s_axi_rready;
  (* X_INTERFACE_INFO = "xilinx.com:interface:uart:1.0 UART BAUDOUTn" *) (* X_INTERFACE_PARAMETER = "XIL_INTERFACENAME UART, BOARD.ASSOCIATED_PARAM UART_BOARD_INTERFACE" *) output baudoutn;
  (* X_INTERFACE_INFO = "xilinx.com:interface:uart:1.0 UART CTSn" *) input ctsn;
  (* X_INTERFACE_INFO = "xilinx.com:interface:uart:1.0 UART DCDn" *) input dcdn;
  (* X_INTERFACE_INFO = "xilinx.com:interface:uart:1.0 UART DDIS" *) output ddis;
  (* X_INTERFACE_INFO = "xilinx.com:interface:uart:1.0 UART DSRn" *) input dsrn;
  (* X_INTERFACE_INFO = "xilinx.com:interface:uart:1.0 UART DTRn" *) output dtrn;
  (* X_INTERFACE_INFO = "xilinx.com:interface:uart:1.0 UART OUT1n" *) output out1n;
  (* X_INTERFACE_INFO = "xilinx.com:interface:uart:1.0 UART OUT2n" *) output out2n;
  (* X_INTERFACE_INFO = "xilinx.com:interface:uart:1.0 UART RI" *) input rin;
  (* X_INTERFACE_INFO = "xilinx.com:interface:uart:1.0 UART RTSn" *) output rtsn;
  (* X_INTERFACE_INFO = "xilinx.com:interface:uart:1.0 UART RXRDYn" *) output rxrdyn;
  (* X_INTERFACE_INFO = "xilinx.com:interface:uart:1.0 UART RxD" *) input sin;
  (* X_INTERFACE_INFO = "xilinx.com:interface:uart:1.0 UART TxD" *) output sout;
  (* X_INTERFACE_INFO = "xilinx.com:interface:uart:1.0 UART TXRDYn" *) output txrdyn;

  wire baudoutn;
  wire ctsn;
  wire dcdn;
  wire ddis;
  wire dsrn;
  wire dtrn;
  wire freeze;
  wire ip2intc_irpt;
  wire out1n;
  wire out2n;
  wire rin;
  wire rtsn;
  wire rxrdyn;
  wire s_axi_aclk;
  wire [12:0]s_axi_araddr;
  wire s_axi_aresetn;
  wire s_axi_arready;
  wire s_axi_arvalid;
  wire [12:0]s_axi_awaddr;
  wire s_axi_awready;
  wire s_axi_awvalid;
  wire s_axi_bready;
  wire [1:0]s_axi_bresp;
  wire s_axi_bvalid;
  wire [31:0]s_axi_rdata;
  wire s_axi_rready;
  wire [1:0]s_axi_rresp;
  wire s_axi_rvalid;
  wire [31:0]s_axi_wdata;
  wire s_axi_wready;
  wire [3:0]s_axi_wstrb;
  wire s_axi_wvalid;
  wire sin;
  wire sout;
  wire txrdyn;
  wire NLW_U0_xout_UNCONNECTED;

  (* C_EXTERNAL_XIN_CLK_HZ = "25000000" *) 
  (* C_FAMILY = "artix7" *) 
  (* C_HAS_EXTERNAL_RCLK = "0" *) 
  (* C_HAS_EXTERNAL_XIN = "0" *) 
  (* C_IS_A_16550 = "1" *) 
  (* C_SIM_DEVICE = "VERSAL_AI_CORE_ES1" *) 
  (* C_S_AXI_ACLK_FREQ_HZ = "100000000" *) 
  (* C_S_AXI_ADDR_WIDTH = "13" *) 
  (* C_S_AXI_DATA_WIDTH = "32" *) 
  (* downgradeipidentifiedwarnings = "yes" *) 
  decalper_eb_ot_sdeen_pot_pi_dehcac_xnilix_axi_uart16550 U0
       (.baudoutn(baudoutn),
        .ctsn(ctsn),
        .dcdn(dcdn),
        .ddis(ddis),
        .dsrn(dsrn),
        .dtrn(dtrn),
        .freeze(freeze),
        .ip2intc_irpt(ip2intc_irpt),
        .out1n(out1n),
        .out2n(out2n),
        .rclk(1'b0),
        .rin(rin),
        .rtsn(rtsn),
        .rxrdyn(rxrdyn),
        .s_axi_aclk(s_axi_aclk),
        .s_axi_araddr(s_axi_araddr),
        .s_axi_aresetn(s_axi_aresetn),
        .s_axi_arready(s_axi_arready),
        .s_axi_arvalid(s_axi_arvalid),
        .s_axi_awaddr(s_axi_awaddr),
        .s_axi_awready(s_axi_awready),
        .s_axi_awvalid(s_axi_awvalid),
        .s_axi_bready(s_axi_bready),
        .s_axi_bresp(s_axi_bresp),
        .s_axi_bvalid(s_axi_bvalid),
        .s_axi_rdata(s_axi_rdata),
        .s_axi_rready(s_axi_rready),
        .s_axi_rresp(s_axi_rresp),
        .s_axi_rvalid(s_axi_rvalid),
        .s_axi_wdata(s_axi_wdata),
        .s_axi_wready(s_axi_wready),
        .s_axi_wstrb(s_axi_wstrb),
        .s_axi_wvalid(s_axi_wvalid),
        .sin(sin),
        .sout(sout),
        .txrdyn(txrdyn),
        .xin(1'b0),
        .xout(NLW_U0_xout_UNCONNECTED));
endmodule

(* CHECK_LICENSE_TYPE = "PmodBLE_pmod_bridge_0_0,pmod_concat,{}" *) (* DowngradeIPIdentifiedWarnings = "yes" *) (* X_CORE_INFO = "pmod_concat,Vivado 2019.2" *) 
module decalper_eb_ot_sdeen_pot_pi_dehcac_xnilix_PmodBLE_pmod_bridge_0_0
   (in_top_uart_gpio_bus_I,
    in_top_uart_gpio_bus_O,
    in_top_uart_gpio_bus_T,
    in_bottom_bus_I,
    in_bottom_bus_O,
    in_bottom_bus_T,
    in2_I,
    in1_O,
    out0_I,
    out1_I,
    out2_I,
    out3_I,
    out4_I,
    out5_I,
    out6_I,
    out7_I,
    out0_O,
    out1_O,
    out2_O,
    out3_O,
    out4_O,
    out5_O,
    out6_O,
    out7_O,
    out0_T,
    out1_T,
    out2_T,
    out3_T,
    out4_T,
    out5_T,
    out6_T,
    out7_T);
  (* X_INTERFACE_INFO = "xilinx.com:interface:gpio:1.0 UART_GPIO_Top_Row TRI_I" *) output [1:0]in_top_uart_gpio_bus_I;
  (* X_INTERFACE_INFO = "xilinx.com:interface:gpio:1.0 UART_GPIO_Top_Row TRI_O" *) input [1:0]in_top_uart_gpio_bus_O;
  (* X_INTERFACE_INFO = "xilinx.com:interface:gpio:1.0 UART_GPIO_Top_Row TRI_T" *) input [1:0]in_top_uart_gpio_bus_T;
  (* X_INTERFACE_INFO = "xilinx.com:interface:gpio:1.0 GPIO_Bottom_Row TRI_I" *) output [3:0]in_bottom_bus_I;
  (* X_INTERFACE_INFO = "xilinx.com:interface:gpio:1.0 GPIO_Bottom_Row TRI_O" *) input [3:0]in_bottom_bus_O;
  (* X_INTERFACE_INFO = "xilinx.com:interface:gpio:1.0 GPIO_Bottom_Row TRI_T" *) input [3:0]in_bottom_bus_T;
  (* X_INTERFACE_INFO = "xilinx.com:interface:uart:1.0 UART_Top_Row RxD" *) output in2_I;
  (* X_INTERFACE_INFO = "xilinx.com:interface:uart:1.0 UART_Top_Row TxD" *) input in1_O;
  (* X_INTERFACE_INFO = "digilentinc.com:interface:pmod:1.0 Pmod_out PIN1_I" *) input out0_I;
  (* X_INTERFACE_INFO = "digilentinc.com:interface:pmod:1.0 Pmod_out PIN2_I" *) input out1_I;
  (* X_INTERFACE_INFO = "digilentinc.com:interface:pmod:1.0 Pmod_out PIN3_I" *) input out2_I;
  (* X_INTERFACE_INFO = "digilentinc.com:interface:pmod:1.0 Pmod_out PIN4_I" *) input out3_I;
  (* X_INTERFACE_INFO = "digilentinc.com:interface:pmod:1.0 Pmod_out PIN7_I" *) input out4_I;
  (* X_INTERFACE_INFO = "digilentinc.com:interface:pmod:1.0 Pmod_out PIN8_I" *) input out5_I;
  (* X_INTERFACE_INFO = "digilentinc.com:interface:pmod:1.0 Pmod_out PIN9_I" *) input out6_I;
  (* X_INTERFACE_INFO = "digilentinc.com:interface:pmod:1.0 Pmod_out PIN10_I" *) input out7_I;
  (* X_INTERFACE_INFO = "digilentinc.com:interface:pmod:1.0 Pmod_out PIN1_O" *) output out0_O;
  (* X_INTERFACE_INFO = "digilentinc.com:interface:pmod:1.0 Pmod_out PIN2_O" *) output out1_O;
  (* X_INTERFACE_INFO = "digilentinc.com:interface:pmod:1.0 Pmod_out PIN3_O" *) output out2_O;
  (* X_INTERFACE_INFO = "digilentinc.com:interface:pmod:1.0 Pmod_out PIN4_O" *) output out3_O;
  (* X_INTERFACE_INFO = "digilentinc.com:interface:pmod:1.0 Pmod_out PIN7_O" *) output out4_O;
  (* X_INTERFACE_INFO = "digilentinc.com:interface:pmod:1.0 Pmod_out PIN8_O" *) output out5_O;
  (* X_INTERFACE_INFO = "digilentinc.com:interface:pmod:1.0 Pmod_out PIN9_O" *) output out6_O;
  (* X_INTERFACE_INFO = "digilentinc.com:interface:pmod:1.0 Pmod_out PIN10_O" *) output out7_O;
  (* X_INTERFACE_INFO = "digilentinc.com:interface:pmod:1.0 Pmod_out PIN1_T" *) output out0_T;
  (* X_INTERFACE_INFO = "digilentinc.com:interface:pmod:1.0 Pmod_out PIN2_T" *) output out1_T;
  (* X_INTERFACE_INFO = "digilentinc.com:interface:pmod:1.0 Pmod_out PIN3_T" *) output out2_T;
  (* X_INTERFACE_INFO = "digilentinc.com:interface:pmod:1.0 Pmod_out PIN4_T" *) output out3_T;
  (* X_INTERFACE_INFO = "digilentinc.com:interface:pmod:1.0 Pmod_out PIN7_T" *) output out4_T;
  (* X_INTERFACE_INFO = "digilentinc.com:interface:pmod:1.0 Pmod_out PIN8_T" *) output out5_T;
  (* X_INTERFACE_INFO = "digilentinc.com:interface:pmod:1.0 Pmod_out PIN9_T" *) output out6_T;
  (* X_INTERFACE_INFO = "digilentinc.com:interface:pmod:1.0 Pmod_out PIN10_T" *) (* X_INTERFACE_PARAMETER = "XIL_INTERFACENAME Pmod_out, BOARD.ASSOCIATED_PARAM PMOD" *) output out7_T;

  wire in1_O;
  wire in2_I;
  wire [3:0]in_bottom_bus_I;
  wire [3:0]in_bottom_bus_O;
  wire [3:0]in_bottom_bus_T;
  wire [1:0]in_top_uart_gpio_bus_I;
  wire [1:0]in_top_uart_gpio_bus_O;
  wire [1:0]in_top_uart_gpio_bus_T;
  wire out0_I;
  wire out0_O;
  wire out0_T;
  wire out1_I;
  wire out1_O;
  wire out1_T;
  wire out2_I;
  wire out2_O;
  wire out2_T;
  wire out3_I;
  wire out3_O;
  wire out3_T;
  wire out4_I;
  wire out4_O;
  wire out4_T;
  wire out5_I;
  wire out5_O;
  wire out5_T;
  wire out6_I;
  wire out6_O;
  wire out6_T;
  wire out7_I;
  wire out7_O;
  wire out7_T;
  wire NLW_inst_in0_I_UNCONNECTED;
  wire NLW_inst_in1_I_UNCONNECTED;
  wire NLW_inst_in3_I_UNCONNECTED;
  wire NLW_inst_in4_I_UNCONNECTED;
  wire NLW_inst_in5_I_UNCONNECTED;
  wire NLW_inst_in6_I_UNCONNECTED;
  wire NLW_inst_in7_I_UNCONNECTED;
  wire [1:0]NLW_inst_in_bottom_i2c_gpio_bus_I_UNCONNECTED;
  wire [1:0]NLW_inst_in_bottom_uart_gpio_bus_I_UNCONNECTED;
  wire [3:0]NLW_inst_in_top_bus_I_UNCONNECTED;
  wire [1:0]NLW_inst_in_top_i2c_gpio_bus_I_UNCONNECTED;

  (* Bottom_Row_Interface = "GPIO" *) 
  (* Top_Row_Interface = "UART" *) 
  decalper_eb_ot_sdeen_pot_pi_dehcac_xnilix_pmod_concat inst
       (.in0_I(NLW_inst_in0_I_UNCONNECTED),
        .in0_O(1'b1),
        .in0_T(1'b1),
        .in1_I(NLW_inst_in1_I_UNCONNECTED),
        .in1_O(in1_O),
        .in1_T(1'b1),
        .in2_I(in2_I),
        .in2_O(1'b1),
        .in2_T(1'b1),
        .in3_I(NLW_inst_in3_I_UNCONNECTED),
        .in3_O(1'b1),
        .in3_T(1'b1),
        .in4_I(NLW_inst_in4_I_UNCONNECTED),
        .in4_O(1'b1),
        .in4_T(1'b1),
        .in5_I(NLW_inst_in5_I_UNCONNECTED),
        .in5_O(1'b1),
        .in5_T(1'b1),
        .in6_I(NLW_inst_in6_I_UNCONNECTED),
        .in6_O(1'b1),
        .in6_T(1'b1),
        .in7_I(NLW_inst_in7_I_UNCONNECTED),
        .in7_O(1'b1),
        .in7_T(1'b1),
        .in_bottom_bus_I(in_bottom_bus_I),
        .in_bottom_bus_O(in_bottom_bus_O),
        .in_bottom_bus_T(in_bottom_bus_T),
        .in_bottom_i2c_gpio_bus_I(NLW_inst_in_bottom_i2c_gpio_bus_I_UNCONNECTED[1:0]),
        .in_bottom_i2c_gpio_bus_O({1'b0,1'b1}),
        .in_bottom_i2c_gpio_bus_T({1'b0,1'b1}),
        .in_bottom_uart_gpio_bus_I(NLW_inst_in_bottom_uart_gpio_bus_I_UNCONNECTED[1:0]),
        .in_bottom_uart_gpio_bus_O({1'b0,1'b1}),
        .in_bottom_uart_gpio_bus_T({1'b0,1'b1}),
        .in_top_bus_I(NLW_inst_in_top_bus_I_UNCONNECTED[3:0]),
        .in_top_bus_O({1'b0,1'b0,1'b0,1'b0}),
        .in_top_bus_T({1'b0,1'b0,1'b0,1'b0}),
        .in_top_i2c_gpio_bus_I(NLW_inst_in_top_i2c_gpio_bus_I_UNCONNECTED[1:0]),
        .in_top_i2c_gpio_bus_O({1'b0,1'b1}),
        .in_top_i2c_gpio_bus_T({1'b0,1'b1}),
        .in_top_uart_gpio_bus_I(in_top_uart_gpio_bus_I),
        .in_top_uart_gpio_bus_O(in_top_uart_gpio_bus_O),
        .in_top_uart_gpio_bus_T(in_top_uart_gpio_bus_T),
        .out0_I(out0_I),
        .out0_O(out0_O),
        .out0_T(out0_T),
        .out1_I(out1_I),
        .out1_O(out1_O),
        .out1_T(out1_T),
        .out2_I(out2_I),
        .out2_O(out2_O),
        .out2_T(out2_T),
        .out3_I(out3_I),
        .out3_O(out3_O),
        .out3_T(out3_T),
        .out4_I(out4_I),
        .out4_O(out4_O),
        .out4_T(out4_T),
        .out5_I(out5_I),
        .out5_O(out5_O),
        .out5_T(out5_T),
        .out6_I(out6_I),
        .out6_O(out6_O),
        .out6_T(out6_T),
        .out7_I(out7_I),
        .out7_O(out7_O),
        .out7_T(out7_T));
endmodule

module decalper_eb_ot_sdeen_pot_pi_dehcac_xnilix_address_decoder
   (\GEN_BKEND_CE_REGISTERS[3].ce_out_i_reg ,
    \GEN_BKEND_CE_REGISTERS[2].ce_out_i_reg ,
    \GEN_BKEND_CE_REGISTERS[1].ce_out_i_reg[1]_0 ,
    \GEN_BKEND_CE_REGISTERS[0].ce_out_i_reg[0]_0 ,
    Bus_RNW_reg_reg_0,
    \MEM_DECODE_GEN[0].cs_out_i_reg[0]_0 ,
    \bus2ip_addr_i_reg[8] ,
    p_1_in2_in,
    rst_reg,
    p_0_in3_in,
    gpio_reg_en,
    D,
    E,
    bus2ip_rnw_i_reg,
    ip2bus_rdack_i_D1_reg,
    ip2bus_wrack_i_D1_reg,
    bus2ip_rnw_i_reg_0,
    \Dual.ALLOUT0_ND_G0.READ_REG_GEN[0].reg1_reg[28] ,
    Q,
    s_axi_aclk,
    \Dual.gpio_Data_Out_reg[0] ,
    SR,
    \Dual.ALLOUT0_ND_G2.READ_REG2_GEN[0].reg4_reg[30] ,
    s_axi_wdata,
    s_axi_aresetn,
    GPIO_xferAck_i,
    gpio_xferAck_Reg,
    ip2bus_rdack_i_D1,
    S_AXI_GPIO_arready,
    S_AXI_GPIO_arready_0,
    ip2bus_wrack_i_D1,
    S_AXI_GPIO_wready,
    reg2,
    reg1,
    reg3,
    \ip2bus_data_i_D1_reg[29] ,
    reg4);
  output \GEN_BKEND_CE_REGISTERS[3].ce_out_i_reg ;
  output \GEN_BKEND_CE_REGISTERS[2].ce_out_i_reg ;
  output \GEN_BKEND_CE_REGISTERS[1].ce_out_i_reg[1]_0 ;
  output \GEN_BKEND_CE_REGISTERS[0].ce_out_i_reg[0]_0 ;
  output Bus_RNW_reg_reg_0;
  output \MEM_DECODE_GEN[0].cs_out_i_reg[0]_0 ;
  output \bus2ip_addr_i_reg[8] ;
  output p_1_in2_in;
  output rst_reg;
  output p_0_in3_in;
  output gpio_reg_en;
  output [3:0]D;
  output [0:0]E;
  output [0:0]bus2ip_rnw_i_reg;
  output ip2bus_rdack_i_D1_reg;
  output ip2bus_wrack_i_D1_reg;
  output bus2ip_rnw_i_reg_0;
  output [3:0]\Dual.ALLOUT0_ND_G0.READ_REG_GEN[0].reg1_reg[28] ;
  input Q;
  input s_axi_aclk;
  input [2:0]\Dual.gpio_Data_Out_reg[0] ;
  input [0:0]SR;
  input \Dual.ALLOUT0_ND_G2.READ_REG2_GEN[0].reg4_reg[30] ;
  input [3:0]s_axi_wdata;
  input s_axi_aresetn;
  input GPIO_xferAck_i;
  input gpio_xferAck_Reg;
  input ip2bus_rdack_i_D1;
  input S_AXI_GPIO_arready;
  input [3:0]S_AXI_GPIO_arready_0;
  input ip2bus_wrack_i_D1;
  input S_AXI_GPIO_wready;
  input [3:0]reg2;
  input [3:0]reg1;
  input [1:0]reg3;
  input \ip2bus_data_i_D1_reg[29] ;
  input [1:0]reg4;

  wire Bus_RNW_reg_i_1_n_0;
  wire Bus_RNW_reg_reg_0;
  wire [3:0]D;
  wire [3:0]\Dual.ALLOUT0_ND_G0.READ_REG_GEN[0].reg1_reg[28] ;
  wire \Dual.ALLOUT0_ND_G2.READ_REG2_GEN[0].reg4_reg[30] ;
  wire [2:0]\Dual.gpio_Data_Out_reg[0] ;
  wire [0:0]E;
  wire \GEN_BKEND_CE_REGISTERS[0].ce_out_i_reg[0]_0 ;
  wire \GEN_BKEND_CE_REGISTERS[1].ce_out_i_reg[1]_0 ;
  wire \GEN_BKEND_CE_REGISTERS[2].ce_out_i_reg ;
  wire \GEN_BKEND_CE_REGISTERS[3].ce_out_i_reg ;
  wire GPIO_xferAck_i;
  wire \MEM_DECODE_GEN[0].cs_out_i[0]_i_1_n_0 ;
  wire \MEM_DECODE_GEN[0].cs_out_i_reg[0]_0 ;
  wire Q;
  wire [0:0]SR;
  wire S_AXI_GPIO_arready;
  wire [3:0]S_AXI_GPIO_arready_0;
  wire S_AXI_GPIO_wready;
  wire \bus2ip_addr_i_reg[8] ;
  wire [0:0]bus2ip_rnw_i_reg;
  wire bus2ip_rnw_i_reg_0;
  wire ce_expnd_i_0;
  wire ce_expnd_i_1;
  wire ce_expnd_i_2;
  wire ce_expnd_i_3;
  wire cs_ce_clr;
  wire gpio_reg_en;
  wire gpio_xferAck_Reg;
  wire \ip2bus_data_i_D1[30]_i_2_n_0 ;
  wire \ip2bus_data_i_D1[30]_i_3_n_0 ;
  wire \ip2bus_data_i_D1[31]_i_2_n_0 ;
  wire \ip2bus_data_i_D1_reg[29] ;
  wire ip2bus_rdack_i_D1;
  wire ip2bus_rdack_i_D1_reg;
  wire ip2bus_wrack_i_D1;
  wire ip2bus_wrack_i_D1_reg;
  wire p_0_in3_in;
  wire p_1_in2_in;
  wire [3:0]reg1;
  wire [3:0]reg2;
  wire [1:0]reg3;
  wire [1:0]reg4;
  wire rst_reg;
  wire s_axi_aclk;
  wire s_axi_aresetn;
  wire [3:0]s_axi_wdata;

  (* SOFT_HLUTNM = "soft_lutpair5" *) 
  LUT3 #(
    .INIT(8'hB8)) 
    Bus_RNW_reg_i_1
       (.I0(\Dual.ALLOUT0_ND_G2.READ_REG2_GEN[0].reg4_reg[30] ),
        .I1(Q),
        .I2(Bus_RNW_reg_reg_0),
        .O(Bus_RNW_reg_i_1_n_0));
  FDRE Bus_RNW_reg_reg
       (.C(s_axi_aclk),
        .CE(1'b1),
        .D(Bus_RNW_reg_i_1_n_0),
        .Q(Bus_RNW_reg_reg_0),
        .R(1'b0));
  LUT4 #(
    .INIT(16'hFDFF)) 
    \Dual.ALLOUT0_ND_G0.READ_REG_GEN[3].reg1[31]_i_1 
       (.I0(\Dual.ALLOUT0_ND_G2.READ_REG2_GEN[0].reg4_reg[30] ),
        .I1(GPIO_xferAck_i),
        .I2(gpio_xferAck_Reg),
        .I3(\MEM_DECODE_GEN[0].cs_out_i_reg[0]_0 ),
        .O(bus2ip_rnw_i_reg_0));
  (* SOFT_HLUTNM = "soft_lutpair1" *) 
  LUT4 #(
    .INIT(16'h0400)) 
    \Dual.ALLOUT0_ND_G0.READ_REG_GEN[3].reg1[31]_i_3 
       (.I0(\Dual.gpio_Data_Out_reg[0] [2]),
        .I1(\MEM_DECODE_GEN[0].cs_out_i_reg[0]_0 ),
        .I2(\Dual.gpio_Data_Out_reg[0] [1]),
        .I3(\Dual.gpio_Data_Out_reg[0] [0]),
        .O(p_1_in2_in));
  (* SOFT_HLUTNM = "soft_lutpair1" *) 
  LUT4 #(
    .INIT(16'h0004)) 
    \Dual.ALLOUT0_ND_G0.READ_REG_GEN[3].reg1[31]_i_4 
       (.I0(\Dual.gpio_Data_Out_reg[0] [2]),
        .I1(\MEM_DECODE_GEN[0].cs_out_i_reg[0]_0 ),
        .I2(\Dual.gpio_Data_Out_reg[0] [1]),
        .I3(\Dual.gpio_Data_Out_reg[0] [0]),
        .O(p_0_in3_in));
  (* SOFT_HLUTNM = "soft_lutpair2" *) 
  LUT2 #(
    .INIT(4'h2)) 
    \Dual.ALLOUT0_ND_G2.READ_REG2_GEN[1].reg3[31]_i_2 
       (.I0(\MEM_DECODE_GEN[0].cs_out_i_reg[0]_0 ),
        .I1(\Dual.gpio_Data_Out_reg[0] [2]),
        .O(gpio_reg_en));
  LUT6 #(
    .INIT(64'hAAAAABAAAAAAAAAA)) 
    \Dual.gpio2_Data_Out[0]_i_2 
       (.I0(SR),
        .I1(\Dual.ALLOUT0_ND_G2.READ_REG2_GEN[0].reg4_reg[30] ),
        .I2(\Dual.gpio_Data_Out_reg[0] [2]),
        .I3(\MEM_DECODE_GEN[0].cs_out_i_reg[0]_0 ),
        .I4(\Dual.gpio_Data_Out_reg[0] [0]),
        .I5(\Dual.gpio_Data_Out_reg[0] [1]),
        .O(rst_reg));
  (* SOFT_HLUTNM = "soft_lutpair2" *) 
  LUT4 #(
    .INIT(16'h4000)) 
    \Dual.gpio2_OE[0]_i_2 
       (.I0(\Dual.gpio_Data_Out_reg[0] [2]),
        .I1(\MEM_DECODE_GEN[0].cs_out_i_reg[0]_0 ),
        .I2(\Dual.gpio_Data_Out_reg[0] [1]),
        .I3(\Dual.gpio_Data_Out_reg[0] [0]),
        .O(\bus2ip_addr_i_reg[8] ));
  (* SOFT_HLUTNM = "soft_lutpair0" *) 
  LUT5 #(
    .INIT(32'h00000010)) 
    \Dual.gpio_Data_Out[0]_i_1 
       (.I0(\Dual.ALLOUT0_ND_G2.READ_REG2_GEN[0].reg4_reg[30] ),
        .I1(\Dual.gpio_Data_Out_reg[0] [2]),
        .I2(\MEM_DECODE_GEN[0].cs_out_i_reg[0]_0 ),
        .I3(\Dual.gpio_Data_Out_reg[0] [1]),
        .I4(\Dual.gpio_Data_Out_reg[0] [0]),
        .O(E));
  (* SOFT_HLUTNM = "soft_lutpair3" *) 
  LUT4 #(
    .INIT(16'hFB08)) 
    \Dual.gpio_Data_Out[0]_i_2 
       (.I0(s_axi_wdata[3]),
        .I1(\MEM_DECODE_GEN[0].cs_out_i_reg[0]_0 ),
        .I2(\Dual.gpio_Data_Out_reg[0] [1]),
        .I3(s_axi_wdata[1]),
        .O(D[3]));
  (* SOFT_HLUTNM = "soft_lutpair4" *) 
  LUT4 #(
    .INIT(16'hFB08)) 
    \Dual.gpio_Data_Out[1]_i_1 
       (.I0(s_axi_wdata[2]),
        .I1(\MEM_DECODE_GEN[0].cs_out_i_reg[0]_0 ),
        .I2(\Dual.gpio_Data_Out_reg[0] [1]),
        .I3(s_axi_wdata[0]),
        .O(D[2]));
  (* SOFT_HLUTNM = "soft_lutpair3" *) 
  LUT3 #(
    .INIT(8'h40)) 
    \Dual.gpio_Data_Out[2]_i_1 
       (.I0(\Dual.gpio_Data_Out_reg[0] [1]),
        .I1(\MEM_DECODE_GEN[0].cs_out_i_reg[0]_0 ),
        .I2(s_axi_wdata[1]),
        .O(D[1]));
  (* SOFT_HLUTNM = "soft_lutpair4" *) 
  LUT3 #(
    .INIT(8'h40)) 
    \Dual.gpio_Data_Out[3]_i_1 
       (.I0(\Dual.gpio_Data_Out_reg[0] [1]),
        .I1(\MEM_DECODE_GEN[0].cs_out_i_reg[0]_0 ),
        .I2(s_axi_wdata[0]),
        .O(D[0]));
  (* SOFT_HLUTNM = "soft_lutpair0" *) 
  LUT5 #(
    .INIT(32'h00100000)) 
    \Dual.gpio_OE[0]_i_1 
       (.I0(\Dual.ALLOUT0_ND_G2.READ_REG2_GEN[0].reg4_reg[30] ),
        .I1(\Dual.gpio_Data_Out_reg[0] [2]),
        .I2(\MEM_DECODE_GEN[0].cs_out_i_reg[0]_0 ),
        .I3(\Dual.gpio_Data_Out_reg[0] [1]),
        .I4(\Dual.gpio_Data_Out_reg[0] [0]),
        .O(bus2ip_rnw_i_reg));
  (* SOFT_HLUTNM = "soft_lutpair7" *) 
  LUT2 #(
    .INIT(4'h1)) 
    \GEN_BKEND_CE_REGISTERS[0].ce_out_i[0]_i_1 
       (.I0(\Dual.gpio_Data_Out_reg[0] [0]),
        .I1(\Dual.gpio_Data_Out_reg[0] [1]),
        .O(ce_expnd_i_3));
  FDRE \GEN_BKEND_CE_REGISTERS[0].ce_out_i_reg[0] 
       (.C(s_axi_aclk),
        .CE(Q),
        .D(ce_expnd_i_3),
        .Q(\GEN_BKEND_CE_REGISTERS[0].ce_out_i_reg[0]_0 ),
        .R(cs_ce_clr));
  (* SOFT_HLUTNM = "soft_lutpair7" *) 
  LUT2 #(
    .INIT(4'h2)) 
    \GEN_BKEND_CE_REGISTERS[1].ce_out_i[1]_i_1 
       (.I0(\Dual.gpio_Data_Out_reg[0] [0]),
        .I1(\Dual.gpio_Data_Out_reg[0] [1]),
        .O(ce_expnd_i_2));
  FDRE \GEN_BKEND_CE_REGISTERS[1].ce_out_i_reg[1] 
       (.C(s_axi_aclk),
        .CE(Q),
        .D(ce_expnd_i_2),
        .Q(\GEN_BKEND_CE_REGISTERS[1].ce_out_i_reg[1]_0 ),
        .R(cs_ce_clr));
  (* SOFT_HLUTNM = "soft_lutpair6" *) 
  LUT2 #(
    .INIT(4'h2)) 
    \GEN_BKEND_CE_REGISTERS[2].ce_out_i[2]_i_1 
       (.I0(\Dual.gpio_Data_Out_reg[0] [1]),
        .I1(\Dual.gpio_Data_Out_reg[0] [0]),
        .O(ce_expnd_i_1));
  FDRE \GEN_BKEND_CE_REGISTERS[2].ce_out_i_reg[2] 
       (.C(s_axi_aclk),
        .CE(Q),
        .D(ce_expnd_i_1),
        .Q(\GEN_BKEND_CE_REGISTERS[2].ce_out_i_reg ),
        .R(cs_ce_clr));
  LUT3 #(
    .INIT(8'hEF)) 
    \GEN_BKEND_CE_REGISTERS[3].ce_out_i[3]_i_1 
       (.I0(ip2bus_wrack_i_D1_reg),
        .I1(ip2bus_rdack_i_D1_reg),
        .I2(s_axi_aresetn),
        .O(cs_ce_clr));
  (* SOFT_HLUTNM = "soft_lutpair6" *) 
  LUT2 #(
    .INIT(4'h8)) 
    \GEN_BKEND_CE_REGISTERS[3].ce_out_i[3]_i_2 
       (.I0(\Dual.gpio_Data_Out_reg[0] [1]),
        .I1(\Dual.gpio_Data_Out_reg[0] [0]),
        .O(ce_expnd_i_0));
  FDRE \GEN_BKEND_CE_REGISTERS[3].ce_out_i_reg[3] 
       (.C(s_axi_aclk),
        .CE(Q),
        .D(ce_expnd_i_0),
        .Q(\GEN_BKEND_CE_REGISTERS[3].ce_out_i_reg ),
        .R(cs_ce_clr));
  LUT5 #(
    .INIT(32'h000000E0)) 
    \MEM_DECODE_GEN[0].cs_out_i[0]_i_1 
       (.I0(\MEM_DECODE_GEN[0].cs_out_i_reg[0]_0 ),
        .I1(Q),
        .I2(s_axi_aresetn),
        .I3(ip2bus_rdack_i_D1_reg),
        .I4(ip2bus_wrack_i_D1_reg),
        .O(\MEM_DECODE_GEN[0].cs_out_i[0]_i_1_n_0 ));
  FDRE \MEM_DECODE_GEN[0].cs_out_i_reg[0] 
       (.C(s_axi_aclk),
        .CE(1'b1),
        .D(\MEM_DECODE_GEN[0].cs_out_i[0]_i_1_n_0 ),
        .Q(\MEM_DECODE_GEN[0].cs_out_i_reg[0]_0 ),
        .R(1'b0));
  LUT6 #(
    .INIT(64'hF800000088000000)) 
    \ip2bus_data_i_D1[28]_i_1 
       (.I0(reg1[3]),
        .I1(\GEN_BKEND_CE_REGISTERS[0].ce_out_i_reg[0]_0 ),
        .I2(reg2[3]),
        .I3(\ip2bus_data_i_D1_reg[29] ),
        .I4(Bus_RNW_reg_reg_0),
        .I5(\GEN_BKEND_CE_REGISTERS[1].ce_out_i_reg[1]_0 ),
        .O(\Dual.ALLOUT0_ND_G0.READ_REG_GEN[0].reg1_reg[28] [3]));
  LUT6 #(
    .INIT(64'hF800000088000000)) 
    \ip2bus_data_i_D1[29]_i_1 
       (.I0(reg1[2]),
        .I1(\GEN_BKEND_CE_REGISTERS[0].ce_out_i_reg[0]_0 ),
        .I2(reg2[2]),
        .I3(\ip2bus_data_i_D1_reg[29] ),
        .I4(Bus_RNW_reg_reg_0),
        .I5(\GEN_BKEND_CE_REGISTERS[1].ce_out_i_reg[1]_0 ),
        .O(\Dual.ALLOUT0_ND_G0.READ_REG_GEN[0].reg1_reg[28] [2]));
  LUT6 #(
    .INIT(64'hFFEAAAAAEAEAAAAA)) 
    \ip2bus_data_i_D1[30]_i_1 
       (.I0(\ip2bus_data_i_D1[30]_i_2_n_0 ),
        .I1(\GEN_BKEND_CE_REGISTERS[1].ce_out_i_reg[1]_0 ),
        .I2(reg2[1]),
        .I3(reg1[1]),
        .I4(\ip2bus_data_i_D1[30]_i_3_n_0 ),
        .I5(\GEN_BKEND_CE_REGISTERS[0].ce_out_i_reg[0]_0 ),
        .O(\Dual.ALLOUT0_ND_G0.READ_REG_GEN[0].reg1_reg[28] [1]));
  LUT6 #(
    .INIT(64'hF000800080008000)) 
    \ip2bus_data_i_D1[30]_i_2 
       (.I0(\GEN_BKEND_CE_REGISTERS[2].ce_out_i_reg ),
        .I1(reg3[1]),
        .I2(Bus_RNW_reg_reg_0),
        .I3(\ip2bus_data_i_D1_reg[29] ),
        .I4(\GEN_BKEND_CE_REGISTERS[3].ce_out_i_reg ),
        .I5(reg4[1]),
        .O(\ip2bus_data_i_D1[30]_i_2_n_0 ));
  (* SOFT_HLUTNM = "soft_lutpair5" *) 
  LUT2 #(
    .INIT(4'h8)) 
    \ip2bus_data_i_D1[30]_i_3 
       (.I0(Bus_RNW_reg_reg_0),
        .I1(\ip2bus_data_i_D1_reg[29] ),
        .O(\ip2bus_data_i_D1[30]_i_3_n_0 ));
  LUT6 #(
    .INIT(64'hFFEAAAAAEAEAAAAA)) 
    \ip2bus_data_i_D1[31]_i_1 
       (.I0(\ip2bus_data_i_D1[31]_i_2_n_0 ),
        .I1(\GEN_BKEND_CE_REGISTERS[1].ce_out_i_reg[1]_0 ),
        .I2(reg2[0]),
        .I3(reg1[0]),
        .I4(\ip2bus_data_i_D1[30]_i_3_n_0 ),
        .I5(\GEN_BKEND_CE_REGISTERS[0].ce_out_i_reg[0]_0 ),
        .O(\Dual.ALLOUT0_ND_G0.READ_REG_GEN[0].reg1_reg[28] [0]));
  LUT6 #(
    .INIT(64'hF000800080008000)) 
    \ip2bus_data_i_D1[31]_i_2 
       (.I0(\GEN_BKEND_CE_REGISTERS[2].ce_out_i_reg ),
        .I1(reg3[0]),
        .I2(Bus_RNW_reg_reg_0),
        .I3(\ip2bus_data_i_D1_reg[29] ),
        .I4(\GEN_BKEND_CE_REGISTERS[3].ce_out_i_reg ),
        .I5(reg4[0]),
        .O(\ip2bus_data_i_D1[31]_i_2_n_0 ));
  LUT6 #(
    .INIT(64'hAAAAAAAAAAAEAAAA)) 
    s_axi_arready_INST_0
       (.I0(ip2bus_rdack_i_D1),
        .I1(S_AXI_GPIO_arready),
        .I2(S_AXI_GPIO_arready_0[2]),
        .I3(S_AXI_GPIO_arready_0[1]),
        .I4(S_AXI_GPIO_arready_0[3]),
        .I5(S_AXI_GPIO_arready_0[0]),
        .O(ip2bus_rdack_i_D1_reg));
  LUT6 #(
    .INIT(64'hAAAAAAAAAAAEAAAA)) 
    s_axi_wready_INST_0
       (.I0(ip2bus_wrack_i_D1),
        .I1(S_AXI_GPIO_wready),
        .I2(S_AXI_GPIO_arready_0[2]),
        .I3(S_AXI_GPIO_arready_0[1]),
        .I4(S_AXI_GPIO_arready_0[3]),
        .I5(S_AXI_GPIO_arready_0[0]),
        .O(ip2bus_wrack_i_D1_reg));
endmodule

(* ORIG_REF_NAME = "address_decoder" *) 
module decalper_eb_ot_sdeen_pot_pi_dehcac_xnilix_address_decoder__parameterized0
   (\GEN_BKEND_CE_REGISTERS[0].ce_out_i_reg[0]_0 ,
    bus2ip_rdce_i,
    Wr,
    bus2ip_wrce_i,
    s_axi_aclk,
    Q,
    s_axi_aresetn,
    \GEN_BKEND_CE_REGISTERS[0].ce_out_i_reg[0]_1 ,
    \GEN_BKEND_CE_REGISTERS[0].ce_out_i_reg[0]_2 ,
    Bus_RNW_reg_reg_0,
    wrReq_d1);
  output \GEN_BKEND_CE_REGISTERS[0].ce_out_i_reg[0]_0 ;
  output bus2ip_rdce_i;
  output Wr;
  output bus2ip_wrce_i;
  input s_axi_aclk;
  input Q;
  input s_axi_aresetn;
  input \GEN_BKEND_CE_REGISTERS[0].ce_out_i_reg[0]_1 ;
  input \GEN_BKEND_CE_REGISTERS[0].ce_out_i_reg[0]_2 ;
  input Bus_RNW_reg_reg_0;
  input wrReq_d1;

  wire Bus_RNW_reg;
  wire Bus_RNW_reg_i_1_n_0;
  wire Bus_RNW_reg_reg_0;
  wire \GEN_BKEND_CE_REGISTERS[0].ce_out_i[0]_i_1_n_0 ;
  wire \GEN_BKEND_CE_REGISTERS[0].ce_out_i_reg[0]_0 ;
  wire \GEN_BKEND_CE_REGISTERS[0].ce_out_i_reg[0]_1 ;
  wire \GEN_BKEND_CE_REGISTERS[0].ce_out_i_reg[0]_2 ;
  wire Q;
  wire Wr;
  wire bus2ip_rdce_i;
  wire bus2ip_wrce_i;
  wire s_axi_aclk;
  wire s_axi_aresetn;
  wire wrReq_d1;

  (* SOFT_HLUTNM = "soft_lutpair14" *) 
  LUT3 #(
    .INIT(8'hB8)) 
    Bus_RNW_reg_i_1
       (.I0(Bus_RNW_reg_reg_0),
        .I1(Q),
        .I2(Bus_RNW_reg),
        .O(Bus_RNW_reg_i_1_n_0));
  FDRE Bus_RNW_reg_reg
       (.C(s_axi_aclk),
        .CE(1'b1),
        .D(Bus_RNW_reg_i_1_n_0),
        .Q(Bus_RNW_reg),
        .R(1'b0));
  LUT5 #(
    .INIT(32'h000000E0)) 
    \GEN_BKEND_CE_REGISTERS[0].ce_out_i[0]_i_1 
       (.I0(\GEN_BKEND_CE_REGISTERS[0].ce_out_i_reg[0]_0 ),
        .I1(Q),
        .I2(s_axi_aresetn),
        .I3(\GEN_BKEND_CE_REGISTERS[0].ce_out_i_reg[0]_1 ),
        .I4(\GEN_BKEND_CE_REGISTERS[0].ce_out_i_reg[0]_2 ),
        .O(\GEN_BKEND_CE_REGISTERS[0].ce_out_i[0]_i_1_n_0 ));
  FDRE \GEN_BKEND_CE_REGISTERS[0].ce_out_i_reg[0] 
       (.C(s_axi_aclk),
        .CE(1'b1),
        .D(\GEN_BKEND_CE_REGISTERS[0].ce_out_i[0]_i_1_n_0 ),
        .Q(\GEN_BKEND_CE_REGISTERS[0].ce_out_i_reg[0]_0 ),
        .R(1'b0));
  (* SOFT_HLUTNM = "soft_lutpair14" *) 
  LUT2 #(
    .INIT(4'h8)) 
    bus2ip_rdreq_d1_i_1
       (.I0(\GEN_BKEND_CE_REGISTERS[0].ce_out_i_reg[0]_0 ),
        .I1(Bus_RNW_reg),
        .O(bus2ip_rdce_i));
  (* SOFT_HLUTNM = "soft_lutpair15" *) 
  LUT2 #(
    .INIT(4'h2)) 
    wrReq_d1_i_1
       (.I0(\GEN_BKEND_CE_REGISTERS[0].ce_out_i_reg[0]_0 ),
        .I1(Bus_RNW_reg),
        .O(bus2ip_wrce_i));
  (* SOFT_HLUTNM = "soft_lutpair15" *) 
  LUT3 #(
    .INIT(8'h04)) 
    wr_d_i_1
       (.I0(Bus_RNW_reg),
        .I1(\GEN_BKEND_CE_REGISTERS[0].ce_out_i_reg[0]_0 ),
        .I2(wrReq_d1),
        .O(Wr));
endmodule

(* C_ALL_INPUTS = "0" *) (* C_ALL_INPUTS_2 = "0" *) (* C_ALL_OUTPUTS = "0" *) 
(* C_ALL_OUTPUTS_2 = "0" *) (* C_DOUT_DEFAULT = "0" *) (* C_DOUT_DEFAULT_2 = "0" *) 
(* C_FAMILY = "artix7" *) (* C_GPIO2_WIDTH = "2" *) (* C_GPIO_WIDTH = "4" *) 
(* C_INTERRUPT_PRESENT = "0" *) (* C_IS_DUAL = "1" *) (* C_S_AXI_ADDR_WIDTH = "9" *) 
(* C_S_AXI_DATA_WIDTH = "32" *) (* C_TRI_DEFAULT = "-1" *) (* C_TRI_DEFAULT_2 = "-1" *) 
(* DowngradeIPIdentifiedWarnings = "yes" *) (* ip_group = "LOGICORE" *) 
module decalper_eb_ot_sdeen_pot_pi_dehcac_xnilix_axi_gpio
   (s_axi_aclk,
    s_axi_aresetn,
    s_axi_awaddr,
    s_axi_awvalid,
    s_axi_awready,
    s_axi_wdata,
    s_axi_wstrb,
    s_axi_wvalid,
    s_axi_wready,
    s_axi_bresp,
    s_axi_bvalid,
    s_axi_bready,
    s_axi_araddr,
    s_axi_arvalid,
    s_axi_arready,
    s_axi_rdata,
    s_axi_rresp,
    s_axi_rvalid,
    s_axi_rready,
    ip2intc_irpt,
    gpio_io_i,
    gpio_io_o,
    gpio_io_t,
    gpio2_io_i,
    gpio2_io_o,
    gpio2_io_t);
  (* sigis = "Clk" *) input s_axi_aclk;
  (* sigis = "Rst" *) input s_axi_aresetn;
  input [8:0]s_axi_awaddr;
  input s_axi_awvalid;
  output s_axi_awready;
  input [31:0]s_axi_wdata;
  input [3:0]s_axi_wstrb;
  input s_axi_wvalid;
  output s_axi_wready;
  output [1:0]s_axi_bresp;
  output s_axi_bvalid;
  input s_axi_bready;
  input [8:0]s_axi_araddr;
  input s_axi_arvalid;
  output s_axi_arready;
  output [31:0]s_axi_rdata;
  output [1:0]s_axi_rresp;
  output s_axi_rvalid;
  input s_axi_rready;
  (* sigis = "INTR_LEVEL_HIGH" *) output ip2intc_irpt;
  input [3:0]gpio_io_i;
  output [3:0]gpio_io_o;
  output [3:0]gpio_io_t;
  input [1:0]gpio2_io_i;
  output [1:0]gpio2_io_o;
  output [1:0]gpio2_io_t;

  wire \<const0> ;
  wire AXI_LITE_IPIF_I_n_10;
  wire AXI_LITE_IPIF_I_n_14;
  wire AXI_LITE_IPIF_I_n_21;
  wire AXI_LITE_IPIF_I_n_22;
  wire AXI_LITE_IPIF_I_n_25;
  wire [0:3]DBus_Reg;
  wire [3:0]GPIO_DBus;
  wire GPIO_xferAck_i;
  wire \I_SLAVE_ATTACHMENT/I_DECODER/Bus_RNW_reg ;
  wire \I_SLAVE_ATTACHMENT/I_DECODER/GEN_BKEND_CE_REGISTERS[0].ce_out_i_reg ;
  wire \I_SLAVE_ATTACHMENT/I_DECODER/GEN_BKEND_CE_REGISTERS[1].ce_out_i_reg ;
  wire \I_SLAVE_ATTACHMENT/I_DECODER/GEN_BKEND_CE_REGISTERS[2].ce_out_i_reg ;
  wire \I_SLAVE_ATTACHMENT/I_DECODER/GEN_BKEND_CE_REGISTERS[3].ce_out_i_reg ;
  wire [5:6]bus2ip_addr;
  wire bus2ip_cs;
  wire bus2ip_reset;
  wire bus2ip_rnw;
  wire [1:0]gpio2_io_i;
  wire [1:0]gpio2_io_o;
  wire [1:0]gpio2_io_t;
  wire gpio_core_1_n_14;
  wire [3:0]gpio_io_i;
  wire [3:0]gpio_io_o;
  wire [3:0]gpio_io_t;
  wire gpio_reg_en;
  wire gpio_xferAck_Reg;
  wire [28:31]ip2bus_data_i_D1;
  wire ip2bus_rdack_i;
  wire ip2bus_rdack_i_D1;
  wire ip2bus_wrack_i;
  wire ip2bus_wrack_i_D1;
  wire p_0_in3_in;
  wire p_1_in2_in;
  wire [28:31]reg1;
  wire [28:31]reg2;
  wire [30:31]reg3;
  wire [30:31]reg4;
  wire s_axi_aclk;
  wire [8:0]s_axi_araddr;
  wire s_axi_aresetn;
  wire s_axi_arready;
  wire s_axi_arvalid;
  wire [8:0]s_axi_awaddr;
  wire s_axi_awvalid;
  wire s_axi_bready;
  wire s_axi_bvalid;
  wire [3:0]\^s_axi_rdata ;
  wire s_axi_rready;
  wire s_axi_rvalid;
  wire [31:0]s_axi_wdata;
  wire s_axi_wready;
  wire s_axi_wvalid;

  assign ip2intc_irpt = \<const0> ;
  assign s_axi_awready = s_axi_wready;
  assign s_axi_bresp[1] = \<const0> ;
  assign s_axi_bresp[0] = \<const0> ;
  assign s_axi_rdata[31] = \<const0> ;
  assign s_axi_rdata[30] = \<const0> ;
  assign s_axi_rdata[29] = \<const0> ;
  assign s_axi_rdata[28] = \<const0> ;
  assign s_axi_rdata[27] = \<const0> ;
  assign s_axi_rdata[26] = \<const0> ;
  assign s_axi_rdata[25] = \<const0> ;
  assign s_axi_rdata[24] = \<const0> ;
  assign s_axi_rdata[23] = \<const0> ;
  assign s_axi_rdata[22] = \<const0> ;
  assign s_axi_rdata[21] = \<const0> ;
  assign s_axi_rdata[20] = \<const0> ;
  assign s_axi_rdata[19] = \<const0> ;
  assign s_axi_rdata[18] = \<const0> ;
  assign s_axi_rdata[17] = \<const0> ;
  assign s_axi_rdata[16] = \<const0> ;
  assign s_axi_rdata[15] = \<const0> ;
  assign s_axi_rdata[14] = \<const0> ;
  assign s_axi_rdata[13] = \<const0> ;
  assign s_axi_rdata[12] = \<const0> ;
  assign s_axi_rdata[11] = \<const0> ;
  assign s_axi_rdata[10] = \<const0> ;
  assign s_axi_rdata[9] = \<const0> ;
  assign s_axi_rdata[8] = \<const0> ;
  assign s_axi_rdata[7] = \<const0> ;
  assign s_axi_rdata[6] = \<const0> ;
  assign s_axi_rdata[5] = \<const0> ;
  assign s_axi_rdata[4] = \<const0> ;
  assign s_axi_rdata[3:0] = \^s_axi_rdata [3:0];
  assign s_axi_rresp[1] = \<const0> ;
  assign s_axi_rresp[0] = \<const0> ;
  decalper_eb_ot_sdeen_pot_pi_dehcac_xnilix_axi_lite_ipif AXI_LITE_IPIF_I
       (.Bus_RNW_reg(\I_SLAVE_ATTACHMENT/I_DECODER/Bus_RNW_reg ),
        .D({DBus_Reg[0],DBus_Reg[1],DBus_Reg[2],DBus_Reg[3]}),
        .\Dual.ALLOUT0_ND_G0.READ_REG_GEN[0].reg1_reg[28] (GPIO_DBus),
        .E(AXI_LITE_IPIF_I_n_21),
        .\GEN_BKEND_CE_REGISTERS[0].ce_out_i_reg (\I_SLAVE_ATTACHMENT/I_DECODER/GEN_BKEND_CE_REGISTERS[0].ce_out_i_reg ),
        .\GEN_BKEND_CE_REGISTERS[1].ce_out_i_reg (\I_SLAVE_ATTACHMENT/I_DECODER/GEN_BKEND_CE_REGISTERS[1].ce_out_i_reg ),
        .\GEN_BKEND_CE_REGISTERS[2].ce_out_i_reg (\I_SLAVE_ATTACHMENT/I_DECODER/GEN_BKEND_CE_REGISTERS[2].ce_out_i_reg ),
        .\GEN_BKEND_CE_REGISTERS[3].ce_out_i_reg (\I_SLAVE_ATTACHMENT/I_DECODER/GEN_BKEND_CE_REGISTERS[3].ce_out_i_reg ),
        .GPIO_xferAck_i(GPIO_xferAck_i),
        .Q({bus2ip_addr[5],bus2ip_addr[6]}),
        .\bus2ip_addr_i_reg[8] (AXI_LITE_IPIF_I_n_10),
        .bus2ip_cs(bus2ip_cs),
        .bus2ip_reset(bus2ip_reset),
        .bus2ip_rnw(bus2ip_rnw),
        .bus2ip_rnw_i_reg(AXI_LITE_IPIF_I_n_22),
        .bus2ip_rnw_i_reg_0(AXI_LITE_IPIF_I_n_25),
        .gpio_reg_en(gpio_reg_en),
        .gpio_xferAck_Reg(gpio_xferAck_Reg),
        .\ip2bus_data_i_D1_reg[29] (gpio_core_1_n_14),
        .ip2bus_rdack_i_D1(ip2bus_rdack_i_D1),
        .ip2bus_rdack_i_D1_reg(s_axi_arready),
        .ip2bus_wrack_i_D1(ip2bus_wrack_i_D1),
        .ip2bus_wrack_i_D1_reg(s_axi_wready),
        .p_0_in3_in(p_0_in3_in),
        .p_1_in2_in(p_1_in2_in),
        .reg1({reg1[28],reg1[29],reg1[30],reg1[31]}),
        .reg2({reg2[28],reg2[29],reg2[30],reg2[31]}),
        .reg3({reg3[30],reg3[31]}),
        .reg4({reg4[30],reg4[31]}),
        .rst_reg(AXI_LITE_IPIF_I_n_14),
        .s_axi_aclk(s_axi_aclk),
        .s_axi_araddr({s_axi_araddr[8],s_axi_araddr[3:2]}),
        .s_axi_aresetn(s_axi_aresetn),
        .s_axi_arvalid(s_axi_arvalid),
        .s_axi_awaddr({s_axi_awaddr[8],s_axi_awaddr[3:2]}),
        .s_axi_awvalid(s_axi_awvalid),
        .s_axi_bready(s_axi_bready),
        .s_axi_bvalid_i_reg(s_axi_bvalid),
        .s_axi_rdata(\^s_axi_rdata ),
        .\s_axi_rdata_i_reg[3] ({ip2bus_data_i_D1[28],ip2bus_data_i_D1[29],ip2bus_data_i_D1[30],ip2bus_data_i_D1[31]}),
        .s_axi_rready(s_axi_rready),
        .s_axi_rvalid_i_reg(s_axi_rvalid),
        .s_axi_wdata(s_axi_wdata[3:0]),
        .s_axi_wvalid(s_axi_wvalid));
  GND GND
       (.G(\<const0> ));
  decalper_eb_ot_sdeen_pot_pi_dehcac_xnilix_GPIO_Core gpio_core_1
       (.Bus_RNW_reg(\I_SLAVE_ATTACHMENT/I_DECODER/Bus_RNW_reg ),
        .D({DBus_Reg[0],DBus_Reg[1],DBus_Reg[2],DBus_Reg[3]}),
        .\Dual.ALLOUT0_ND_G2.READ_REG2_GEN[0].reg4_reg[30]_0 (AXI_LITE_IPIF_I_n_25),
        .\Dual.gpio2_Data_Out_reg[0]_0 (AXI_LITE_IPIF_I_n_14),
        .\Dual.gpio2_OE_reg[0]_0 (gpio2_io_t[1]),
        .\Dual.gpio2_OE_reg[0]_1 (AXI_LITE_IPIF_I_n_10),
        .\Dual.gpio2_OE_reg[1]_0 (gpio2_io_t[0]),
        .\Dual.gpio_OE_reg[0]_0 (AXI_LITE_IPIF_I_n_22),
        .E(AXI_LITE_IPIF_I_n_21),
        .\GEN_BKEND_CE_REGISTERS[0].ce_out_i_reg (\I_SLAVE_ATTACHMENT/I_DECODER/GEN_BKEND_CE_REGISTERS[0].ce_out_i_reg ),
        .\GEN_BKEND_CE_REGISTERS[1].ce_out_i_reg (\I_SLAVE_ATTACHMENT/I_DECODER/GEN_BKEND_CE_REGISTERS[1].ce_out_i_reg ),
        .\GEN_BKEND_CE_REGISTERS[2].ce_out_i_reg (\I_SLAVE_ATTACHMENT/I_DECODER/GEN_BKEND_CE_REGISTERS[2].ce_out_i_reg ),
        .\GEN_BKEND_CE_REGISTERS[3].ce_out_i_reg (\I_SLAVE_ATTACHMENT/I_DECODER/GEN_BKEND_CE_REGISTERS[3].ce_out_i_reg ),
        .\GEN_BKEND_CE_REGISTERS[3].ce_out_i_reg[3] (gpio_core_1_n_14),
        .GPIO_xferAck_i(GPIO_xferAck_i),
        .Q({bus2ip_addr[5],bus2ip_addr[6]}),
        .bus2ip_cs(bus2ip_cs),
        .bus2ip_reset(bus2ip_reset),
        .bus2ip_rnw(bus2ip_rnw),
        .gpio2_io_i(gpio2_io_i),
        .gpio2_io_o(gpio2_io_o),
        .gpio_io_i(gpio_io_i),
        .gpio_io_o(gpio_io_o),
        .gpio_io_t(gpio_io_t),
        .gpio_reg_en(gpio_reg_en),
        .gpio_xferAck_Reg(gpio_xferAck_Reg),
        .ip2bus_rdack_i(ip2bus_rdack_i),
        .ip2bus_wrack_i(ip2bus_wrack_i),
        .p_0_in3_in(p_0_in3_in),
        .p_1_in2_in(p_1_in2_in),
        .reg1({reg1[28],reg1[29],reg1[30],reg1[31]}),
        .reg2({reg2[28],reg2[29],reg2[30],reg2[31]}),
        .reg3({reg3[30],reg3[31]}),
        .reg4({reg4[30],reg4[31]}),
        .s_axi_aclk(s_axi_aclk),
        .s_axi_wdata(s_axi_wdata[3:0]));
  FDRE \ip2bus_data_i_D1_reg[28] 
       (.C(s_axi_aclk),
        .CE(1'b1),
        .D(GPIO_DBus[3]),
        .Q(ip2bus_data_i_D1[28]),
        .R(bus2ip_reset));
  FDRE \ip2bus_data_i_D1_reg[29] 
       (.C(s_axi_aclk),
        .CE(1'b1),
        .D(GPIO_DBus[2]),
        .Q(ip2bus_data_i_D1[29]),
        .R(bus2ip_reset));
  FDRE \ip2bus_data_i_D1_reg[30] 
       (.C(s_axi_aclk),
        .CE(1'b1),
        .D(GPIO_DBus[1]),
        .Q(ip2bus_data_i_D1[30]),
        .R(bus2ip_reset));
  FDRE \ip2bus_data_i_D1_reg[31] 
       (.C(s_axi_aclk),
        .CE(1'b1),
        .D(GPIO_DBus[0]),
        .Q(ip2bus_data_i_D1[31]),
        .R(bus2ip_reset));
  FDRE ip2bus_rdack_i_D1_reg
       (.C(s_axi_aclk),
        .CE(1'b1),
        .D(ip2bus_rdack_i),
        .Q(ip2bus_rdack_i_D1),
        .R(bus2ip_reset));
  FDRE ip2bus_wrack_i_D1_reg
       (.C(s_axi_aclk),
        .CE(1'b1),
        .D(ip2bus_wrack_i),
        .Q(ip2bus_wrack_i_D1),
        .R(bus2ip_reset));
endmodule

module decalper_eb_ot_sdeen_pot_pi_dehcac_xnilix_axi_lite_ipif
   (bus2ip_reset,
    \GEN_BKEND_CE_REGISTERS[3].ce_out_i_reg ,
    \GEN_BKEND_CE_REGISTERS[2].ce_out_i_reg ,
    \GEN_BKEND_CE_REGISTERS[1].ce_out_i_reg ,
    \GEN_BKEND_CE_REGISTERS[0].ce_out_i_reg ,
    bus2ip_rnw,
    Bus_RNW_reg,
    s_axi_rvalid_i_reg,
    s_axi_bvalid_i_reg,
    bus2ip_cs,
    \bus2ip_addr_i_reg[8] ,
    Q,
    p_1_in2_in,
    rst_reg,
    p_0_in3_in,
    gpio_reg_en,
    D,
    E,
    bus2ip_rnw_i_reg,
    ip2bus_rdack_i_D1_reg,
    ip2bus_wrack_i_D1_reg,
    bus2ip_rnw_i_reg_0,
    s_axi_rdata,
    \Dual.ALLOUT0_ND_G0.READ_REG_GEN[0].reg1_reg[28] ,
    s_axi_aclk,
    s_axi_arvalid,
    s_axi_wdata,
    s_axi_rready,
    s_axi_bready,
    s_axi_aresetn,
    s_axi_awvalid,
    s_axi_wvalid,
    GPIO_xferAck_i,
    gpio_xferAck_Reg,
    \s_axi_rdata_i_reg[3] ,
    reg2,
    reg1,
    reg3,
    \ip2bus_data_i_D1_reg[29] ,
    reg4,
    ip2bus_rdack_i_D1,
    ip2bus_wrack_i_D1,
    s_axi_araddr,
    s_axi_awaddr);
  output bus2ip_reset;
  output \GEN_BKEND_CE_REGISTERS[3].ce_out_i_reg ;
  output \GEN_BKEND_CE_REGISTERS[2].ce_out_i_reg ;
  output \GEN_BKEND_CE_REGISTERS[1].ce_out_i_reg ;
  output \GEN_BKEND_CE_REGISTERS[0].ce_out_i_reg ;
  output bus2ip_rnw;
  output Bus_RNW_reg;
  output s_axi_rvalid_i_reg;
  output s_axi_bvalid_i_reg;
  output bus2ip_cs;
  output \bus2ip_addr_i_reg[8] ;
  output [1:0]Q;
  output p_1_in2_in;
  output rst_reg;
  output p_0_in3_in;
  output gpio_reg_en;
  output [3:0]D;
  output [0:0]E;
  output [0:0]bus2ip_rnw_i_reg;
  output ip2bus_rdack_i_D1_reg;
  output ip2bus_wrack_i_D1_reg;
  output bus2ip_rnw_i_reg_0;
  output [3:0]s_axi_rdata;
  output [3:0]\Dual.ALLOUT0_ND_G0.READ_REG_GEN[0].reg1_reg[28] ;
  input s_axi_aclk;
  input s_axi_arvalid;
  input [3:0]s_axi_wdata;
  input s_axi_rready;
  input s_axi_bready;
  input s_axi_aresetn;
  input s_axi_awvalid;
  input s_axi_wvalid;
  input GPIO_xferAck_i;
  input gpio_xferAck_Reg;
  input [3:0]\s_axi_rdata_i_reg[3] ;
  input [3:0]reg2;
  input [3:0]reg1;
  input [1:0]reg3;
  input \ip2bus_data_i_D1_reg[29] ;
  input [1:0]reg4;
  input ip2bus_rdack_i_D1;
  input ip2bus_wrack_i_D1;
  input [2:0]s_axi_araddr;
  input [2:0]s_axi_awaddr;

  wire Bus_RNW_reg;
  wire [3:0]D;
  wire [3:0]\Dual.ALLOUT0_ND_G0.READ_REG_GEN[0].reg1_reg[28] ;
  wire [0:0]E;
  wire \GEN_BKEND_CE_REGISTERS[0].ce_out_i_reg ;
  wire \GEN_BKEND_CE_REGISTERS[1].ce_out_i_reg ;
  wire \GEN_BKEND_CE_REGISTERS[2].ce_out_i_reg ;
  wire \GEN_BKEND_CE_REGISTERS[3].ce_out_i_reg ;
  wire GPIO_xferAck_i;
  wire [1:0]Q;
  wire \bus2ip_addr_i_reg[8] ;
  wire bus2ip_cs;
  wire bus2ip_reset;
  wire bus2ip_rnw;
  wire [0:0]bus2ip_rnw_i_reg;
  wire bus2ip_rnw_i_reg_0;
  wire gpio_reg_en;
  wire gpio_xferAck_Reg;
  wire \ip2bus_data_i_D1_reg[29] ;
  wire ip2bus_rdack_i_D1;
  wire ip2bus_rdack_i_D1_reg;
  wire ip2bus_wrack_i_D1;
  wire ip2bus_wrack_i_D1_reg;
  wire p_0_in3_in;
  wire p_1_in2_in;
  wire [3:0]reg1;
  wire [3:0]reg2;
  wire [1:0]reg3;
  wire [1:0]reg4;
  wire rst_reg;
  wire s_axi_aclk;
  wire [2:0]s_axi_araddr;
  wire s_axi_aresetn;
  wire s_axi_arvalid;
  wire [2:0]s_axi_awaddr;
  wire s_axi_awvalid;
  wire s_axi_bready;
  wire s_axi_bvalid_i_reg;
  wire [3:0]s_axi_rdata;
  wire [3:0]\s_axi_rdata_i_reg[3] ;
  wire s_axi_rready;
  wire s_axi_rvalid_i_reg;
  wire [3:0]s_axi_wdata;
  wire s_axi_wvalid;

  decalper_eb_ot_sdeen_pot_pi_dehcac_xnilix_slave_attachment I_SLAVE_ATTACHMENT
       (.Bus_RNW_reg_reg(Bus_RNW_reg),
        .D(D),
        .\Dual.ALLOUT0_ND_G0.READ_REG_GEN[0].reg1_reg[28] (\Dual.ALLOUT0_ND_G0.READ_REG_GEN[0].reg1_reg[28] ),
        .E(E),
        .\GEN_BKEND_CE_REGISTERS[0].ce_out_i_reg[0] (\GEN_BKEND_CE_REGISTERS[0].ce_out_i_reg ),
        .\GEN_BKEND_CE_REGISTERS[1].ce_out_i_reg[1] (\GEN_BKEND_CE_REGISTERS[1].ce_out_i_reg ),
        .\GEN_BKEND_CE_REGISTERS[2].ce_out_i_reg (\GEN_BKEND_CE_REGISTERS[2].ce_out_i_reg ),
        .\GEN_BKEND_CE_REGISTERS[3].ce_out_i_reg (\GEN_BKEND_CE_REGISTERS[3].ce_out_i_reg ),
        .GPIO_xferAck_i(GPIO_xferAck_i),
        .\MEM_DECODE_GEN[0].cs_out_i_reg[0] (bus2ip_cs),
        .Q(Q),
        .SR(bus2ip_reset),
        .\bus2ip_addr_i_reg[8]_0 (\bus2ip_addr_i_reg[8] ),
        .bus2ip_rnw_i_reg_0(bus2ip_rnw),
        .bus2ip_rnw_i_reg_1(bus2ip_rnw_i_reg),
        .bus2ip_rnw_i_reg_2(bus2ip_rnw_i_reg_0),
        .gpio_reg_en(gpio_reg_en),
        .gpio_xferAck_Reg(gpio_xferAck_Reg),
        .\ip2bus_data_i_D1_reg[29] (\ip2bus_data_i_D1_reg[29] ),
        .ip2bus_rdack_i_D1(ip2bus_rdack_i_D1),
        .ip2bus_rdack_i_D1_reg(ip2bus_rdack_i_D1_reg),
        .ip2bus_wrack_i_D1(ip2bus_wrack_i_D1),
        .ip2bus_wrack_i_D1_reg(ip2bus_wrack_i_D1_reg),
        .p_0_in3_in(p_0_in3_in),
        .p_1_in2_in(p_1_in2_in),
        .reg1(reg1),
        .reg2(reg2),
        .reg3(reg3),
        .reg4(reg4),
        .rst_reg_0(rst_reg),
        .s_axi_aclk(s_axi_aclk),
        .s_axi_araddr(s_axi_araddr),
        .s_axi_aresetn(s_axi_aresetn),
        .s_axi_arvalid(s_axi_arvalid),
        .s_axi_awaddr(s_axi_awaddr),
        .s_axi_awvalid(s_axi_awvalid),
        .s_axi_bready(s_axi_bready),
        .s_axi_bvalid_i_reg_0(s_axi_bvalid_i_reg),
        .s_axi_rdata(s_axi_rdata),
        .\s_axi_rdata_i_reg[3]_0 (\s_axi_rdata_i_reg[3] ),
        .s_axi_rready(s_axi_rready),
        .s_axi_rvalid_i_reg_0(s_axi_rvalid_i_reg),
        .s_axi_wdata(s_axi_wdata),
        .s_axi_wvalid(s_axi_wvalid));
endmodule

(* ORIG_REF_NAME = "axi_lite_ipif" *) 
module decalper_eb_ot_sdeen_pot_pi_dehcac_xnilix_axi_lite_ipif__parameterized0
   (ce_out_i,
    s_axi_rvalid,
    s_axi_bvalid,
    s_axi_rdata,
    \bus2ip_addr_i_reg[4] ,
    bus2ip_rdce_i,
    Wr,
    bus2ip_wrce_i,
    bus2ip_reset_int_core,
    s_axi_arvalid,
    s_axi_aclk,
    s_axi_aresetn,
    \GEN_BKEND_CE_REGISTERS[0].ce_out_i_reg[0] ,
    \GEN_BKEND_CE_REGISTERS[0].ce_out_i_reg[0]_0 ,
    s_axi_awvalid,
    s_axi_wvalid,
    s_axi_bready,
    s_axi_rready,
    s_axi_araddr,
    s_axi_awaddr,
    Q,
    wrReq_d1);
  output ce_out_i;
  output s_axi_rvalid;
  output s_axi_bvalid;
  output [7:0]s_axi_rdata;
  output [2:0]\bus2ip_addr_i_reg[4] ;
  output bus2ip_rdce_i;
  output Wr;
  output bus2ip_wrce_i;
  input bus2ip_reset_int_core;
  input s_axi_arvalid;
  input s_axi_aclk;
  input s_axi_aresetn;
  input \GEN_BKEND_CE_REGISTERS[0].ce_out_i_reg[0] ;
  input \GEN_BKEND_CE_REGISTERS[0].ce_out_i_reg[0]_0 ;
  input s_axi_awvalid;
  input s_axi_wvalid;
  input s_axi_bready;
  input s_axi_rready;
  input [2:0]s_axi_araddr;
  input [2:0]s_axi_awaddr;
  input [7:0]Q;
  input wrReq_d1;

  wire \GEN_BKEND_CE_REGISTERS[0].ce_out_i_reg[0] ;
  wire \GEN_BKEND_CE_REGISTERS[0].ce_out_i_reg[0]_0 ;
  wire [7:0]Q;
  wire Wr;
  wire [2:0]\bus2ip_addr_i_reg[4] ;
  wire bus2ip_rdce_i;
  wire bus2ip_reset_int_core;
  wire bus2ip_wrce_i;
  wire ce_out_i;
  wire s_axi_aclk;
  wire [2:0]s_axi_araddr;
  wire s_axi_aresetn;
  wire s_axi_arvalid;
  wire [2:0]s_axi_awaddr;
  wire s_axi_awvalid;
  wire s_axi_bready;
  wire s_axi_bvalid;
  wire [7:0]s_axi_rdata;
  wire s_axi_rready;
  wire s_axi_rvalid;
  wire s_axi_wvalid;
  wire wrReq_d1;

  decalper_eb_ot_sdeen_pot_pi_dehcac_xnilix_slave_attachment__parameterized0 I_SLAVE_ATTACHMENT
       (.\GEN_BKEND_CE_REGISTERS[0].ce_out_i_reg[0] (ce_out_i),
        .\GEN_BKEND_CE_REGISTERS[0].ce_out_i_reg[0]_0 (\GEN_BKEND_CE_REGISTERS[0].ce_out_i_reg[0] ),
        .\GEN_BKEND_CE_REGISTERS[0].ce_out_i_reg[0]_1 (\GEN_BKEND_CE_REGISTERS[0].ce_out_i_reg[0]_0 ),
        .Q(Q),
        .Wr(Wr),
        .\bus2ip_addr_i_reg[4]_0 (\bus2ip_addr_i_reg[4] ),
        .bus2ip_rdce_i(bus2ip_rdce_i),
        .bus2ip_reset_int_core(bus2ip_reset_int_core),
        .bus2ip_wrce_i(bus2ip_wrce_i),
        .s_axi_aclk(s_axi_aclk),
        .s_axi_araddr(s_axi_araddr),
        .s_axi_aresetn(s_axi_aresetn),
        .s_axi_arvalid(s_axi_arvalid),
        .s_axi_awaddr(s_axi_awaddr),
        .s_axi_awvalid(s_axi_awvalid),
        .s_axi_bready(s_axi_bready),
        .s_axi_bvalid(s_axi_bvalid),
        .s_axi_rdata(s_axi_rdata),
        .s_axi_rready(s_axi_rready),
        .s_axi_rvalid(s_axi_rvalid),
        .s_axi_wvalid(s_axi_wvalid),
        .wrReq_d1(wrReq_d1));
endmodule

(* C_EXTERNAL_XIN_CLK_HZ = "25000000" *) (* C_FAMILY = "artix7" *) (* C_HAS_EXTERNAL_RCLK = "0" *) 
(* C_HAS_EXTERNAL_XIN = "0" *) (* C_IS_A_16550 = "1" *) (* C_SIM_DEVICE = "VERSAL_AI_CORE_ES1" *) 
(* C_S_AXI_ACLK_FREQ_HZ = "100000000" *) (* C_S_AXI_ADDR_WIDTH = "13" *) (* C_S_AXI_DATA_WIDTH = "32" *) 
(* DowngradeIPIdentifiedWarnings = "yes" *) 
module decalper_eb_ot_sdeen_pot_pi_dehcac_xnilix_axi_uart16550
   (s_axi_aclk,
    s_axi_aresetn,
    ip2intc_irpt,
    freeze,
    s_axi_awaddr,
    s_axi_awvalid,
    s_axi_awready,
    s_axi_wdata,
    s_axi_wstrb,
    s_axi_wvalid,
    s_axi_wready,
    s_axi_bresp,
    s_axi_bvalid,
    s_axi_bready,
    s_axi_araddr,
    s_axi_arvalid,
    s_axi_arready,
    s_axi_rdata,
    s_axi_rresp,
    s_axi_rvalid,
    s_axi_rready,
    baudoutn,
    ctsn,
    dcdn,
    ddis,
    dsrn,
    dtrn,
    out1n,
    out2n,
    rclk,
    rin,
    rtsn,
    rxrdyn,
    sin,
    sout,
    txrdyn,
    xin,
    xout);
  input s_axi_aclk;
  input s_axi_aresetn;
  (* sigis = "INTERRUPT" *) output ip2intc_irpt;
  input freeze;
  input [12:0]s_axi_awaddr;
  input s_axi_awvalid;
  output s_axi_awready;
  input [31:0]s_axi_wdata;
  input [3:0]s_axi_wstrb;
  input s_axi_wvalid;
  output s_axi_wready;
  output [1:0]s_axi_bresp;
  output s_axi_bvalid;
  input s_axi_bready;
  input [12:0]s_axi_araddr;
  input s_axi_arvalid;
  output s_axi_arready;
  output [31:0]s_axi_rdata;
  output [1:0]s_axi_rresp;
  output s_axi_rvalid;
  input s_axi_rready;
  output baudoutn;
  input ctsn;
  input dcdn;
  output ddis;
  input dsrn;
  output dtrn;
  output out1n;
  output out2n;
  (* sigis = "CLK" *) input rclk;
  input rin;
  output rtsn;
  output rxrdyn;
  input sin;
  output sout;
  output txrdyn;
  (* sigis = "CLK" *) input xin;
  output xout;

  wire \<const0> ;
  wire [2:0]Addr;
  wire [7:0]Dout;
  wire \IPIC_IF_I_1/wrReq_d1 ;
  wire \I_SLAVE_ATTACHMENT/I_DECODER/ce_out_i ;
  wire Wr;
  wire baudoutn;
  wire bus2ip_rdce_i;
  wire bus2ip_reset_int_core;
  wire bus2ip_reset_int_core_i_1_n_0;
  wire bus2ip_wrce_i;
  wire ctsn;
  wire dcdn;
  wire ddis;
  wire dsrn;
  wire dtrn;
  wire freeze;
  wire ip2intc_irpt;
  wire out1n;
  wire out2n;
  wire rin;
  wire rtsn;
  wire rxrdyn;
  wire s_axi_aclk;
  wire [12:0]s_axi_araddr;
  wire s_axi_aresetn;
  wire s_axi_arready;
  wire s_axi_arvalid;
  wire [12:0]s_axi_awaddr;
  wire s_axi_awready;
  wire s_axi_awvalid;
  wire s_axi_bready;
  wire s_axi_bvalid;
  wire [7:0]\^s_axi_rdata ;
  wire s_axi_rready;
  wire s_axi_rvalid;
  wire [31:0]s_axi_wdata;
  wire s_axi_wvalid;
  wire sin;
  wire sout;
  wire txrdyn;

  assign s_axi_bresp[1] = \<const0> ;
  assign s_axi_bresp[0] = \<const0> ;
  assign s_axi_rdata[31] = \<const0> ;
  assign s_axi_rdata[30] = \<const0> ;
  assign s_axi_rdata[29] = \<const0> ;
  assign s_axi_rdata[28] = \<const0> ;
  assign s_axi_rdata[27] = \<const0> ;
  assign s_axi_rdata[26] = \<const0> ;
  assign s_axi_rdata[25] = \<const0> ;
  assign s_axi_rdata[24] = \<const0> ;
  assign s_axi_rdata[23] = \<const0> ;
  assign s_axi_rdata[22] = \<const0> ;
  assign s_axi_rdata[21] = \<const0> ;
  assign s_axi_rdata[20] = \<const0> ;
  assign s_axi_rdata[19] = \<const0> ;
  assign s_axi_rdata[18] = \<const0> ;
  assign s_axi_rdata[17] = \<const0> ;
  assign s_axi_rdata[16] = \<const0> ;
  assign s_axi_rdata[15] = \<const0> ;
  assign s_axi_rdata[14] = \<const0> ;
  assign s_axi_rdata[13] = \<const0> ;
  assign s_axi_rdata[12] = \<const0> ;
  assign s_axi_rdata[11] = \<const0> ;
  assign s_axi_rdata[10] = \<const0> ;
  assign s_axi_rdata[9] = \<const0> ;
  assign s_axi_rdata[8] = \<const0> ;
  assign s_axi_rdata[7:0] = \^s_axi_rdata [7:0];
  assign s_axi_rresp[1] = \<const0> ;
  assign s_axi_rresp[0] = \<const0> ;
  assign s_axi_wready = s_axi_awready;
  assign xout = \<const0> ;
  decalper_eb_ot_sdeen_pot_pi_dehcac_xnilix_axi_lite_ipif__parameterized0 AXI_LITE_IPIF_I
       (.\GEN_BKEND_CE_REGISTERS[0].ce_out_i_reg[0] (s_axi_arready),
        .\GEN_BKEND_CE_REGISTERS[0].ce_out_i_reg[0]_0 (s_axi_awready),
        .Q(Dout),
        .Wr(Wr),
        .\bus2ip_addr_i_reg[4] (Addr),
        .bus2ip_rdce_i(bus2ip_rdce_i),
        .bus2ip_reset_int_core(bus2ip_reset_int_core),
        .bus2ip_wrce_i(bus2ip_wrce_i),
        .ce_out_i(\I_SLAVE_ATTACHMENT/I_DECODER/ce_out_i ),
        .s_axi_aclk(s_axi_aclk),
        .s_axi_araddr(s_axi_araddr[4:2]),
        .s_axi_aresetn(s_axi_aresetn),
        .s_axi_arvalid(s_axi_arvalid),
        .s_axi_awaddr(s_axi_awaddr[4:2]),
        .s_axi_awvalid(s_axi_awvalid),
        .s_axi_bready(s_axi_bready),
        .s_axi_bvalid(s_axi_bvalid),
        .s_axi_rdata(\^s_axi_rdata ),
        .s_axi_rready(s_axi_rready),
        .s_axi_rvalid(s_axi_rvalid),
        .s_axi_wvalid(s_axi_wvalid),
        .wrReq_d1(\IPIC_IF_I_1/wrReq_d1 ));
  GND GND
       (.G(\<const0> ));
  decalper_eb_ot_sdeen_pot_pi_dehcac_xnilix_xuart XUART_I_1
       (.Q(Dout),
        .Wr(Wr),
        .\addr_d_reg[2] (Addr),
        .baudoutn(baudoutn),
        .bus2ip_rdce_i(bus2ip_rdce_i),
        .bus2ip_reset_int_core(bus2ip_reset_int_core),
        .bus2ip_wrce_i(bus2ip_wrce_i),
        .ce_out_i(\I_SLAVE_ATTACHMENT/I_DECODER/ce_out_i ),
        .ctsn(ctsn),
        .dcdn(dcdn),
        .ddis(ddis),
        .dsrn(dsrn),
        .dtrn(dtrn),
        .freeze(freeze),
        .ip2intc_irpt(ip2intc_irpt),
        .out1n(out1n),
        .out2n(out2n),
        .rin(rin),
        .rtsn(rtsn),
        .rxrdyn(rxrdyn),
        .s_axi_aclk(s_axi_aclk),
        .s_axi_arready(s_axi_arready),
        .s_axi_awready(s_axi_awready),
        .s_axi_wdata(s_axi_wdata[7:0]),
        .sin(sin),
        .sout(sout),
        .txrdyn(txrdyn),
        .wrReq_d1(\IPIC_IF_I_1/wrReq_d1 ));
  LUT1 #(
    .INIT(2'h1)) 
    bus2ip_reset_int_core_i_1
       (.I0(s_axi_aresetn),
        .O(bus2ip_reset_int_core_i_1_n_0));
  FDRE bus2ip_reset_int_core_reg
       (.C(s_axi_aclk),
        .CE(1'b1),
        .D(bus2ip_reset_int_core_i_1_n_0),
        .Q(bus2ip_reset_int_core),
        .R(1'b0));
endmodule
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
