faberc/ece-540_wi21_fnl-project/(commit log)

2021-02-22 adding all files to github classroom
    [swervolf_nexys_debug.cfg, swervolf_nexys_program.cfg]
2021-03-02 Acceleration data filtered
2021-03-04 Developed working UART BLE hardware for acceleration reads
2021-03-05 Added BLE and UART initialization functions
2021-03-06 Added switch and button for advertising and sending of data
2021-03-08 Got the accelerometer to work on chuck's phone
2021-03-09 implementing JD connector for contingency
2021-03-13 Added dual view on large devices
2021-03-17 reorged folders
    [bot31_pgm.psm]
2021-03-18 added some comments to code and copied the rvfpga src code to the src folder
    [swervolf_nexys_debug.cfg, swervolf_nexys_program.cfg]
2022-07-07 Update uart_tx.sv
    Removing comments
