faberc/ece-540_wi21_fnl-project/(notices)

Notices in the files:
src/nexys_a7/rvfpga/src/SweRVolfSoC/Peripherals/uart/uart_defines.v:
Copyright (C) 2000, 2001 Authors
Public License as published by the Free Software Foundation;
Public License along with this source; if not, download it
from http://www.opencores.org/lgpl.shtml
src/nexys_a7/rvfpga/src/SweRVolfSoC/Peripherals/custom/wbpwmaudio.v:
modify it under the terms of the GNU General Public License as published
